PlanteAmigor/Piano_64/doc/720p先行与1080p优化.md

# 720p 先行与 1080p 优化

先交付 1280×720、约 60.606 Hz 完整功能固件，之后独立优化 1920×1080 60Hz。蓝牙 v3 收谱、SD 自动存储与目录刷新、多乐器自动演奏、教学兜底、三页界面和音频修复在两个目标中共用。

720p 保留 1650×750 的行场总周期，恢复此前板上可用的单 PLL：75 MHz 像素时钟、375 MHz 串行时钟，刷新率约 60.606 Hz。先前精确 60 Hz 的两级 PLL 固件在板上 HDMI 无信号，已撤回；声音和灯正常，SRAM 同固件对照仍无信号，说明故障集中于显示链路，具体模拟时钟原因尚未实测确认。逻辑界面坐标仍为 1920×1080，以 3:2 采样输出，页面无裁剪。

切换：`python3 tools/set_video_mode.py 720p` 或 `python3 tools/set_video_mode.py 1080p`。工具同时修改 RTL 模式头文件和像素/串行时钟约束，随后必须 `./build_full.sh` 完整构建。烧录前 `./flash.sh --check` 核对源码、固件及全局 setup/hold 均通过。

本轮共用优化：播放器和预览共享同一事件数组，后续继续检查物理 RAM 推断；FAT 扇区缓存合并为单写口；文件长度计算分级寄存；SD 校验计数按字节并行计算进借位。这些改动保持文件格式和播放行为不变。

720p 烧录后，1080p 实验在独立源码快照进行，板上保持已验证的 720p 固件；只有新的完整时序通过后才替换。

## 单 PLL 修复版验收

2026-11-04：用户确认相同固件临时加载后亮屏、三页正常。随后使用 openFPGALoader 完成 Flash 写入、100% 读回校验和重载，退出码为 0。固件 SHA-256 为 `7ec417b53ac864cedb204301f05d1f85b0a656a2c812bb86e7ae63e6755717c5`。全局 setup/hold 零违例，最小报告 setup 余量 +1.573 ns，BSRAM 329/340。用户随后确认断电重启后三页显示仍正常，Flash 冷启动验收通过。

旧标签 `720p-btsd-flash-20261104` 对应无信号的双 PLL 版本，已撤回使用，不移动该标签。新版本另建单 PLL 标签，交付记录保留失败经过。

## 低延迟720p更新

2026-11-04：第二版低延迟固件已由用户确认画面、按键与声音均正常，随后完成Flash写入与100%读回校验。当前固件SHA-256为`01198ac8a7547f963be728f345e2334af594c40e91f66b9439eac5f6e02bdff7`；按下确认0.5ms、释放确认20ms，18个数字链路场景最大2.794ms。此次冷启动仍待独立确认，详见[固化交付报告](720p_低延迟固化交付.md)。1080p实验继续独立推进。

2026-11-04追加确认：用户断电再上电后确认“断电重启后画面、按键和声音都正常”，本次低延迟720p的Flash冷启动验收通过。此前“冷启动待确认”描述为历史阶段状态。
