PlanteAmigor/Piano_64/doc/1080p30_完整候选.md

# 1080p30 完整版实测记录（2026-11-04）

## 当前状态

已通过离线检查，并用 openFPGALoader 成功临时加载 SRAM。用户随后明确回复“三页、按键和声音都正常”，完成本持续三页完整版本的实物验收。此前轮换诊断版的主页面、蓝色及独立彩条也全部可见；本次反馈独立对应完整版。

本1080p30.303完整版已于2026-11-04固化Flash并通过100%读回校验，用户已确认冷启动后三页、按键和声音正常；main已更新为本版。1080p60.606 完整工程的实物黑屏问题仍未解决。

## 模式与资源

- 输出：1920×1080，2200×1125 总时序，约30.303Hz；不是精确30Hz。
- 单 PLL，综合器确认像素75MHz、串行375MHz。
- 全局 setup/hold 违例：0/0；最小报告 setup 余量 +1.333ns。
- BSRAM 313/340，Logic 57976/138240，Register 41067/139095，DSP 157.5/298。
- FS SHA-256：`b415d6f7619be92d72ee1d4ecf28be18f72244677ebdc6c01758b69f92541508`。

## 验证

- `python3 tools/check_all.py --bt`：退出0，68条PASS，包括教学、真实曲谱、多音色、蓝牙原生SD写入再读回及远程播放、混响I²S等。
- 原厂 DPB/PLL/OSER10 模型专项通过；差分引脚独立解码验证上电及外部复位后完整UI非黑色行，未强制页面、亮度、计数器或RGB。
- 13张实际RTL页面渲染与上一完整1080p候选逐像素一致。首次渲染调用的Verilator路径错误，未生成有效结果；修正路径后的单独调用退出0，13张均通过，未将首次失败标为通过。
- 音频与按键源码指纹与此前18个端到端延迟场景完全一致，沿用既有测量，本轮未重测这些场景。原始按键引脚变化到完整I²S字的最大记录仍为2.794ms，前提为样本已预加载、有效静态手势及相同DDR等待模型；不含模拟DAC、功放、声传播，也不代表任意机械抖动上界。按下确认0.5ms、释放确认20ms。
- `tools/check_build.py`确认源码、约束、FS/BIN指纹一致，综合器时钟正确且全局setup/hold为0/0。
- 仅选择 SIPEED 2025030317；首次openFPGALoader SRAM加载退出0；随后已追加Flash固化及100%读回校验。

## 复现与证据

选择模式：`python3 tools/set_video_mode.py 1080p30-single`；完整构建：`bash build_full.sh`；功能检查：`python3 tools/check_all.py --bt`。

本地原始记录位于 `work/hdmi_production30/`：`results.json`、`auxiliary_verified.json`、`screens_compare.json`、`verification.json`、`board.json`、`acceptance.json`、构建与仿真日志；冻结的匹配固件及时序报告在 `offline_verified/`。`diagnostics/hdmi_link/program_production30.py`会复核上述门禁后只加载SRAM。

## 下一项60Hz实验

`diagnostics/hdmi_link/build_serial_clock.py`冻结独立快照，以150/750MHz输出1920×1080约60.606Hz，并让第四路OSER10输出固定时钟字，使时钟与三路数据经过同类串行输出路径。其独立引脚接收测试同时检查时钟字相位、RGB/同步和自然启动。这只是待验证的物理链路假设；通过数字模型或时序不代表实物黑屏已修复。实验不修改本1080p30生产输入，不自动上板或固化。

用户验收对应FS指纹与SRAM加载记录已关联；原始加载时的pending字段保留为当时记录，以独立`acceptance.json`记录后续通过。追加固化已完成并通过100%读回校验，用户已确认冷启动后三页、按键和声音正常。

固化记录见`1080p30_Flash固化记录.json`。原始RAR及其SHA-256保持不变；外部交付说明与验收文件追加本次固化状态，RAR内部仍保留打包时的SRAM验收状态。
