PlanteAmigor/Piano_64/doc/1080p60_串行时钟实验.md

# 1080p60.606 串行时钟对照实验（2026-11-04）

主工程1080p30.303完整版已由用户确认“三页、按键和声音都正常”，保存匹配固件作为回退点。Flash仍为已验收720p。

## 对照设计

独立冻结完整工程快照，模式改为单PLL150/750MHz；第四路OSER10串行输出固定字`0000011111`，使转发时钟与三路数据经过同类IO串行输出。原数据串行器和配置GSR策略保持一致。此为物理链路假设，不视为黑屏根因已确认。

`build_serial_clock.py`生成快照并验证：差分引脚接收的时钟字与数据字相位、RGB色序/完整行/HS，以及完整UI上电与外部复位后的非黑色行。全部使用原厂PLL/DPB/OSER10模型。

## 首次结果

`work/hdmi_serial_clock60`编译完成，综合器确认四路OSER10和150/750MHz。全局setup有2个违例，hold为0：

- 教学区路径`py -> roll_area1`最差-0.021ns。
- 叠加颜色至淡入路径`liss5 -> fade_g`为-0.013ns。

未加载该时序未通过固件。原始失败报告与输入指纹保留在快照中。

## 针对性修正

`--optimize-ui`生成另一个快照`work/hdmi_serial_clock60_opt`，不改主工程已验收30Hz输入：

1. 在写入py同一拍预计算教学区纵向范围标志，后续roll_area保持原像素拍数。
2. 用并行优先级掩码替换串联RGB图层选择，保持所有图层原先的覆盖顺序。
3. 保留rgb_base寄存器边界。

原厂模型的串行输出与自然启动检查已通过。`check_ui_equivalence.py`将两个真实UI模块并列运行，在512种叠加组合、16档淡入和随机颜色、全部12位坐标轴及另一轴窗口边界下比较RGB/淡入/区域标志的寄存器拍数，共81925周期一致；13张完整RTL页面与已验收30Hz版逐像素一致。该测试中的局部force只用于等价比较，不替代另行通过的无force自然启动检查。

修正版编译完成，但全局setup出现116个违例、hold为0，最差setup为-2.706ns，因此仍未上板。功能等价不代表物理时序通过；保留该失败布局证据，后续单独继续优化。用户要求先发布已验收1080p30，当前优先完成该版本打包和GitHub主分支更新。SD、蓝牙、音频、按键源码和物理约束未改，不通过放宽约束消除违例。上板入口`program_serial_clock.py --optimize-ui`只允许冻结输入匹配、全局setup/hold0/0、四路OSER10及上述等价检查均匹配的固件临时加载SRAM。
