PlanteAmigor/Piano_64/doc/1080p_黑屏排查.md

# 1080p完整工程黑屏排查（2026-11-04）

完整单PLL150MHz候选虽通过全局setup/hold 0/0、功能与延迟回归，但用户实测为“有信号但黑屏”，尚未交付验收通过。Flash及main仍保持已验收低延迟720p。

已完成对照：

- 重新加载此前单PLL150MHz彩条，用户确认彩条正常；这与完整工程黑屏形成同一显示连接下的对照。
- 新彩条仅换成当前完整工程使用的额外像素输入寄存器，FS为`c29fe32cba714bc15732725ab97001033a6e074ce44e667d44831120ab3ee708`；全局setup/hold 0/0、独立引脚解码通过，用户也确认彩条正常。
- 新增自然启动测试，不强制页面、亮度、计数器或RGB；没有外部上电复位脉冲时，完整UI仍输出非黑色画面。外部复位后同样通过。
- 完整UI与原厂PLL、DPB、OSER10、差分输出模型共同运行；上电和复位后各四条完整1920像素非黑色行均从差分引脚独立解码通过。该模型检查未复现实物黑屏。

目前尚不能把根因归于淡入、初始化或器件频率限制。完整工程与独立彩条的物理时钟布线不同，平均频率和数字模型仍不能证明实际串行链路可靠。

正在独立冻结快照`work/hdmi_black/full_debug`构建诊断版：保留完整音频、SD、蓝牙与UI；自动循环原UI、用UI同步输出固定蓝色、独立同步彩条、原UI，每档约1.342秒。UART暂时改发HDMI诊断状态，含锁定、复位、淡入级别、行列位置、帧计数及是否曾输出有效/非黑色像素。该多位跨域快照仅用于近似诊断，不用作产品数据协议。

构建入口为`diagnostics/hdmi_link/build_full_debug.py`，诊断快照的两条旁路经`check_full_debug_sim.py`验证，`program_full_debug.py`只允许输入指纹匹配、综合器时钟正确、全局setup/hold 0/0的快照临时加载SRAM。尚未加载或验收诊断版。

诊断构建进展：150MHz完整诊断版出现131个setup违例，hold为0，最差-2.720ns，未加载。新增诊断改变了物理布局，多条原UI路径余量不足；不以放宽约束换取通过。保留该快照，另建75/375MHz单PLL的完整1080p30.303诊断版（`--half-rate`），像素时钟与约束同步变更。这是用户已允许且彩条已实测显示的真实低刷新率模式，不把150MHz路径按75MHz假定检查。主工程及Flash仍保持原状态。

1080p30.303完整诊断版已通过：全局setup/hold 0/0，最小报告setup +0.629ns，75/375MHz时钟配置；两条诊断旁路的原厂模型引脚检查也通过。FS SHA-256为`50457fffc8eff4ed63e4a1f537e772d9063ac3efe5bb9c07bfcc03a29544e9b6`。加载时SIPEED 2025030317不在USB枚举列表中，openFPGALoader报告device not found，未改变板上固件；等待重新连接后立即加载。尚未宣称此完整诊断版实物通过。

最新实物结果：1080p30.303完整诊断版已成功加载，串口取得287个新状态样本，各模式均锁定、各路复位释放、淡入级别15，曾输出有效和非黑色像素。用户最终更正为原页面、蓝色及独立彩条“都看得到”，因此该诊断版三条图像路径实物显示通过；本轮未单独验收声音。下一步构建持续显示三页的正式1080p30候选；150MHz完整工程黑屏仍未解决。

正式1080p30.303完整候选已通过全局setup/hold 0/0，最小报告setup +1.333ns、68项功能回归和13张页面比对，通过源文件指纹核对沿用18项既有音频延迟记录。已成功临时加载SRAM，FS为`b415d6f7619be92d72ee1d4ecf28be18f72244677ebdc6c01758b69f92541508`；持续三页及音频等待用户验收。详细记录见`1080p30_完整候选.md/.json`。另建独立150MHz串行时钟实验，当前不宣称60Hz已修复。

最新验收：正式1080p30.303完整候选临时加载后，用户明确确认“三页、按键和声音都正常”。该版本可作为已实测的高分辨率回退点；仍未固化Flash，60.606Hz实验继续独立进行。
