PlanteAmigor/Piano_64/doc/1080p_单PLL完整候选.md

# 单PLL完整1080p候选（2026-11-04）

当前状态：1920×1080、约60.606Hz完整工程构建及数字验证通过，但用户实测“有信号但黑屏”，验屏失败。已重新加载先前同款单PLL彩条，用户确认彩条正常。用户已确认同款单PLL彩条正常；完整三页、音频与按键仍须单独实物验收。Flash保持已通过冷启动的低延迟720p。

## 时钟与构建

采用50MHz×15的750MHz单PLL；像素150MHz、串行750MHz。2200×1125总周期，对应60.606Hz，**不是精确60Hz**。可选`1080p30-single`采用相同VCO、75/375MHz，约30.303Hz，彩条也已由用户确认正常。

级联PLL的1080p30/60彩条未正常显示，1600×900 CVT-RB也无信号，完整实测矩阵见[多分辨率记录](HDMI_多分辨率实测.md)。平均计数和锁定状态正常仍不能代替抖动/眼图测量，物理根因尚未确认。

本次全局setup/hold均0违例，最差报告setup余量+0.005ns；BSRAM 313/340，Logic 57976，Register 41067，DSP 157.5。时序通过只对应本次报告条件。

FS SHA-256：`fdbd34467f1a0a12651968bd1eacd440ed179e7ae74b3c142410ba9abd2b50b3`。源文件、约束、hex及FS/BIN均由构建清单校验。

## 变更与验证

- 将已亮屏的单PLL链路接回完整工程，新增显式模式名`1080p-single`，同步生成实际150/750MHz约束；720p与旧精确60Hz实验模式仍可选择。
- 根据上一份原生分频完整构建的实际关键路径，将翻页计数器的6/12位进位条件提前寄存；全部118800拍、进位边界、回绕和复位逐拍检查通过。
- 第一轮150MHz完整构建有41个setup违例（最差-0.332ns）、hold为0，已保存且未上板。第二轮据此分开SD空闲扇区递增和范围判断；无复位描述符数据捕获不再经过复位使能扇出；串行器前增加独立的像素输入寄存器。
- 描述符响应中途复位后无参数写入，重新启动后全部53个真实音符、8类表、507115个元素与P64一致；新增串行级已通过实际生产PLL/串行器的独立引脚接收检查。
- 68条PASS完整回归，包括教学、多乐器、演奏键、持续管乐、揉弦、混响和蓝牙存SD。
- 13张使用原厂DPB模型的1080p页面/蓝牙状态图与原候选逐像素一致，原有界面优化保留。
- 原厂显示RAM及单PLL周期共7项专项通过。数据装载控制变更后已重新执行18个端到端延迟场景：钢琴2.794ms、古筝2.692ms、唢呐1.871ms、笛子2.056ms、钢琴加混响2.794ms，均小于5ms；源码指纹与当前工程完全匹配。

延迟测试以有效静态手势、P64已加载和指定DDR等待/刷新模型为前提，不含模拟DAC、功放、扬声器及声传播。按下确认0.5ms、释放确认20ms保持不变。

## 复现与验收

```bash
python3 tools/set_video_mode.py 1080p-single
./build_full.sh
python3 tools/check_build.py
python3 tools/check_all.py --bt
python3 tools/check_video_primitives.py
```

实验分支为`candidate/1080p60-after-keys-20261104`，主分支仍是已验收720p。源码中保留了用户此前在`src/add_engine_harm.v`注释前的空格改动；未混入提交，字节差异已记录于JSON。当前匹配固件和报告已另存`work/hdmi_single150_v2/offline_verified`。

先临时加载SRAM，检查显示器识别、三个页面、下落音符、频谱/李萨如、钢琴/古筝、管乐长按、混响和键盘快速/同时按下。用户确认前不把彩条通过等同于整机通过，也不将本候选写入Flash。断电仍恢复720p。

SRAM加载记录：openFPGALoader 返回0，FS指纹与本次构建一致，Flash未写入。重新加载的同款单PLL彩条再次由用户确认“正常了”；完整三页与声音验收尚待回复。

最新实物反馈：完整工程有信号但黑屏，彩条对照正常。完整工程未通过实物验收，正在检查实际像素输出、启动复位及与彩条的串行器差异。
