PlanteAmigor/Piano_64/doc/HDMI_多分辨率实测.md

# HDMI多分辨率实物对照（2026-11-04）

本记录替代此前“下载器未连接、全部候选待验屏”的阶段状态。用户重新连接SIPEED 2025030317后，以下彩条均已成功临时加载SRAM；Flash保持已通过冷启动的低延迟720p，未写入实验固件。

| 分辨率 | 计算刷新率/Hz | 像素时钟/MHz | 时钟方案 | 用户观察 |
| --- | ---: | ---: | --- | --- |
| 1280×720 | 60.606 | 75.0 | 单PLL | 彩条正常 |
| 1920×1080 | 60.000 | 148.5 | 级联PLL+原生分频 | 未正常显示 |
| 1920×1080 | 60.000 | 148.5 | 级联PLL独立像素输出 | 未正常显示 |
| 1920×1080 | 30.000 | 74.25 | 级联PLL+原生分频 | 未正常显示 |
| 1920×1080 | 30.303 | 75.0 | 单PLL | 彩条正常 |
| 1600×900 | 59.825 | 97.5 | 单PLL | 未正常显示 |
| 1920×1080 | 60.606 | 150.0 | 单PLL | 彩条正常 |

结论：在同一连接下，单PLL的1080p30.303和1080p60.606彩条均已显示；级联PLL的1080p30/60均未正常显示。级联时钟因此是重点排查对象，但尚无示波器抖动/眼图测量，不能认定物理根因。1600×900 CVT-RB约59.82Hz也未显示，尚不能区分显示器模式兼容性与该PLL配置因素。

本次通过的是1920×1080、约60.606Hz彩条，不是精确60Hz，也不是完整三页/音频功能验收。显示器信息页尚未独立确认。完整单PLL工程现已通过全局setup/hold 0/0检查（最小报告setup +0.005ns）、68条PASS回归、18个端到端延迟场景及13张原厂显存模型页面检查，并已临时加载SRAM；完整三页和声音仍等待用户验收。详见《1080p_单PLL完整候选》。

完整工程选择器新增`1080p-single`及`1080p30-single`，与既有`720p`、精确60Hz的`1080p`实验模式区分；工具同步修改RTL和约束，必须重建后使用。诊断新增综合器实际时钟计算核验，排除仅靠SDC或行为模型掩盖错误倍率的情况。首次1600×900分数配置在行为模型为97.5MHz、综合报告为95MHz，已在上板前撤回并保留为失败记录，改为25MHz×39÷10整数配置，才进行此次实物测试。

所有彩条加载前均检查源/固件指纹、全局setup/hold及独立串行模型。UART早期捕获含上一固件缓存，仅末尾窗口归于当前固件；后续加载工具已加入缓存清除和末尾计数核验。

复验：`diagnostics/hdmi_link/build_matrix.py`、`check_sim.py`、`program_probe.py`均支持上述模式。配套JSON保存每次实际固件指纹、UART原始记录及用户反馈。旧原生分频离线报告作为历史保留，其当前实物状态应以本表为准。

最新实物验屏未通过：用户反馈完整工程有信号但黑屏；重新加载先前彩条、以及替换为当前生产串行器的新彩条均正常。自然启动完整UI与原厂串行输出模型也已通过非黑色像素检查；完整诊断快照正在构建，根因尚未确定。参见《1080p_黑屏排查》。
