PlanteAmigor/Piano_64/doc/1080p60_原生分频诊断.md

# 1080p60 原生分频方案：离线验证与待验屏

日期：2026-11-04。当前状态：完整构建和数字验证通过，实物显示尚未验收。板上 Flash 仍是用户已确认断电重启正常的低延迟 720p。

## 本轮改动

实验分支：`candidate/1080p60-after-keys-20261104`。已合入主分支低延迟修复和冷启动确认；HDL基点为`6ef5e295ece43e6c35636a45c3599d7a71136568`。

- 1080p参考PLL采用曾测得27.5MHz输出的50MHz×22÷40配置。
- 742.5MHz串行时钟经原生CLKDIV五分频，提供148.5MHz像素时钟；像素与串行时钟使用同一输出源。
- 1080p的OSER10依赖配置GSR初始化并持续运行，像素编码器仍在锁定前保持复位。720p分支保持已验收方案。
- 同步更新时钟约束与构建检查，额外核对综合工具自己计算的频率。保留既有UI、教学、多乐器、混响、蓝牙存SD和低延迟功能。

以上仍是实验性显示链路修正，不能据此认定此前“无信号”的物理原因已经排除。

原厂[DS1239-1.0.3E 数据手册](https://cdn.gowinsemi.com.cn/DS1239E.pdf)第2.11.3节列出GW5AST-138的VCO范围650～1300MHz；当前参考PLL的1100MHz和视频PLL的742.5MHz均在此范围内。此项仅核对配置范围，不代替板上锁定、抖动或输出电气测量。

## 完整构建

1920×1080，2200×1125总周期，目标60Hz。实际源文件与FS/BIN指纹匹配，全局setup/hold为0/0违例，最差报告setup余量 **+0.016ns**。该余量很小，仅表示本次报告通过，不据此外推其他温度、电压或硬件条件下的裕量。

| 资源 | 使用/总量 |
| --- | ---: |
| Logic | 58056/138240 |
| Register | 41175/139095 |
| BSRAM | 313/340 |
| DSP | 157.5/298 |

FS SHA-256：`f87ef520aa4938fe0c855b57b9f522d3afaa2be38d43abab62e06f6dc0508978`。

构建保留了此前用户工作树中`src/add_engine_harm.v`的一处注释前空格差异，未将它混入本轮提交；完整字节指纹和该差异记录在配套JSON中。

## 验证结果

- `68`条PASS完整回归，包含菜单消抖、曲谱、混合乐器教学、真实P64参数、管乐持续、古筝揉弦、混响I²S，以及蓝牙→SD写入/读回/目录刷新/重试幂等。
- 18个真实按键→DDR仲裁→合成/效果器→完整I²S数据字场景全部低于5ms。最大值：钢琴2.794ms、古筝2.692ms、唢呐1.871ms、笛子2.056ms、钢琴加混响2.794ms。
- 原厂DPB、PLL、CLKDIV模型共7项专项检查通过；120000个混响立体声样点与独立模型一致。
- 独立串行接收器验证四组彩条诊断，检查启动及外部复位后的各四条完整彩条行，覆盖通道对齐、差分极性、RGB顺序、有效/总行宽和HS宽度。
- 原生分频方案另以13/117/499/713/999ns五种配置GSR释放时刻重复检查，全部通过；专项入口为`diagnostics/hdmi_link/check_startup.py`。
- 整帧2200×1125计数、HS/VS、坐标、帧回绕及RGB同步管线由完整UI时序回归验证。串行专项本身未遍历完整VS帧。

按下确认0.5ms、释放确认20ms保持不变。上述延迟以有效静态手势、P64预加载及指定DDR等待/刷新模型为前提，不包括模拟DAC、功放、扬声器和声传播，也不构成任意机械抖动下的全局上界。

## 实物状态与下一步

上一份独立PLL输出像素时钟的完整1080p候选曾时序通过、上板无信号，历史记录保留在`1080p60_候选验收.md`。

本次原生分频彩条的SRAM加载尝试失败：`unable to open ftdi device: -3 (device not found)`，未成功加载任何诊断固件。当前未检测到此前序列号2025030317的SIPEED下载器；没有改用电脑上其他板卡的下载器，也没有改动Flash。

接回同一下载USB并保持板子上电后，先运行：

```bash
python3 diagnostics/hdmi_link/program_probe.py div5_ref
```

只有加载成功后才确认彩条是否可见、显示器是否识别1920×1080 60Hz。诊断固件没有SD、音频和UI。若无信号，用`control720`做同一线缆/显示器对照，再比较其他1080p组；同时读取独立50MHz域UART中的PLL锁定状态和时钟计数。

彩条通过后，完整固件先执行`python3 tools/check_build.py`再临时加载SRAM，检查三页、教学下落音符、频谱/李萨如、四种音色、混响和演奏键。主分支与Flash只在实物验收后提升。断电可恢复已验收720p。

## 复验入口

```bash
./build_full.sh
python3 tools/check_build.py
python3 tools/check_all.py --bt
python3 tools/check_video_primitives.py
python3 tools/check_reverb_pipeline.py
python3 tools/check_key_latency.py
python3 tools/check_key_latency.py --timbre 0 --effect 1
python3 diagnostics/hdmi_link/build_matrix.py
python3 diagnostics/hdmi_link/check_sim.py
python3 diagnostics/hdmi_link/check_startup.py
```

同一时间只运行一个Gowin构建。配套JSON保存源码/固件指纹、测试退出码、各次延迟测量与串行诊断记录。数字仿真、全局时序通过均不能代替物理HDMI验屏。

更新：下载器接回后，原生分频和彩条级联方案均未正常显示，单PLL1080p彩条通过；当前结果见[多分辨率实物对照](HDMI_多分辨率实测.md)。本文件其余内容保留该次构建的历史状态。
