PlanteAmigor/Piano_64/doc/1080p60_候选验收.md

# 原生1080p60时序通过候选（2026-11-04）

当前状态：整机综合、布局布线和功能仿真通过，但上板显示失败（无信号），已撤回候选。首次临时加载因指定下载器未连接而失败；用户接回SIPEED下载器后，openFPGALoader已成功将上述固件加载到SRAM（退出码0）。用户确认显示器仍无信号，已成功恢复已验收720p至SRAM，720p Flash未修改。候选在独立分支保存，主工程仍保持已通过冷启动的720p版本。

## 实测构建结果

- 1920×1080，2200×1125总时序，148.5MHz像素时钟，精确60Hz。
- 全局setup 0违例，hold 0违例，最差报告setup余量+0.188ns。
- Logic 58987/138240；Register 41637/139095；BSRAM 313/340；DSP 157.5/298。
- 参考PLL：(50MHz/2)×33/30=27.5MHz，PFD25MHz，VCO825MHz；视频PLL：27.5×27=742.5MHz，/5生成148.5MHz像素时钟。
- FS SHA-256：83d85f4be99228dac00f6c039701e11602c0c1136c1b5fd9ad0c2111958d0d80。

## 本轮变更

文字ROM和李萨如扫描地址提前寄存；显存读写请求寄存后直接驱动八块正常写模式DPB；事件RAM共享端口A地址，使事件存储不再重复。分散显示复位与32个下落音符描述符的坐标扇出；进度条和力度条采用分段比较；翻页计数使用分段进位。混响梳状寻址分成多个短周期，SD引导区几何在接收期间提前计算。模式选择增加一个50MHz周期寄存。没有放宽像素时序约束，没有降低刷新率。

## 验证

- 完整功能回归含曲谱、教学、真实音色数据、持续管乐、揉弦、混响I²S和蓝牙→SD保存/读回链路。
- 普通行为模型与原厂DPB模型各13张RTL页面图，与基准逐像素一致。
- 原厂DPB三种规格的整块RAM独立Bresenham/清屏/衰减比较，以及级联PLL频率/锁定模型共7项检查通过。原厂仿真不能替代上板锁定和显示验证。
- 120000个混响立体声样点与独立取模地址/饱和模型一致，含满幅、反向、随机、旁通和50000样点静音尾音；覆盖245632个饱和边界。
- 256组FAT16/FAT32引导区参数以连续实际字节输入测试，独立核对分区、FAT、数据区和根目录地址（含32位回绕）。
- 翻页计数118800拍完整周期、全部进位边界、八组本地复位逐拍一致检查通过。

复验：`python3 tools/check_all.py --bt`、`python3 tools/check_video_primitives.py`、`python3 tools/check_reverb_pipeline.py`。页面原厂模型可用`python3 tools/render_ui1080.py --vendor-ram --bt`；`--verilator`可指定本机Verilator加速。视频原语工具的`--prim-sim`可指定安装的Gowin GW5A库。

## 上板待办

仅在`python3 tools/check_build.py`通过后，临时加载SRAM，不写Flash。检查显示器识别1080p60、三个页面、下落音符、实时频谱和李萨如；再试听钢琴/古筝、长按管乐和混响。用户确认后再提升主工程。

回退标签：`720p-flash-coldboot-ok-20261104`。断电重新上电仍启动此前已验收720p Flash。旧双PLL标签`720p-btsd-flash-20261104`为已撤回版本，不使用。

## 未混入的待办

演奏键目前仍20ms稳定消抖和40ms重触发屏蔽，尚不满足5ms按键到声音延迟要求。低延迟方案需单独实现并测端到端延迟。本候选也保留原115200蓝牙设置；BT36出厂波特率与网页握手问题另行核对，不能将协议仿真通过视为实物蓝牙问题已修复。

本文件保留的是低延迟合入前的失败候选历史；当前原生分频实验见[最新诊断记录](1080p60_原生分频诊断.md)。
