PlanteAmigor/Piano_64/doc/720p_低延迟固化交付.md

# 720p 低延迟固化交付

日期：2026-11-04。用户确认修正版画面、长按、快速连按、多键与声音均正常，授权固化和上传GitHub。主分支保留全部现有界面、教学、多乐器、混响与蓝牙存卡功能。1080p实验独立推进。

## 当前理论延迟与数字链路验证

50MHz下，演奏键按下连续确认25000周期，为0.5ms；同步及边沿检测另需数个时钟。音频采样周期20.48µs（48828.125Hz）。原来的40/120/340ms固定屏蔽已移除；声部分配时立即占位，旧尾音复用前先淡出，静音后才换参数。

| 通路 | 原始按键至完整I²S数据字的仿真最大值 |
| --- | ---: |
| 钢琴 | 2.794ms |
| 古筝 | 2.692ms |
| 唢呐 | 1.871ms |
| 笛子 | 2.056ms |
| 钢琴＋混响 | 2.794ms |

18个指定场景均低于5ms，覆盖首次起音、同键重按、和弦和尾音复用。测试实例化实际add_top、P64参数DMA、DDR仲裁、合成、限幅、效果器和I²S引脚接收；DDR模型包含64～72个100MHz周期的返回等待与周期性刷新背压。有效静态手势和P64已加载是前提。

这些数字是可复现的条件仿真结果，不是任意触点抖动或DDR等待下的全局上界，也未计入模拟DAC、功放、扬声器和声传播延迟。用户试听已确认正常，但未进行示波器/音频回录延迟测量。

释放采用20ms连续确认，避免2ms方案将长回弹误判为松键并重复起音；松开不足20ms的同键重按可能被合并。5ms目标指按下起音，释放确认时间与自然余音/效果器尾音另计。

## 验证与固化

68项PASS回归，全局setup/hold均零违例；报告最差setup余量+0.021ns，BSRAM329/340。时序余量较小，不据此外推温压条件之外的裕度。

用户已确认当前SRAM版本画面、按键和声音均正常。openFPGALoader已对同一固件完成Flash写入与100%读回校验，退出码0；本次断电冷启动尚待单独确认。先前UART两次窗口无字节仍作为独立诊断现象保留，未改光学代码。

固件SHA-256：`01198ac8a7547f963be728f345e2334af594c40e91f66b9439eac5f6e02bdff7`。

## 复现入口

```bash
python3 tools/check_all.py --bt
python3 tools/check_key_latency.py --timbre 0
python3 tools/check_key_latency.py --timbre 1
python3 tools/check_key_latency.py --timbre 2
python3 tools/check_key_latency.py --timbre 3
python3 tools/check_key_latency.py --timbre 0 --effect 1
./build_full.sh
./flash.sh --check
./flash.sh --ftdi-serial 2025030317
./flash.sh -f --verify --ftdi-serial 2025030317
```

完整工程入口为build_full.sh，默认720p；早期build.tcl和piano64.gprj只对应历史原型。SD卡使用真实P64.BIN和SONGxx.BIN。RAR包含当前Git源码、匹配固件与报告、验证日志、P64.BIN和原稳定720p回退固件；不包含Git凭据、.git或实验工作目录。

2026-11-04追加确认：用户断电再上电后确认“断电重启后画面、按键和声音都正常”，本次低延迟720p的Flash冷启动验收通过。此前“冷启动待确认”描述为历史阶段状态。
