PlanteAmigor/Piano_64/doc/曲谱教学模式设计.md

# 曲谱播放与教学交付说明

日期：2026-11-03。工程：`piano64_3`。本文件取代此前 `.P6S + DDR 曲谱区` 的设计稿；实际采用 v3 `SONGxx.BIN` 帧流和片内事件 RAM。M6+ 下落音符、BT36、SD 写入属于后续阶段。

## 交付状态

| 阶段 | 本次实现 | 验证边界 |
|---|---|---|
| 原工程优化 | 唢呐/笛子 DMA 顺序移位拆包；古筝音高控制寄存；顿音/吐音按采样计时 | 53 个音、8 类表、507,115 个元素与真实镜像一致；1600 采样保持及 16 采样音量斜坡通过 |
| M1 | v3 帧校验、事件 RAM、调度器、2048 条边界与异常拒绝 | SONG01 全部 47 条一致，0 ms 四声部同时处于 gate 高；四首歌曲共 104 条逐条回读一致 |
| M2 | P64 校验成功后第二遍列目录；按选择读取 SONG，跨时钟 FIFO 旁路到事件 RAM | 文件服务模型与真实读卡栈 + SDHC CMD/DAT 虚拟卡端到端通过，包含 FAT32 碎片簇链；真实卡上板待验收 |
| M3 | 音高/触发/gate/力度接入音频引擎，教学页旁路“无手静音” | 接线、仿真和 SIPEED SRAM 下载完成；DAC/扬声器听音仍待现场验证 |
| M4 | 歌曲列表、自动/教学模式、倒计时、按键指示、错误页、停止/返回 | 长短按、退出停止、损坏拒绝和重载恢复通过；5 张实际 RTL 像素截图已检查 |
| M5 | CDEFGAB 固定键位、跨八度共用、独立事件结束、±150 ms、节拍兜底与正确恢复 | 提前、迟到、黑键、错键、漏按、重复音、重叠窗口和 ±150 ms 边界均通过仿真 |

最终资源/时序数据见同包 `reports/build_summary.json` 和原始 Gowin 报告。只将来源一致、setup/hold 均无违例的构建登记为可下载版本。已通过 SIPEED 下载器完成板卡 SRAM 下载；现场听音和实际延迟仍待验收。

菜单消抖修复版完整构建于 2026-11-03 19:54 完成，采用布局算法 3、布线算法 2：Logic 40,629/138,240，Register 26,629/139,095，BSRAM 307/340，DSP 158/298；全局 setup/hold 违例均为 0，报告中的最小 setup 余量为 **+0.009 ns**。时序余量很小，本包固件对应本次已通过的布局布线；重新综合后必须重新检查时序，不能仅凭生成了位流判断通过。下载脚本的来源与固件哈希校验已通过。

## 上板操作

1. FAT32 SD 卡根目录放置 **真实四音色 P64.BIN** 以及 `SONG01.BIN`～`SONG04.BIN`。交付包 `sd_card/` 已备好；不要使用 `work/song_checks/P64.BIN`，它只是 2048 字节仿真夹具。
2. 首次使用 SRAM 临时下载：在工程目录执行 `./flash.sh --check` 核对构建，再执行 `./flash.sh`。脚本使用 `impl/pnr/piano64_full.fs`，板型 `tangmega138k`。需要长期保存时自行执行 `./flash.sh -f`。
3. 等待原有 P64 加载与校验。按板上 KEY0，页面按 **主页面 → 测试 → 教学 → 主页面** 循环。
4. 教学列表中，**R1[8]（第一排第 9 键）短按下一首**；**R2[8]（第二排第 9 键）短按确认**。
5. 选中歌曲后，R1[8] 切换 AUTO PLAY / TEACHING；R2[8] 开始。运行时 R2[8] 停止；**长按 R2[8] 约 0.8 秒返回**。长按释放不再重复触发确认。切出教学页会停止歌曲。
6. TEACHING 有 3 秒准备时间。**第一排 R1[0..6] 固定对应 C D E F G A B**，与八度、原手动音色的键位映射无关；R1[7] 不参与教学判定。LED 提示音级，画面 `*` 表示需按，`+` 表示已匹配。

菜单 R1[8]/R2[8] 使用独立两级同步与双边 40 ms 消抖：按下、松开都必须连续稳定，短按在确认松开后只执行一次，持续按住不连发。演奏键仍沿用原扫描路径。`tb_song_keys` 用同一抖动波形复现旧版一次跳三首，并验证修复后一次一首、模式/确认不重复及长按返回释放抑制。

演奏键 R1[0..7] 使用两级输入同步和稳定电平模式：按下和松开都必须连续稳定 `DEBOUNCE`（默认 20 ms）才更新，避免单触点微动开关的松开抖动将一个按键变成虚假的松键/重按。实际音符键在全工程此前也已等待 20 ms 才确认按下；本修复将相同确认规则应用到松开，并为 `key_scan` 补上原来缺少的异步输入两级同步。`tb_key_scan_bounce` 对比旧版和修复版，检查旧扫描在释放抖动后产生假边沿/卡键，而新扫描每次真实按键只产生一个按下、一个松开。数字仿真覆盖的是同步后抖动行为，不能模拟真实模拟亚稳态或证明板上噪声的全部来源。

复音分配器的键归属增加一个可表示空闲标记的位宽，避免八键配置下 `KEY_FREE=7` 与真实键 R1[7] 冲突。旧版可复现第八键松开后 gate 仍保持高；`tb_note_alloc_release` 检查八键各分配一次、第八键独立松开及全部 gate 清零。

列表按照 FAT 枚举顺序显示文件本来的两位编号，不假定它们连续或按编号排序；最多 16 首、每页 8 首。精确匹配大写 `SONG00.BIN`～`SONG99.BIN`，不读子目录。

示例曲谱：SONG01《小星星》钢琴 47 事件；SONG02《茉莉花》古筝 30 事件；SONG03《小星星》唢呐 14 事件；SONG04《茉莉花》笛子 13 事件。

## 教学发声规则

- 到曲谱节拍时，即使没有手、没有按键，白键音符仍按**该事件正常力度的一半**准时起音，持续到各自曲谱结束。漏按不拖慢后续节拍，也不会因等待按键丢掉旋律。
- 在事件前 150 ms 内按对，对应起音使用正常力度；在事件后 150 ms 内按对，当前半力度声音按每毫秒增加 8/255 的速度恢复到正常力度，**不重新触发音头**。这些数值是引擎线性力度值，听感响度并非严格减半。
- 正常引擎力度为 MIDI velocity×2，兜底为 MIDI velocity；例如曲谱力度 100，对应正常 200、兜底 100。教学且有手时再叠加光学力度；自动模式不要求手参与。
- 同一时刻、同一音级的多八度和弦共享一次正确按键，各事件仍按独立时长结束；相邻重复音不能重用之前的提前按键。重叠判定窗口中的迟到按键优先对应最近已起音的一组。
- 已匹配的白键声部随对应物理键松开而释放；未匹配的半力度兜底保留曲谱时长。引擎原有自然包络、延音效果仍影响最终声音尾部。
- 黑键音符正常力度自动播放，不参与键盘判定。按错不会另触发声音；错误按键在匹配等待窗口结束后计数。
- 钢琴/古筝最多 8 声部；唢呐/笛子沿用原工程共享单音参数缓冲，限 1 声部。音高和音色由文件决定。

## 数据链路与接口

```
原有 P64.BIN → 原有 SD→DDR→读回校验
                         ↓ 成功后
SD 第二遍列目录 → SONGxx.BIN 字节流（晶振 50 MHz）
  → Gray 指针异步 FIFO → 帧解析/校验（音频 50 MHz）
  → 2048×64 事件 RAM → 毫秒调度/教学判定 → 原音频引擎
  → 原子状态快照握手 → HDMI 75 MHz 教学页
```

SONG 字节不进入 DDR 音色镜像写入 FIFO。文件结束后，必须排空跨域 FIFO、解析 FIFO 和帧状态机，再提交可播放结果，防止 END 尚未处理就开始播放。每次新文件重置解析事务；加载取消后继续排空旧传输，再允许下一次请求。

事件 RAM 131,072 bit，目标占 8 块 BSRAM；完整链路还有解析和跨域 FIFO。不要把整机资源增量都算成事件 RAM。保持原异步时钟约束，没有通过给新增同步路径设假路径消除违例。

v3 帧：`A5 5A 03 | type:u8 | seq:u8 | payload_len:u16LE | payload | crc16:u16LE`。CRC16/CCITT-FALSE 覆盖帧头到 payload，poly=0x1021，init=0xFFFF。

- BEGIN(type=1)：`count:u16, duration_ms:u32, timbre:u8, flags:u8`，flags 使用 0。
- DATA(type=2)：`offset:u16` 后跟最多 32 条事件。
- 事件：`start_ms:u32, note:u8, duration_ms:u16, velocity:u8`，共 8 字节，全小端。
- END(type=3)：`count:u16`；实际写入数必须与 BEGIN/END 一致。
- 最大 2048 事件，按开始时间非递减排列，时长非零，力度 1..127。必须符合对应音色音域和并发上限。错误不允许提交成可播放曲谱。

## 复现与维护

```bash
# 生成四首样例并自检；默认写入 tools/generated/
python3 tools/gen_song_v3.py

# 数据、教学、SD 接口、DMA、原音频控制回归
python3 tools/check_all.py

# 加上选歌/模式/教学/错误/等待五页的实际 RGB 渲染
python3 tools/check_all.py --ui

# Gowin 完整工程构建，并登记时序与来源指纹
./build_full.sh
# 其他安装位置可配置：GOWIN_SH=/绝对路径/gw_sh ./build_full.sh

# 校验源码、固件哈希及零时序违例；不连接硬件
./flash.sh --check
```

需要 Python3、Icarus Verilog；截图额外需要 Pillow；完整构建使用 Gowin V1.9.11.03 Education，器件 GW5AST-LV138PG484AC1/I0 Version C。产物为 `impl/pnr/piano64_full.fs` 和 `.bin`，默认下载 `.fs`。

主要变更：`src/song/song_system.v` 管理跨域流、RAM 和菜单；`song_loader.v` 管理协议校验；`bt_song_player.v` 管理节拍和教学；`sd_ddr_loader.v` 扩展第二次目录扫描；`add_top.v`/`piano64_top.v`/`hdmi_ui3_top.v` 完成接线和显示。

回归产物保存在 `work/song_checks/`，包括逐条 RAM 回读、各测试日志和五张 `ui0..4.png`；`tools/check_all.py` 会在缺少真实 P64.BIN 时明确失败，不会把短仿真镜像冒充音色数据。

## 现场验收剩余项

- 用真实 SD 卡冷启动，确认四音色镜像校验、第二遍目录和四首曲谱均能读取；交换文件写入顺序再验证编号正确。
- SRAM 下载本包固件，听 SONG01 开头四声部和弦厚度；确认无手也发声，停止/返回/切页不遗留持续音。
- 教学模式听提前、迟到、完全漏按、错按、黑键，确认半力度兜底与恢复没有重复音头；检查光学表情和按键/LED 对应。
- 使用耳机或示波器测量实际键控到音频输出延迟与异常噪声；仿真和时序通过不替代赛题要求的现场测量。

参考沿用工作区 `ref/bt36_v3` 协议/调度器、`ref/FPGA-SDcard-Reader` 读卡栈、现有 Gray 指针 FIFO 与赛题要求；未额外引入可综合 IP 依赖。SDHC 仿真使用同一开源项目的 `sd_fake.v`，位于 `sim/vendor/`，随附原 GPLv3 许可。原有手动工程中的用户未提交注释空格改动已保留。

### 笛子 / 唢呐长按持续发声（已更新）

- 保留约 1 秒的原始起音；随后在原音色约 1～2 秒稳态参数段连续往返，保留原生气颤及包络变化。每次坐标只移动一个样点，载波始终正向积分，避免冻结参数后气颤消失。长按不重触发、不重新搬运 DDR 表。笛子取消额外手势颤音，唢呐保留手势音高颤音。
- 移除 5 秒绝对停音上限；手动按键和曲谱均由 gate 决定时长。松键默认收音，开启延音时仍按原释放增益淡出；手离开仍经原手势闸门静音。
- 独立 29 位 dm 相位时钟，模 2^29 回绕。由于 dm 为整数，dm×11×2^29/1024 是整圈相位，回绕无相位突跳，避免长按约 21 秒时旧 20 位时间计数器溢出。
- `sim/tb_harm_hold.v` 读取真实 P64.BIN，经实际 DMA 和谐波流水线检查全部 53 音的稳态转接、持续非零 PCM、相位运行、弯音、时钟回绕、手离开/返回以及 gate 释放。为缩短仿真，跳过起音前段与每样点计算完成后的空闲时钟，并把独立相位时钟推进到 10 秒；并非逐时钟完整模拟 10 秒。听感仍需上板验收。

- 加强 PCM 正负半周检查后，旧谐波编号错误在笛子 MIDI 76 暴露：表索引 0 被直接当作谐波阶数 0。原始拟合与渲染模型（上级 `tools/harm_fit.py`、`tools/dizi_render.py`）使用 1..K。引擎现将合成阶数改为表索引 + 1，HDMI 分量显示索引仍为 0..K-1，避免基音被合成为近直流分量。

### 2026-11-03 琴键与持续吹奏版本上板记录

- 功能提交：`8a26158`（输入同步、双边消抖、第八键释放），`6ac9775`（持续吹奏、谐波阶数）。完整功能回归通过，真实 P64 的 53 音波形检查通过。
- 最终完整构建：setup/hold 违例均为 0；最差报告 setup 裕量 0.000 ns（现有 DDR 命令/地址路径），该路径余量较紧，后续修改仍需完整时序检查。
- 资源：Logic 40531/138240，Register 26510/139095，BSRAM 307/340，DSP 160/298。
- FS SHA-256：`091772ebf40e29970d2e818277fdfb71fd1f815ef298589cf54b27020634a1be`。
- 已通过 openFPGALoader 下载目标 SIPEED 调试器 `2025030317` 对应板卡 SRAM，返回 `DONE`，退出码 0。SD 文件无变化。
- 用户此前反馈：仅含双边消抖的中间固件暂未再出现炸音。最终组合固件的多键和持续 30 秒听感仍由用户上板复测确认。

### 原生气颤、古筝揉弦与李萨如修复

- 按用户确认，笛子仅使用音色自带气颤，不再叠加 G3 幅度/音高颤音。独立 AM 控制在顶层关闭，谐波引擎也固定单位增益。
- 唢呐/笛子的持续段采用参数往返读取，载波正向积分；端点不跳坐标。修正无符号 Q13.19 相位表跨 bit31 的插值，避免高音在约 2 秒处错误插值。
- 古筝揉弦与唢呐颤音的检测参考工作区五组实测光学记录：原有 12.5% 幅度门限、5～11 帧半周期拒绝全部 499 帧揉弦记录。改为约 3.125% 门限（最低 256）、4～24 帧半周期，同时要求至少两个新鲜有效交替间隔。静止/慢移测试无误触发，原揉弦记录 138/499 帧激活；收尾仍有保持时间。记录未包含横向位置，不能据此判定横向摇手的完整分类效果。
- 修正音高调制三角波后半段的位宽翻转，消除平均音高抬升。古筝真实模态引擎输出验证：调制比值 15872～16895，10918/11000 个 PCM 样点与未调制输出不同，手势结束回到中性音高。
- 钢琴/古筝李萨如默认 L4 短余辉、MID 平滑；切回吹奏音色恢复其默认档位，R2[0]/R2[1] 仍可手动调整。峰值参考两轴，新音清除旧轨迹，微弱尾部不再自动放大噪声。
- `tools/check_all.py --ui` 全部通过，包括实际 P64 的 53 音长按、松键/无手静音、原生气颤、光学记录回放及五页 HDMI 输出。`tools/check_sustain_curve.py` 检查全部 53 音载波正向及两端转向频率连续；`tools/check_liss.py` 提供修改前后轨迹比较（需 Git 基线 5ec3098、NumPy/Pillow）。
- 李萨如对比图使用真实 P64 参数生成模态输入，运行实际显示滤波、自动增益、画线及余辉 RAM；属于仿真图，不是板上照片。长按测试对关键位置加速推进，没有逐时钟渲染完整 30 秒音频；自然听感与实际手势舒适度需现场确认。

### 原生气颤 / 揉弦 / 李萨如版本上板记录

- 功能提交：`d70d2a8`。完整功能与 UI 回归全部通过；补充的 unsigned 相位跨 bit31 向量检查通过。
- 2026-11-03 21:30 完整构建结束，原布局 3 / 布线 2 与原约束：setup/hold 违例均为 0，最差报告 setup 裕量 +0.002 ns。余量仍紧，后续改动必须重新检查完整时序。
- 资源：Logic 40517/138240，Register 26499/139095，BSRAM 307/340，DSP 159.5/298。
- FS SHA-256：`4e1ac800a0ddb56f26f711a29bc6d3a77a24cb82e850f829a4c271e82807e594`。120 项构建输入及位流哈希通过 `flash.sh --check`。
- 已用 openFPGALoader 对指定 SIPEED 调试器 `2025030317` 完成 SRAM 下载，退出码 0，日志含 `DONE`；SD 文件无变化。实际长按气颤衔接、揉弦手感与李萨如屏幕效果待用户现场确认。

### 混响开启时噪音：I2S 样点完整性修复

用户确认四种音色均在混响弹奏时出现噪音，关闭后干净。混响算法文件并未在上一版变化，但原 `pcm5102a_tx` 每发送一位都会重新读取输入。混响在帧首 tick 后约 52 个系统时钟才更新，早于发送完成、晚于首个数据位，左声道因此可能混合前后两个样点的位；右声道又可能提前使用新样点，导致左右时刻不一致。

修复在左帧边界同时锁存左右 16 位输入，整帧序列化只读这份快照。采样节拍、BCK/LRCK 和 I2S 一位延迟不变；增加固定一帧（约 20.48 µs）输出缓冲。

新增 `sim/tb_i2s_reverb.v` 将实际混响模块接到实际 I2S 发送器，再从 BCK/LRCK/DIN 引脚解码，检查整帧快照、左右时刻、延迟位/填充位和 1024 时钟采样周期。3000 个立体声帧共 6000 个声道字，实际混响在发送期间更新 3001 次，包含 1761 个湿声样点：旧版 5564 个字与帧快照不一致，修复版为 0。旧版首帧左声道本应为 0，却输出 6808（既不是旧的 0，也不是新的 15000），直接复现位拼接损坏。该测试已纳入完整功能回归。

旧 `tb_rev_full.v` 的长尾检查仍显示约 −180 LSB 的负向量化残留，其 RMS 统计多累计了每样点 60 个时钟，显示值放大了 sqrt(60)。该旧检查不验证最终 I2S 比特流，不能用于证明演奏期间串行输出正确。本修复针对已复现的 I2S 损坏，保持现有混响滤波参数。实际噪音是否消失仍需同板听音确认。

#### I2S 混响修复完整构建及上板记录

- 功能提交 `3ab13f6`。完整功能回归全部通过；I2S 引脚级检查 6000 个声道字零错误。UI 无改动，沿用此前五页像素回归结果。
- 2026-11-03 22:00 完整构建完成，原布局 3 / 布线 2、原约束；setup/hold 违例均为 0，最差 setup 裕量 +0.002 ns。后续修改必须重新检查完整时序。
- 资源：Logic 40508/138240，Register 26531/139095，BSRAM 307/340，DSP 159.5/298。
- FS SHA-256：`0c70a6f07df44aba0b7e2ff2b3104ef490ee354823b3d64b9cf93c94f88423b9`；全部 120 项输入和两个位流哈希校验通过。
- openFPGALoader 对指定 SIPEED 调试器 `2025030317` 完成 SRAM 下载，最终 `DONE`、退出码 0。SD 卡数据未改动。四音色 NONE/REVERB 对比听音待用户现场确认。
