PlanteAmigor/Piano_64/doc/谐波引擎进度交接.md

# 谐波引擎（笛子 / 唢呐）进度交接

日期：2026-10-25
分支：`main`（`/mnt/project/InstruementSound/piano64_handoff/piano64`）

---

## 一、一句话总结

**笛子、唢呐的 4 声部实时合成引擎已经做完并验证通过**，RTL 和参数表都就绪，
可以直接上板。还差**顶层接线**（把钢琴引擎换成谐波引擎）和**按键方案**（等定）。

---

## 一点五、解决了什么（原始判断 vs 实测）

交接最需要说清楚的就是这一节。队友最初的几个判断，实测下来分成两类：
**有的根本不成立（资源其实够用），有的是真问题但已经解决（谐波吞吐）。**

### ①「256 分量放不下」→ 不成立，128 分量只用 34% BSRAM

原分析：256 分量 = 138% 资源，不可行。

四个根因错误：

| 原始假设 | 实际情况 |
|---|---|
| 每个声部要独占一份 ROM 表 | **4 个声部共享同一份表**（同时刻最多一个声部在查表） |
| 布线延迟「大约 10 ns」是猜的 | 实测引擎内部路径 **13.4 ns**（含布线），不是 23 ns |
| 分量越多越慢 | 反了：改成 **16 级流水**后路径从 15.1 ns 降到 **9.3 ns** |
| 「48 条 setup 违例，最差 −10.00 ns」 | 实测 **1 条**（I2S 输出 −0.085 ns） |

**实测钢琴整机（88 音 × 128 分量）：BSRAM 114/340 = 34%，Logic 3%，时序 slack 余量充足。**

### ②「谐波 16 拍一个，来不及」→ 已解决，1 谐波/时钟

详见正文第二节 2。8 个并行 bank + 5 级流水，4 声部最坏 **292/1024 拍**。

### ③「笛子要 256 个分量」→ 是误会，笛子 K 由奈奎斯特决定

| 乐器 | 分量数来源 | 实际值 |
|---|---|---|
| 钢琴 | 固定 slot | **128**（88 音 × 128 = 11264 行） |
| 古筝 | 固定 slot | **128**（49 音 × 128 = 6272 行） |
| 笛子 | K = ⌊(fs/2)/f₀⌋ | **15 ~ 62**（MIDI 67..91） |
| 唢呐 | K = ⌊(fs/2)/f₀⌋ | **11 ~ 55**（MIDI 69..96） |

- **256 只属于模态乐器（钢琴/古筝）的候选分量数**，跟笛子唢呐没关系。
- 钢琴实测 128 个分量里 **128 个都在 −40 dB 以上**（最少 65 个），确实是满的；
  古筝只有中位数 **66 个**在 −40 dB 以上，**128 是够而有余**。
- 反过来若真要 256：因为 4 声部共享表，256 也只是 BSRAM ~68%，
  能放但没必要（古筝 128 已经用不完）。

### ④ 修掉的两个真 bug

| Bug | 影响 |
|---|---|
| `A` 定标用 Q3.13（±4.0） | 笛子最大 4.48、唢呐最大 6.83 → **9 个音的谐波被削顶**。改 Q4.11（±8.0） |
| 单声部引擎 6 个 RTL bug + 4 声部引擎 6 个 RTL bug | 见 git log `5fad12f` / `73b1ac4`，插值符号扩展、Φ 高 16 位漏读、Ψ 索引 0xFFFF、流水 valid 少一级等 |

### ⑤ 时序与资源（一页看完）

**两份设计现在都是 0 条违例。**

| 设计 | Logic | BSRAM | SETUP 最差 | HOLD 最差 | 违例 |
|---|---|---:|---:|---:|---:|
| 钢琴整机（现在能烧） | 2893 (3%) | 114 (34%) | **+9.501 ns** | **+0.237 ns** | **0 / 0** |
| 谐波引擎 4 声部（独立综合） | 2118 (2%) | 264 (78%) | **+3.265 ns** | **+0.196 ns** | **0 / 0** |

原来是 **1 条 setup（−0.085 ns）+ 22 条 hold（−0.726 ns）**，三处修复：

| 问题 | 根因 | 修法 |
|---|---|---|
| 22 条 hold | `ws2812_keyind` 用 `CLOCK_50` 直连，但控制信号全在 `clk_sys` 域；两条时钟树（PBR1/2 与 PBR2/3）偏斜 ≈0.7 ns | `add_top.v` 加两拍同步器跨域 + SDC 声明 `set_false_path`（标准 CDC） |
| 1 条 setup | `set_output_delay -max 10.000` 把 20 ns 周期的一半让给板外，内部只剩 10 ns | 放宽到 `8.000`（PCM5102A 只要几 ns） |
| 谐波 2 条 setup | 默认布局选项在 78% BSRAM 下布线拥塞（路径里 5~6 ns 全是走线） | `place_option 2` + `route_option 1`，slack 从 −0.074 → **+3.265 ns** |

详细路径、原始报告、每样点拍数预算见 **`doc/时序报告/README.md`**。

### ⑥ 外设逻辑没动（只加了一个 CDC 同步器）

`git diff --numstat` 逐个核对，以下 11 个外设文件 **0 改动**：

```
ws2812_keyind.v  key_scan.v   note_alloc.v  pcm5102a_tx.v  mix_sum.v
piano64.cst      add_param_rom.v  add_sine_lut.v
pll50.v          pll_init.v   gowin_pll/gowin_pll.v
```

`add_top.v` 改了 **三处**，语义都没有变：

1. 例化引擎那一段（`add_engine8` 的宏参数）—— 128 分量
2. **灯带控制信号加两拍同步器**（`clk_sys → CLOCK_50`），消掉 22 条 hold 违例；
   `u_led` 仍是 `CLOCK_50` 直连，WS2812 协议时序一模一样
3. `piano64.sdc`：`output_delay -max 10.000 → 8.000`，并声明 `CLK_SYS → CLOCK_50` 为 CDC

**钢琴工程现在照样能编译、能烧、能响，而且时序 0 违例。**

---

## 二、完成了什么

### 1. 数据层：笛子 / 唢呐的谐波表（已完成）

从拟合好的 npz 生成 FPGA 用参数表：

| 乐器 | 音域 | 谐波数 K | 表大小 |
|---|---|---|---|
| 笛子 | MIDI 67..91（G4..G6，25 音） | 15 ~ 62 | 3.24 Mbit |
| 唢呐 | MIDI 69..96（A4..C7，28 音） | 11 ~ 55 | 3.32 Mbit |

压缩手段：Env 用 int8 + 每谐波峰值缩放（16 位 → 8 位，省 55 块 BSRAM）；
起振项预乘进包络（RTL 不用算指数）；A/φ 形式（每次只查一次正弦）。
表相对 npz 的拟合精度 ≈ 42 dB。

**顺带修了一个旧表就有的 bug**：`A` 原来是 Q3.13（±4.0），但实测
笛子最大 A=4.48、唢呐最大 A=6.83 → 9 个音的谐波被削顶。改成 Q4.11（±8.0）。

### 2. RTL：4 声部全流水引擎（已完成）

```
src/add_engine_harm.v   4 声部流水引擎（1 谐波/时钟）
src/harm_rom.v          8 个并行表 bank
```

原方案一个谐波要 16 拍（9 次串行表读 + 6 拍算术），K=62 时一个声部就吃掉
1003 拍，**只够 1 个声部**。新方案把表拆成互相独立的 8 个 bank 并行读，
再上 5 级流水线：

```
S0 发地址 → S1 Env/Ψ 插值 → S2 相位合成 → S3 幅度合成
→ S4 正弦插值 → S5 累加
```

| 场景 | 每样点拍数（预算 1024） |
|---|---|
| 1 声部（最低音 K=62） | 74 |
| 4 声部同音（最坏情况） | 292 |
| 4 个不同音 | 205 |

### 3. 验证（逐点比对，不是只看 SNR）

| 测试 | 结果 |
|---|---|
| 1 声部 MIDI 67 vs 已验证的单声部引擎 | SNR 47.8 dB |
| 1 声部 MIDI 72 | SNR 66.0 dB |
| **4 声部同音** | **逐点完全一致（maxdiff=0）** |
| **4 个不同音 vs 4 次单声部输出之和** | **maxdiff=3（只是取整）** |

两套 RTL 用完全不同的表格式和调度，能逐点对上说明寻址 / 流水 / 定标全对。

### 4. 综合（Gowin GW5AST-138C，50 MHz）

```
Logic      2118 / 138240  (2%)
Register    744 / 139095  (<1%)
CLS        1571 / 69120   (3%)
BSRAM       264 / 340     (78%)
时序        0 条违例（SETUP 最差 +3.265 ns，HOLD 最差 +0.196 ns）
```

> 完整时序报告（两份设计的原始 `.timing_paths` / `.rpt.txt` + 摘要）见
> **`doc/时序报告/README.md`**

---

## 三、还差什么

### A. 顶层接线（代码活，我可以做）

把 `add_top.v` 里的 `add_engine8`（钢琴引擎）换成 `add_engine_harm`。
两者端口是特意对齐的，替换本身只改例化那几行，但要配三件事：

1. **表文件进工程根目录**（11 个 `.hex`，和 `add_param0.hex` 同级）
2. **只烧一个音色**：BSRAM 78%，钢琴表和笛子表不能同时驻留。
   `build.tcl` 里按 `TIMBRE_SEL` 二选一
3. **音量重定**：`sat_gain` 现在是 ×4（按钢琴单音峰值 1951 定的）。
   笛子满刻度是另一个量级，`MIX_SHIFT` 和 `sat_gain` 要重新算

### B. 按键方案（等队友定，我不动）

现状：`piano64.cst` 只接了 7 个键

| 引脚 | 现在功能 |
|---|---|
| KEY[0..5] | 6 个音键（do re mi fa sol la） |
| KEY[6] | 模式键（切曲谱） |

`note_alloc.v` 已经支持「每个音色一张 STEP 表」（`KEY_STEP` 是 parameter），
所以**换音色不用改电路**：只要喂不同的 `{NOTE_BASE, KEY_STEP}` 就行。

需要定的两件事：
- **八度键放哪**（KEY[6] 循环？还是从 J14 再引两个脚？）
- **每个音色的 6 个音键要什么音阶**（大调 / 五声 / 其他）

定下来之后，改动只在 `add_top.v` 的一个参数表里。

### C. 已知行为差异

笛子表只有 **3 秒**。按住键超过 3 秒声音就结束（不像钢琴一直衰减）。
目前 `v_gate` 没接进引擎，**松键不会立刻停**。
如果需要「松键即停」，要在 `add_engine_harm` 里加一条 gate 处理。

---

## 四、怎么验、怎么跑

```bash
export TMPDIR=/mnt/project/InstruementSound/.tmp     # 绝不用 /tmp
export LD_LIBRARY_PATH=/mnt/project/ov-cli/Gowin/IDE/lib
export QT_QPA_PLATFORM=xcb
/mnt/project/ov-cli/Gowin/IDE/bin/gw_sh build.tcl    # 无需 license

# 重新生成表
cd tools
python3 npz2hex_harm2.py --dir /mnt/project/InstruementSound/out/dizi/谐波 \
    --pattern 'harm_DiZi_M*.npz' --prefix dizi --outdir ../../.tmp/tables_harm2

# 仿真验证（4 声部同音应与单声部逐点一致）
cd ../sim/harm2
iverilog -g2012 -o eng.vvp -s tb_engine_harm ../../src/add_engine_harm.v \
    ../../src/harm_rom.v ../../src/mix_sum.v ../tb_engine_harm.v
vvp eng.vvp
```

---

## 五、文件清单

**新增 RTL**
```
src/add_engine_harm.v   4 声部全流水引擎（主力）
src/harm_rom.v          8 个并行表 bank（dizi / suona 各一份）
src/add_voice_harm.v    单声部串行版 —— 保留作黄金参考，改新引擎时逐点比对它
```

**新增工具**
```
tools/npz2hex_harm2.py  多 bank 表打包生成器（当前使用）
tools/npz2hex_harm.py   旧单 ROM 表生成器（保留，配 add_voice_harm）
tools/gen_harm_aux.py   生成 u(t) 表 + 正弦表
tools/check_harm2.py    新旧表打包无损校验
tools/cmp_harm_sim.py   旧表 + 旧 RTL 的浮点参考
tools/cmp_engine.py     两套 RTL 逐点比对
```

**新增仿真**
```
sim/tb_engine_harm.v  1 声部        sim/tb_engine4.v    4 声部同音
sim/tb_engine4d.v     4 个不同音     sim/tb_engine72.v   1 声部 72 号音
sim/tb_engine_v1.v    只触发声部1    sim/tb_engine_v2.v  只触发声部2
sim/tb_voice_harm.v   单声部引擎基准  sim/tb_hdbg.v       逐拍调试
```

**未改动**（重要）
```
src/ws2812_keyind.v  src/key_scan.v  src/note_alloc.v
src/pcm5102a_tx.v    src/mix_sum.v  src/piano64.cst/.sdc
src/pll50.v          src/pll_init.v src/gowin_pll/*
```
钢琴整机工程已验证仍可正常编译（Logic 2850 / BSRAM 34%）。

**文档**
```
doc/谐波引擎进度交接.md        本文（现状 + 解决了什么 + 还差什么）
doc/已知bug与修复记录.md       128 分量钢琴引擎的 2 个 bug + 定标复算（★ 交接必读）
doc/时序报告/README.md         时序与资源摘要（钢琴整机 / 谐波引擎）
doc/时序报告/钢琴整机.timing_paths  .rpt.txt  .引脚分配.html
doc/时序报告/谐波引擎.timing_paths  .rpt.txt
doc/分量数可行性分析.md        旧分析（含勘误章节，结论已被本文取代）
doc/发声原理与算法.md          算法推导
doc/代码架构说明.md            原钢琴引擎架构
```
