PlanteAmigor/Piano_64/releases/1080p30-20261104/piano64_3_1080p30_完整已验收_20261104_说明.md

# 已验收1080p30完整版本

输出1920×1080、约30.303Hz。源码提交：`013b166b48a90e2ac62b1f12d87681209b38e8fd`。

用户已确认“三页、按键和声音都正常”。2026-11-04追加：已使用openFPGALoader将同一1080p30固件固化Flash，100%读回校验通过，用户已确认冷启动后三页、按键和声音正常。

保留三页界面、下落音符、多乐器自动播放/教学、蓝牙v3收谱并自动存SD、管乐长按及混响修复。按下确认0.5ms、释放确认20ms。与此前18项数字链路测量的音频/按键源文件指纹完全一致，最慢2.794ms；前提为样本已预加载、有效静态手势及指定DDR等待模型，不含模拟DAC/功放/声传播，也不是任意抖动与等待下的全局上界。

全局setup/hold违例0/0，最小报告setup+1.333ns，BSRAM313/340。68条功能回归PASS、13张完整页面比对一致；原厂PLL/DPB/OSER10模型下的自然启动与复位后串行引脚检查通过。

## 包内内容与使用

- `piano64_3/`：完整源码、参数/IP、工具与文档；`impl/pnr/piano64_full.fs`及`.bin`为匹配已验收固件，构建清单和时序报告同目录。
- `SD/`：真实P64.BIN和SONG01～05。原卡已具备文件时保留原内容；新卡按原工程FAT32要求准备后复制。蓝牙上传按原v3协议执行。
- `页面预览/`、`验证记录/`、`版本.json`和`SHA256SUMS`：页面、回归、构建、实测及逐文件指纹。归档包含构建时已存在的一个注释空格差异补丁，保证构建输入逐字匹配，不改动开发工作树中的该差异。

在`piano64_3/`运行：

```bash
./flash.sh --check
./flash.sh --ftdi-serial 2025030317 --write-sram --quiet
```

第一条只校验；第二条临时加载。需要固化时可自行运行`./flash.sh --ftdi-serial 2025030317 --write-flash --verify --quiet`，随后断电再上电检查三页、按键和声音。已追加完成固化和100%读回校验，用户已确认冷启动后三页、按键和声音正常。RAR内部说明保留创建时状态，以本外部追加记录为准。

源码默认选择`1080p30-single`；重建执行`bash build_full.sh`，功能检查执行`python3 tools/check_all.py --bt`。重新构建前可显式选择`python3 tools/set_video_mode.py 1080p30-single`。KEY0切三页；教学页R1[8]下一首、R2[8]确认，按曲谱自动切换乐器和八度；节拍点半力度兜底、±150ms内按对恢复正常力度。

固件SHA-256：`b415d6f7619be92d72ee1d4ecf28be18f72244677ebdc6c01758b69f92541508`。

GitHub默认源码及发行包现更新为本1080p30版本。旧720p可从历史及`720p-low-latency-flash-verified-20261104`标签恢复；1080p60实验的时序未通过固件未混入本包的`impl/pnr/`。
