PlanteAmigor/Piano_64/flt_cmp2.png

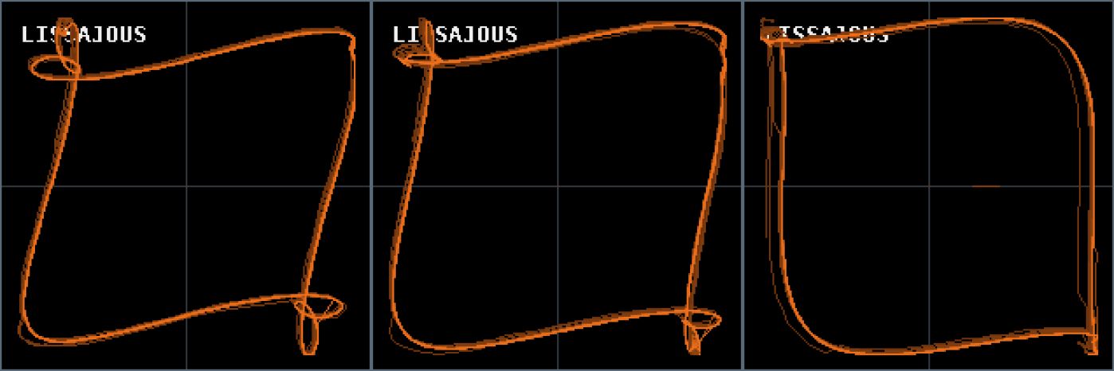
flt_cmp2.png
