PlanteAmigor/Piano_64/flt_cmp.png

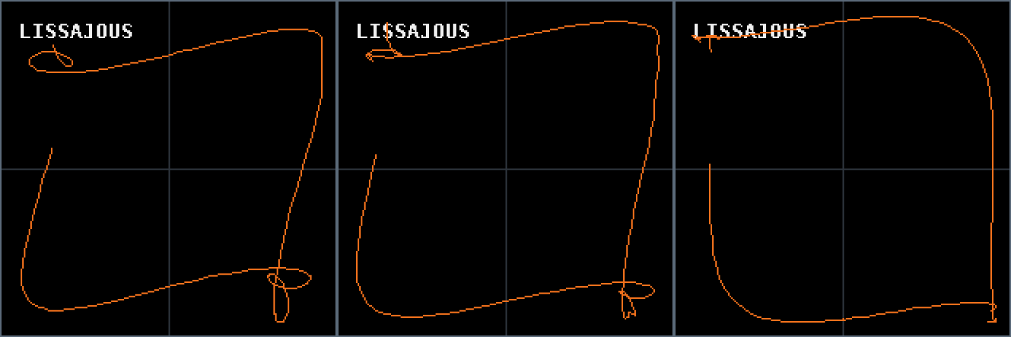
flt_cmp.png
