PlanteAmigor/Piano_64/frame_cmp.png

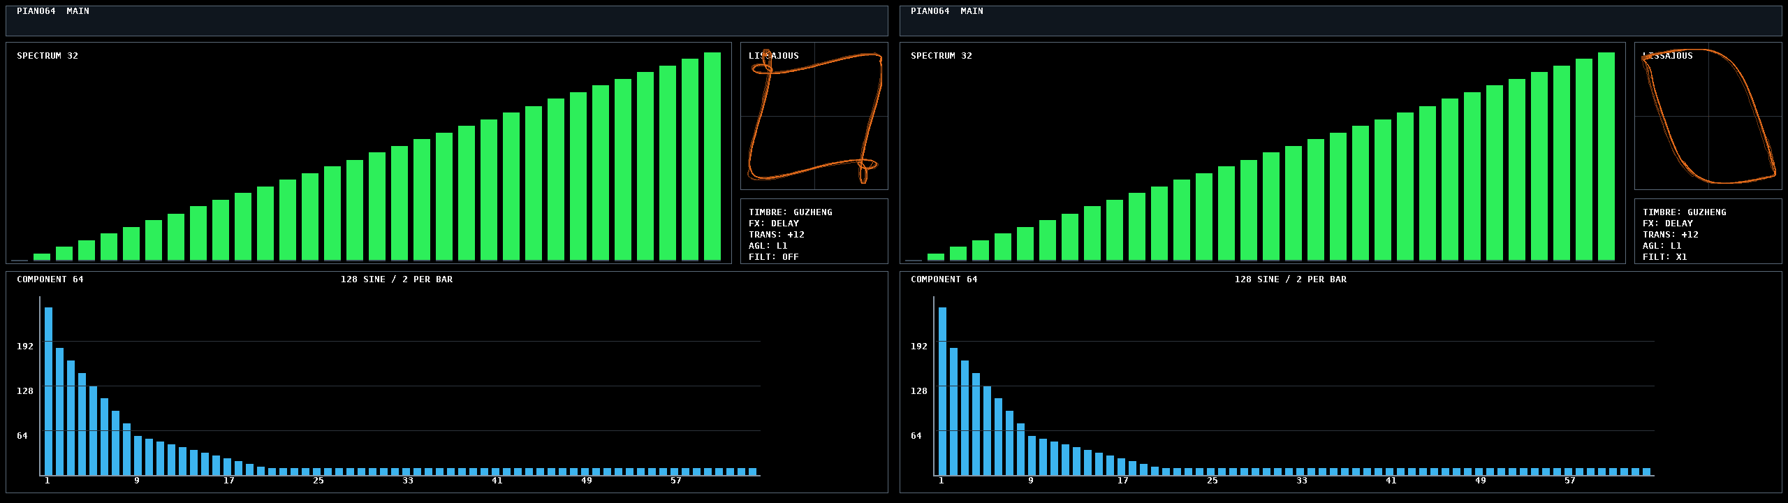
frame_cmp.png
