PlanteAmigor/Piano_64/frame_p0.png

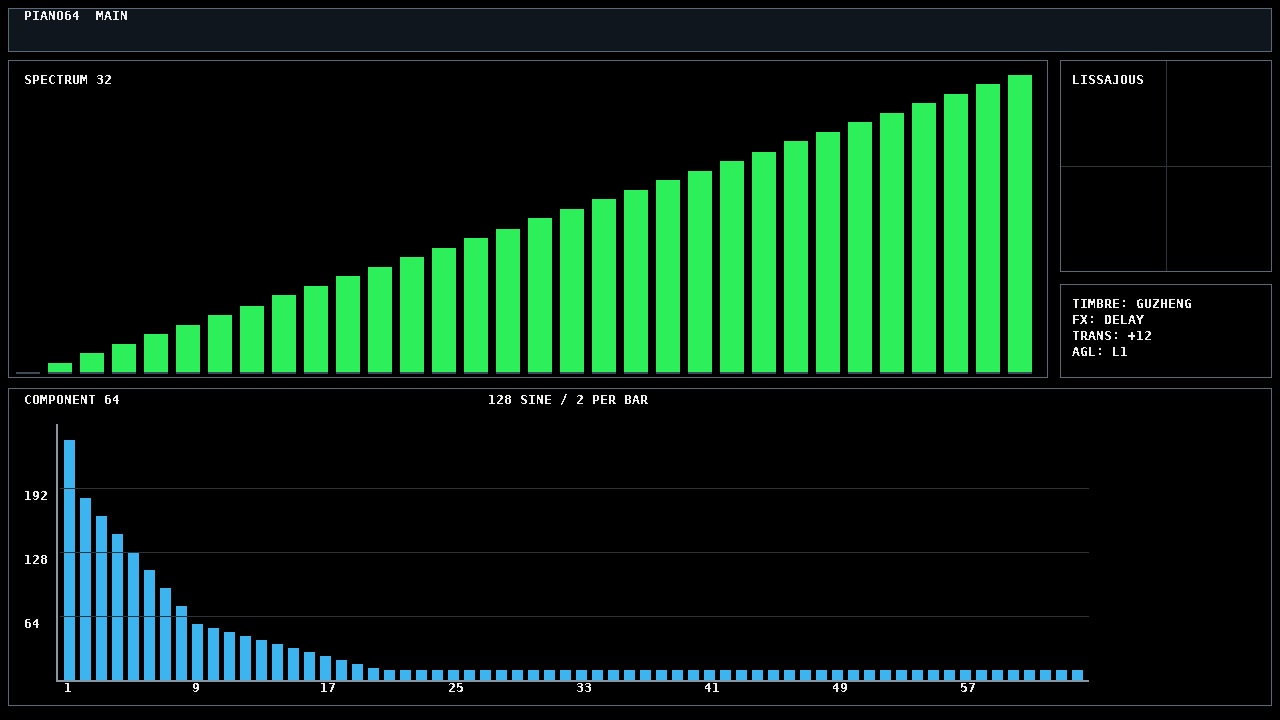
frame_p0.png
