PlanteAmigor/Piano_64/info22.png

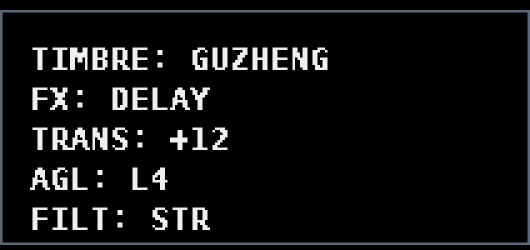
info22.png
