PlanteAmigor/Piano_64/infobox.png

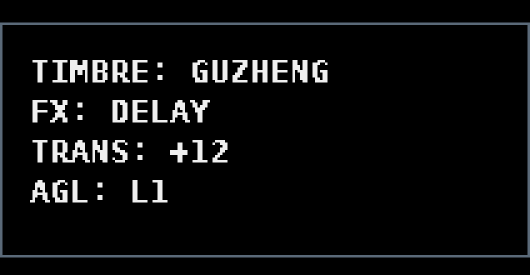
infobox.png
