PlanteAmigor/Piano_64/liss_a_full.png

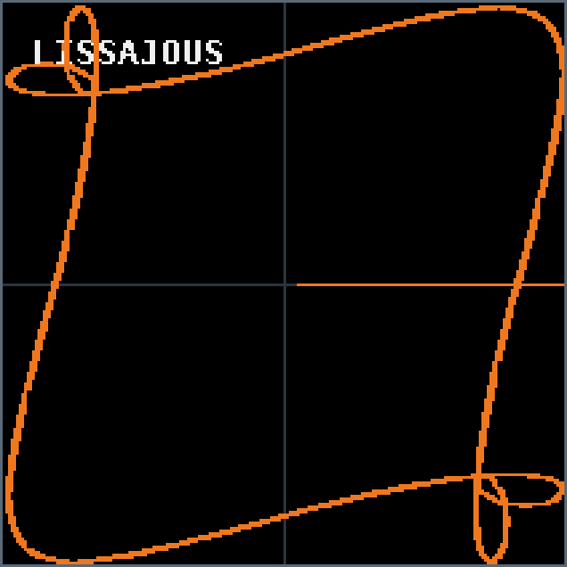
liss_a_full.png
