PlanteAmigor/Piano_64/liss_adapt.png

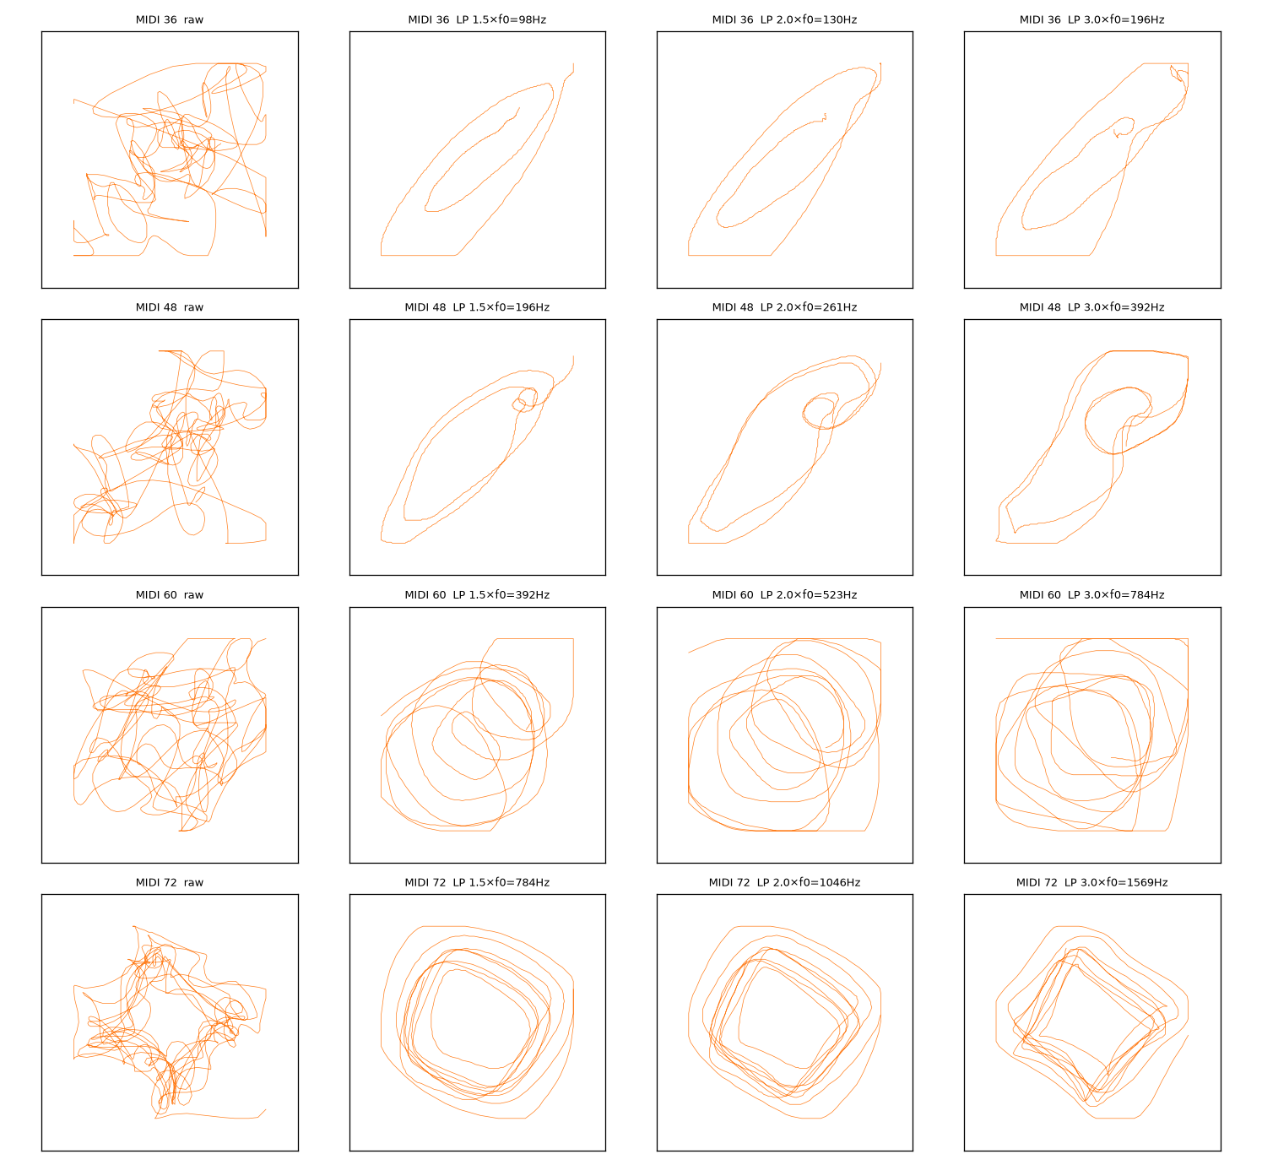
liss_adapt.png
