PlanteAmigor/Piano_64/liss_agl0.png

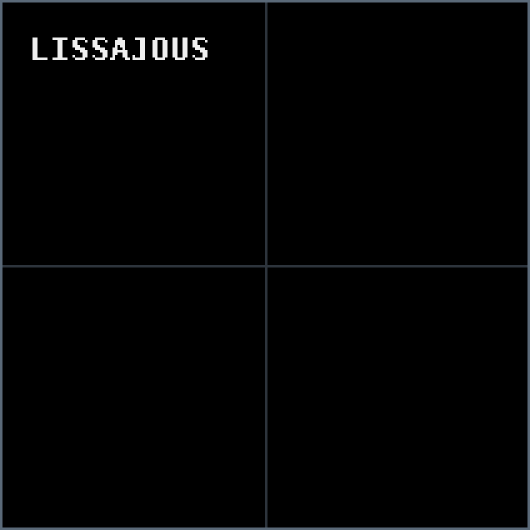
liss_agl0.png
