PlanteAmigor/Piano_64/liss_all.png

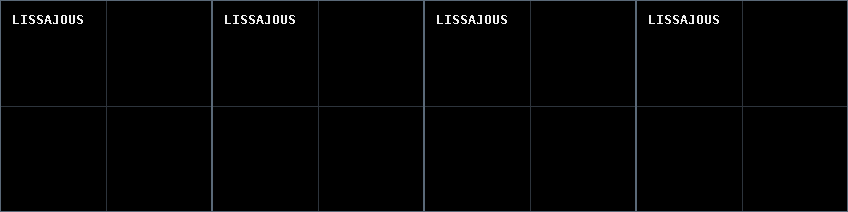
liss_all.png
