PlanteAmigor/Piano_64/liss_check.png

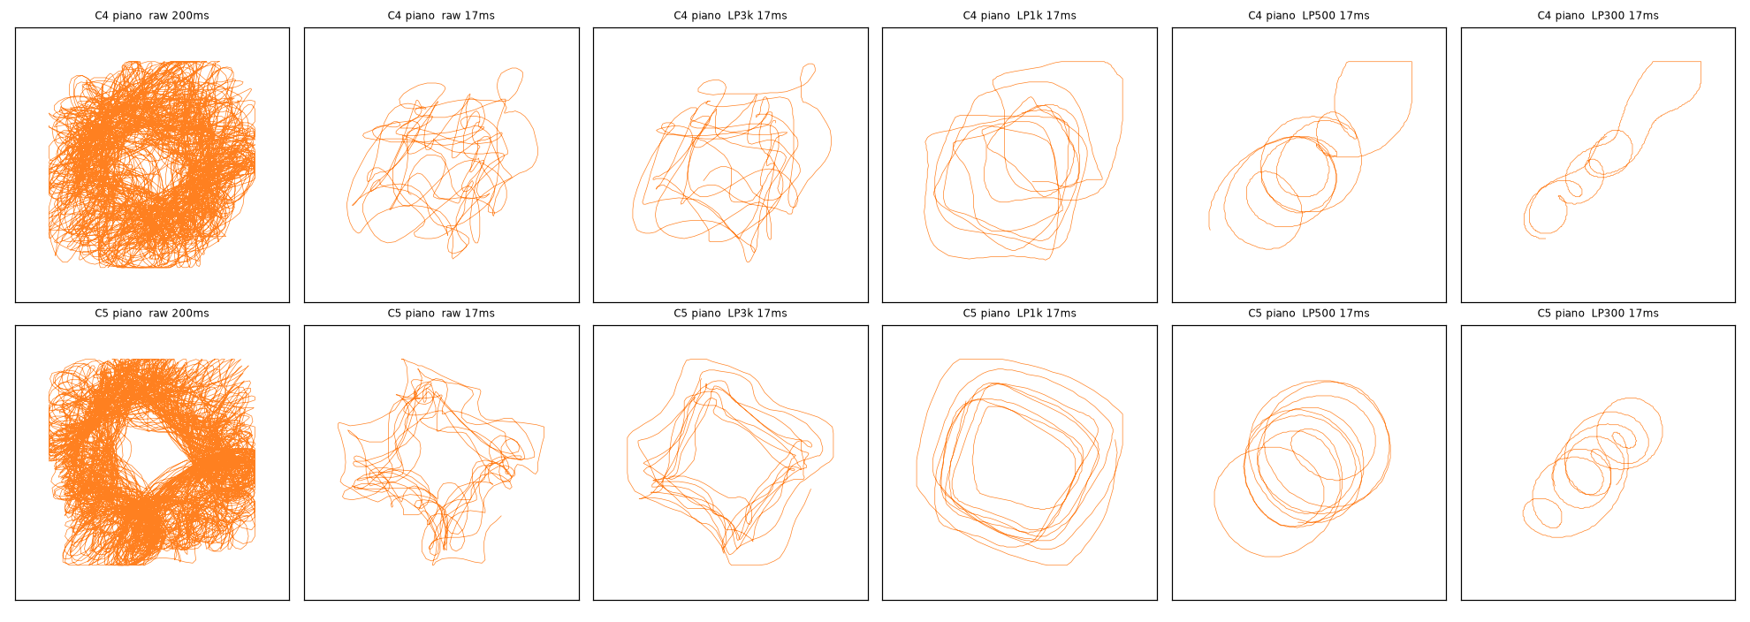
liss_check.png
