PlanteAmigor/Piano_64/liss_delta.png

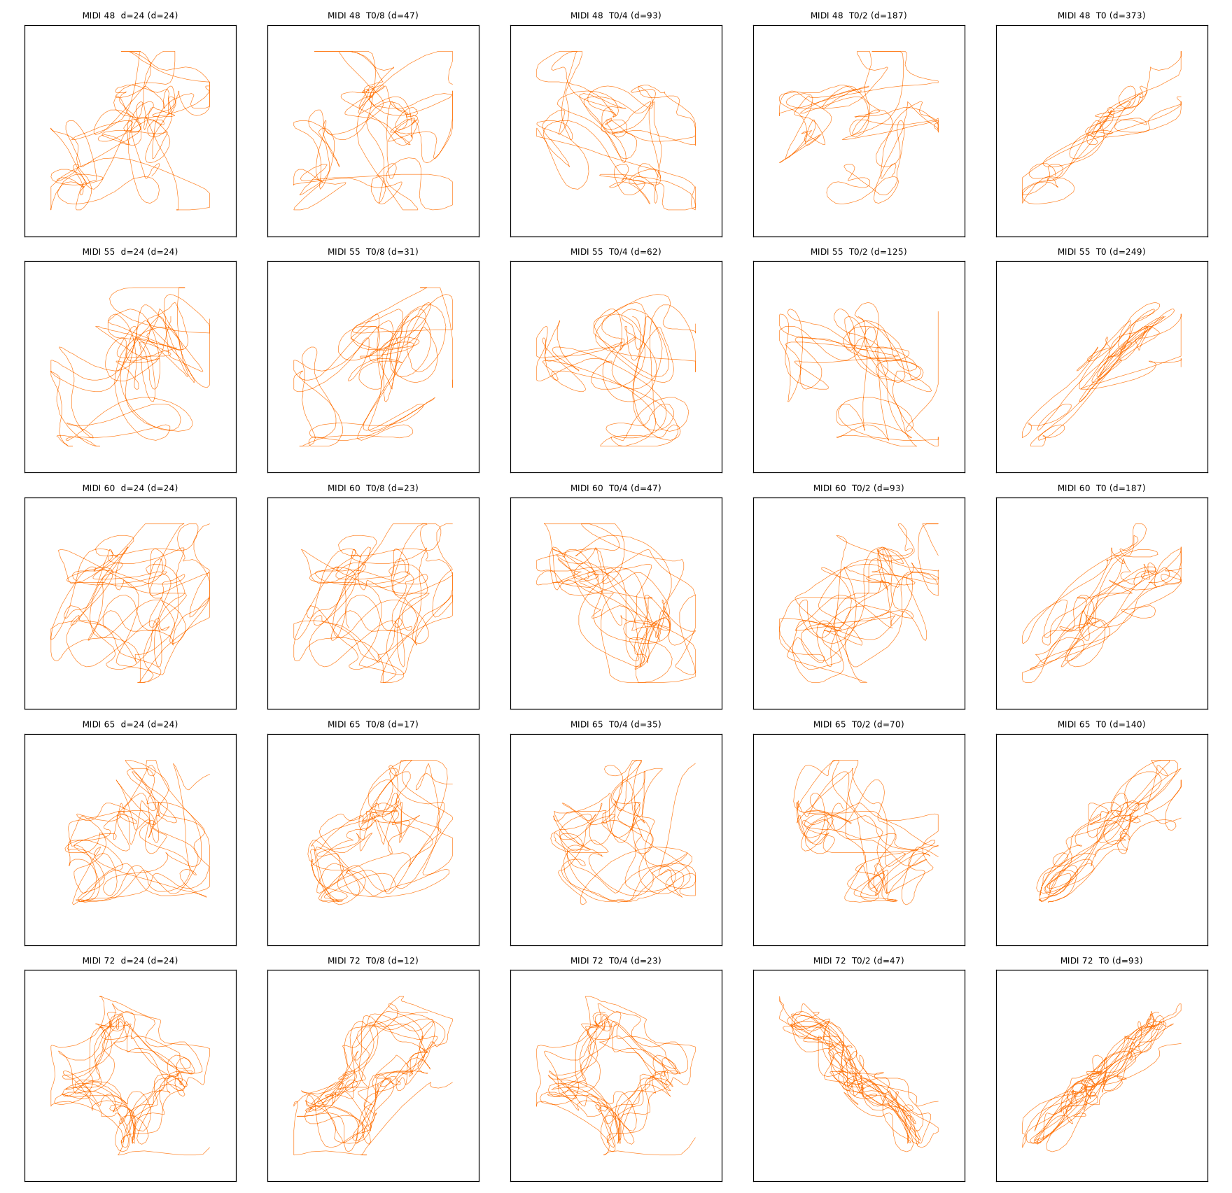
liss_delta.png
