PlanteAmigor/Piano_64/liss_harm.png

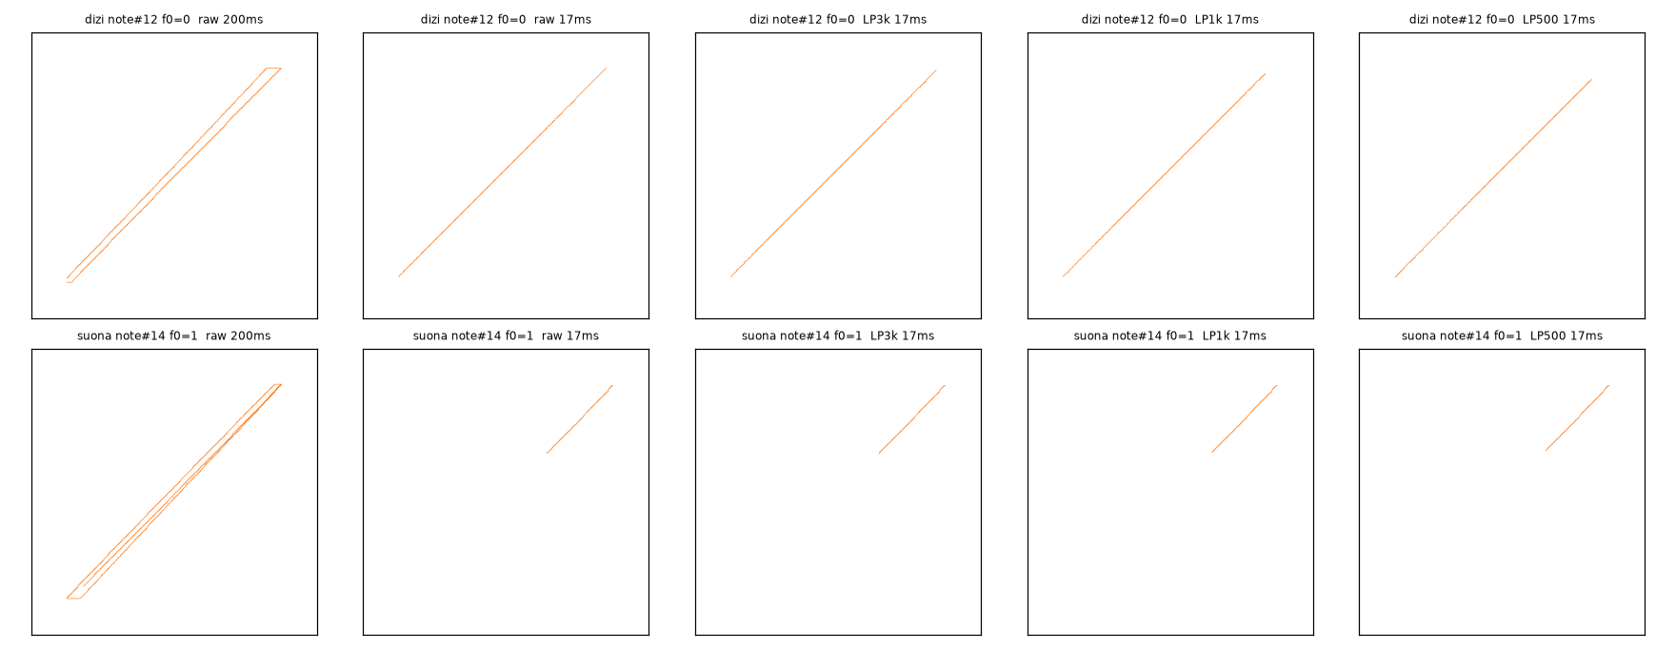
liss_harm.png
