PlanteAmigor/Piano_64/lissC0.png

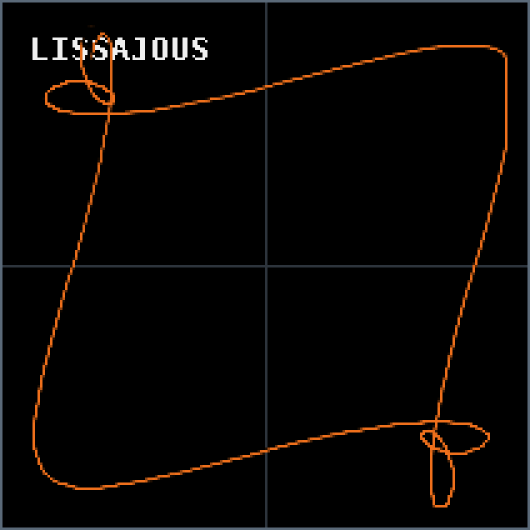
lissC0.png
