PlanteAmigor/Piano_64/lissD0.png

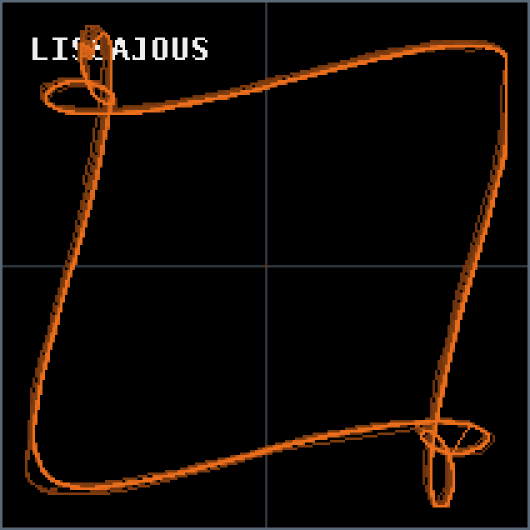
lissD0.png
