PlanteAmigor/Piano_64/lissF1.png

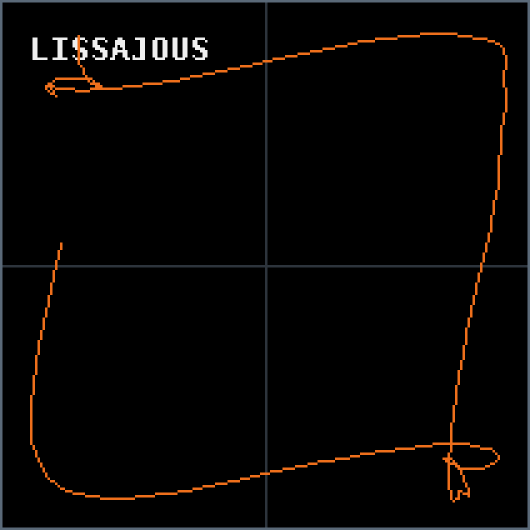
lissF1.png
