PlanteAmigor/Piano_64/lissF2.png

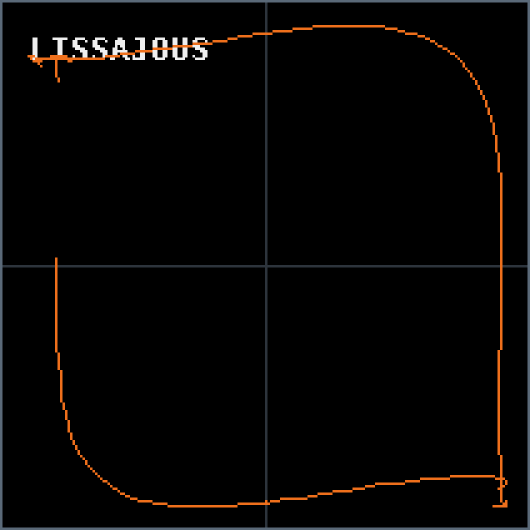
lissF2.png
