PlanteAmigor/Piano_64/lissH1.png

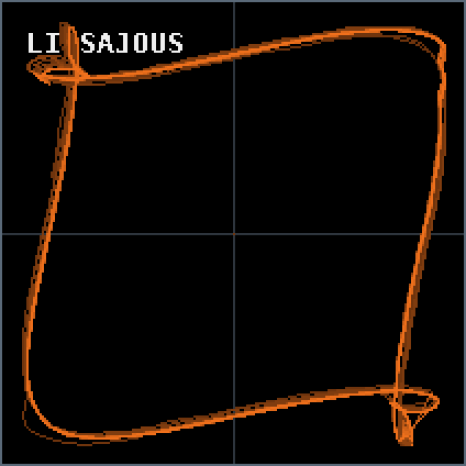
lissH1.png
