PlanteAmigor/Piano_64/src/add_top.v

//==========================================================================
//  piano64 —— 64 路加法分量钢琴（8 音键 + 移调键 + 2 个功能键）
//
//  按键：
//    · J13 双触点力度键盘 9 组：组 0~7 = 8 个音键，组 8 = 移调键
//    · KEY_AUX[0] (U38/C18) = 音色键：短按循环 钢琴→古筝→唢呐→笛子
//                             长按 1 s 循环效果器 NONE→REVERB→DELAY→CHORUS
//    · KEY_AUX[1] (U37/C19) = 三模式切换（主页面 / 测试 / 教学）
//    · KEY0 (AA13)          = 板载键，与 U37 等效（也能切三模式）
//
//  已删除：J14 六个独立键、两首内置曲谱、指导模式、波形显示
//  分量数：每音 64 路（赛题拓展 1「单音加法分量 ≥32 路」）
//==========================================================================
`default_nettype none

module add_top #(
    parameter integer STARTUP  = 2_500_000,    // 上电静音 50 ms
    // ★ 消隐窗从 8 ms 加长到 20 ms：便宜的轻触开关抖动可达 10~20 ms，
    //   8 ms 挡不住会多出几次 key_press → 重触发 → 听感是"哒哒"噪音
    parameter integer DEBOUNCE = 1_000_000,    // 功能键 20 ms
    parameter integer PLAY_PRESS = 25_000,   // 演奏键按下连续稳定 0.5 ms
    parameter integer PLAY_RELEASE = 1_000_000 // 松开恢复已验证的 20 ms，防长回弹重触发
)(
    input  wire       CLOCK_50,   // 50 MHz 晶振 V22（先进 PLL）
    input  wire       RESET_n,
    // ── 18 键力度键盘（J13，2026-10-30 接入）────────────────────
    //    两排一前一后配对成 9 组，组 0..7 = 8 音键，组 8 = 切音高
    //    ★ RTL 尚未接入，先声明端口让 cst 能通过综合
    input  wire [8:0] KEY_R1,     // 第 1 排（PCB 上排）D14 D15 A18 A19 D17 C17 C20 F15 F19
    input  wire [8:0] KEY_R2,     // 第 2 排（PCB 下排）F16 E17 F13 F14 E16 D16 E19 D19 D20
    input  wire [1:0] KEY_AUX,    // 上方两个独立键 C18 C19
    input  wire       KEY0,       // 板上 KEY.0 (AA13) → 测试模式开关
    output wire       AUD_BCK,
    output wire       AUD_LRCK,
    output wire       AUD_DIN,
    output wire       DOUT,       // WS2812

    // ── TF 卡（1-bit SD 模式，上电把 P64.BIN 灌进 DDR3）──────────
    output wire       SD_CLK,
    inout  wire       SD_CMD,
    inout  wire       SD_DAT0,
    input wire BT_RX,output wire BT_TX,

    // ── 调试串口（115200 8N1，报告加载结果）────────────────────
    //    ★ DDR 加载完成后这根线改由光敏前端输出六路 mV（见文件末尾）
    output wire       UART_TX,

    // ── 六路光敏前端（F407 那一套：TDM 发射 + AD7606 双串行）────────
    //    球号：EMIT = P16 R17 T18 R19 P19 U21
    //          CS=U17  SCLK=R16  RST=P15  CONVST=R14  BUSY=U18
    //          DOUTA=P14  DOUTB=Y19
    output wire [5:0] IR_EMIT,     // 六路红外发射（one-hot，高电平点亮）
    output wire       ADC_CSN,
    output wire       ADC_SCLK,
    output wire       ADC_RST,     // 高有效
    output wire       ADC_CONVST,
    input  wire       ADC_BUSY,
    input  wire       ADC_DOUTA,   // DB7 → V1..V4
    input  wire       ADC_DOUTB,   // DB8 → V5..V8

    // ── DDR3 1 GiB（板载焊死，走专用 IOLOGIC 引脚，与 J13 无任何关系）──
    output wire [14:0] ddr_addr,
    output wire [2:0]  ddr_bank,
    output wire        ddr_cs,
    output wire        ddr_ras,
    output wire        ddr_cas,
    output wire        ddr_we,
    output wire        ddr_ck,
    output wire        ddr_ck_n,
    output wire        ddr_cke,
    output wire        ddr_odt,
    output wire        ddr_reset_n,
    output wire [3:0]  ddr_dm,
    inout  wire [31:0] ddr_dq,
    inout  wire [3:0]  ddr_dqs,
    inout  wire [3:0]  ddr_dqs_n,

    // ── 32 段常数-Q 频谱（给 HDMI 渲染器用，不在本工程里画）──────────
    //    BANDS 是 clk_sys 域寄存器，两次 bands_tick 之间保持不变；
    //    BANDS_TICK 是 clk_sys 域单拍脉冲（20 ns 宽）。
    //    显示侧 cross-domain 时只需「tick 高电平期间抓一次」即可，
    //    因为数据窗口有几十毫秒那么宽，不存在采样竞态。
    output wire [32*8-1:0] SPEC_BANDS,
    output wire            SPEC_TICK,

    // ── UI 状态总线（给 HDMI 渲染器画状态栏/信息框）─────────────────
    //    [1:0]   ui_mode   0=主页面 1=测试 2=教学
    //    [3:2]   timbre    0=钢琴 1=古筝 2=唢呐 3=笛子
    //    [5:4]   fx        0=NONE 1=REVERB 2=DELAY 3=CHORUS
    //    [7:6]   agl       李萨如余辉档位 0..3
    //    [9:8]   flt       李萨如显示低通 0=关 1=中 2=强
    //    [17:10] transpose 有符号半音数（-24..+12）
    //    全部是「按键级」慢变量（去抖后 >10 ms 才变），渲染侧打两拍同步即可。
    output wire [18:0] UI_INFO,
    output reg [383:0] SONG_UI,
    output reg [1023:0] SONG_ROLL,
    output reg SONG_UI_TOGGLE,
    input wire SONG_UI_ACK,

    // ── 「COMPONENT 64」柱图（最近触发声部的 64 根分量柱）─────────────
    //    每根 = 8 位幅度（0..255）。128 个正弦分量两两合并取大值 →
    //    64 根，宽度正好适合 1024 px 的绘图区。
    output wire [64*8-1:0] COMP_AMP,

    // ── 李萨如（相位图）取样口 ──────────────────────────────────
    //    SCOPE_SMP 每样点更新一次，在两次 SCOPE_TOG 翻转之间保持稳定
    //    （1024 个 clk_sys 周期 = 20.5 us）；渲染侧用 clk_p 打两拍同步
    //    SCOPE_TOG、靠翻转沿抓一次数据，不存在多位撕裂。
    output wire SCOPE_CLK,
    output wire signed [15:0] SCOPE_SMP,
    output wire               SCOPE_TOG,

    // ── note-on 触发（给相位图做单次捕获用）──────────────────────
    //    任意声部被触发就翻转一次；渲染侧打两拍检测翻转沿。
    //    用翻转而不是脉冲：clk_sys 的单拍脉冲只有 20 ns，
    //    跨到 75 MHz 域有概率被整个漏掉。
    output reg                SCOPE_TRG
);

    localparam integer NVOICE    = 8;      // ★ 4 → 8：只改这个参数（PH_SHIFT = 8/8 = 1 仍成立）
    localparam integer MIX_SHIFT = 1;

    //======================================================================
    //  时钟：50 MHz → PLL → 全局时钟网（频率不变，只为降时钟偏斜）
    //======================================================================
    wire clk_sys, pll_lock;
    assign SCOPE_CLK=clk_sys;

    pll50 u_pll (
        .clk_in (CLOCK_50),
        .clk_out(clk_sys),
        .lock   (pll_lock)
    );

    //======================================================================
    //  复位 + 上电静音
    //======================================================================
    reg [21:0] por_cnt = 22'd0;
    always @(posedge clk_sys)
        if (por_cnt != STARTUP[21:0] - 22'd1) por_cnt <= por_cnt + 22'd1;

    // Register the power-on comparison before distributing reset to thousands
    // of registers. Assert on the physical reset immediately; release in clk_sys.
    reg por_ready=1'b0;
    always @(posedge clk_sys)if(por_cnt==STARTUP[21:0]-22'd1)por_ready<=1'b1;
    wire por_n=por_ready;
    reg [1:0] engine_reset_sync=0;
    always @(posedge clk_sys or negedge RESET_n)begin
        if(!RESET_n)engine_reset_sync<=0;
        else engine_reset_sync<={engine_reset_sync[0],por_n && pll_lock};
    end
    wire engine_rst_n=engine_reset_sync[1];

    // ══════════════════════════════════════════════════════════════
    //  光学前端控制量（在文件末尾 position_control 产生）
    //    opt_bend : Q2.14 音高比（16384 = 不弯）
    //    opt_vel  : 0..255 力度
    //    opt_en   : 手在传感器上方时才为 1；手离开 6 s 后自动回退到键盘力度
    // ══════════════════════════════════════════════════════════════
    wire signed [15:0] opt_bend_q14;
    wire        [7:0]  opt_vel;
    wire               opt_en;

    // ★★ 有手在才响：键盘只决定音名与触发，不贡献音量。
    //    没有手 → 力度 0（真的没声音），不再回退到键盘常量 128。
    //    ★ opt_hand 由 position_control 用【即时 rho_raw】算出（1 帧响应），
    //      不能用 opt_vel —— 它源自 rho_dc 慢基线，会在急停后造成“回光返照”。
    wire hand_on = opt_hand;

    //======================================================================
    //  板上 KEY.0（AA13）→ 三模式页面循环
    //
    //  赛题「现场验证要求」要一个测试模式：输出 8 路不同频率的纯正弦，
    //  频谱上能数出对应数量的独立谱峰。
    //
    //    每按一次：主页面(0) → 测试(1) → 教学(2) → 主页面(0)
    //    上电默认主页面。音源切换和页面切换是同一个 mode，同步发生。
    //
    //  去抖 20 ms。它不参与演奏计时，不需要 key_dual 那套双触点精度。
    //  板上三个用户键都是「悬空=1、按下=0」，必须开内部上拉。
    //======================================================================
    reg  [1:0] k0_sync;
    always @(posedge clk_sys) k0_sync <= {k0_sync[0], KEY0};

    reg [19:0] k0_cnt;
    reg        k0_stable, k0_stable_d;
    always @(posedge clk_sys) begin
        if (!por_n) begin
            k0_cnt      <= 20'd0;
            k0_stable   <= 1'b1;
            k0_stable_d <= 1'b1;
        end
        else begin
            k0_stable_d <= k0_stable;
            if (k0_sync[1] != k0_stable) begin
                if (k0_cnt == 20'd999_999) begin
                    k0_cnt    <= 20'd0;
                    k0_stable <= k0_sync[1];
                end
                else k0_cnt <= k0_cnt + 20'd1;
            end
            else k0_cnt <= 20'd0;
        end
    end
    wire k0_press = k0_stable_d & ~k0_stable;      // 按下沿（低有效）

    localparam [1:0] MODE_MAIN  = 2'd0,
                     MODE_TEST  = 2'd1,
                     MODE_GUIDE = 2'd2;

    // ui_mode 的具体更新放到下面 KEY_AUX 扫描之后（要用 aux_release[1]）
    reg [1:0] ui_mode;
    wire guide_mode = ui_mode == MODE_GUIDE;
    wire remote_active;
    // Register the slow mode selection before its wide engine/allocator muxes.
    // One 50 MHz cycle is well before either song startup or an audio tick.
    reg score_mode;
    always @(posedge clk_sys)begin
        if(!por_n)score_mode<=1'b0;
        else score_mode<=guide_mode || remote_active;
    end
    wire bt_command_toggle,bt_command_play,bt_command_reply;
    wire [7:0] bt_command_error,bt_saved_id,bt_save_error,bt_last_error;
    wire bt_save_start,bt_save_done,bt_saving,bt_uploading,bt_committed;
    wire [15:0] bt_file_size,bt_accepted;
    wire bt_stream_start,bt_stream_valid,bt_stream_ready;
    wire [7:0] bt_stream_data;
    wire store_request,store_grant,reader_sdclk,writer_sdclk;
    wire [31:0] bt_position;
    reg [1:0] bt_reset_sync;
    always @(posedge CLOCK_50 or negedge RESET_n)begin
        if(!RESET_n)bt_reset_sync<=0;
        else bt_reset_sync<={bt_reset_sync[0],engine_rst_n};
    end
    wire bt_rst_n=bt_reset_sync[1];
    reg [1:0] bt_ready_sync,bt_playing_sync,bt_reply_sync,bt_dropped_sync;
    reg [1:0] bt_timbre_sync;
    // Coherent position/error snapshots are held until their toggle is seen.
    reg bt_position_req,bt_position_ack;
    reg [1:0] bt_pos_req_sync,bt_pos_ack_sync;
    reg [31:0] bt_position_hold,bt_position_q;
    assign bt_position=bt_position_q;
    always @(posedge clk_sys)begin
        if(!engine_rst_n)begin bt_pos_req_sync<=0;bt_position_ack<=0;bt_position_hold<=0;end
        else begin
            bt_pos_req_sync<={bt_pos_req_sync[0],bt_position_req};
            if(bt_pos_req_sync[1]!=bt_position_ack)begin bt_position_hold<=song_position;bt_position_ack<=bt_pos_req_sync[1];end
        end
    end
    always @(posedge CLOCK_50)begin
        if(!bt_rst_n)begin bt_ready_sync<=0;bt_playing_sync<=0;bt_reply_sync<=0;bt_timbre_sync<=0;bt_dropped_sync<=0;
            bt_position_req<=0;bt_pos_ack_sync<=0;bt_position_q<=0;end
        else begin
            bt_ready_sync<={bt_ready_sync[0],ld_ok};
            bt_playing_sync<={bt_playing_sync[0],song_playing};bt_dropped_sync<={bt_dropped_sync[0],song_dropped};
            bt_reply_sync<={bt_reply_sync[0],bt_command_reply};
            bt_timbre_sync<=timbre_r;
            bt_pos_ack_sync<={bt_pos_ack_sync[0],bt_position_ack};
            if(bt_pos_ack_sync[1]==bt_position_req)begin bt_position_q<=bt_position_hold;bt_position_req<=~bt_position_req;end
        end
    end
    bt_song_upload u_bt(.clk(CLOCK_50),.rst_n(bt_rst_n),.rx(BT_RX),.tx(BT_TX),
        .source_ready(bt_ready_sync[1]),.current_timbre(bt_timbre_sync),
        .playing(bt_playing_sync[1]),.dropped(bt_dropped_sync[1]),.position(bt_position),
        .command_toggle(bt_command_toggle),.command_play(bt_command_play),
        .command_reply(bt_reply_sync[1]),.command_error(bt_command_error),
        .save_start(bt_save_start),.save_done(bt_save_done),.save_error(bt_save_error),.file_size(bt_file_size),
        .stream_start(bt_stream_start),.stream_ready(bt_stream_ready),.stream_valid(bt_stream_valid),.stream_data(bt_stream_data),
        .song_timbre(),.song_valid(bt_committed),.uploading(bt_uploading),.accepted_count(bt_accepted),.last_error(bt_last_error));
    song_sd_save u_save(.clk(CLOCK_50),.rst_n(bt_rst_n),.start(bt_save_start),.file_size(bt_file_size),
        .request(store_request),.grant(store_grant),.catalog_ready(sd_song_catalog),.catalog_error(sd_song_error),
        .sdclk(writer_sdclk),.sdcmd(SD_CMD),.sddat0(SD_DAT0),
        .stream_start(bt_stream_start),.stream_valid(bt_stream_valid),.stream_data(bt_stream_data),.stream_ready(bt_stream_ready),
        .busy(bt_saving),.done(bt_save_done),.error(bt_save_error),.saved_id(bt_saved_id));
    assign SD_CLK=store_grant?writer_sdclk:reader_sdclk;
    wire [4:0] sd_song_count, song_count_ui;
    wire [127:0] sd_song_ids, song_ids_ui;
    wire sd_song_catalog, sd_song_busy, sd_song_begin, sd_song_end, sd_song_error;
    wire [7:0] sd_song_byte;
    wire sd_song_valid, song_request;
    wire [3:0] song_selected;
    wire [55:0] song_note;
    wire [15:0] song_voice_timbre;
    wire [7:0] song_lead;
    wire song_multi;
    wire [31:0] song_duration;
    wire [10:0] song_progress;
    wire [1023:0] song_roll;
    wire [7:0] song_trig, song_gate;
    wire [63:0] song_vel;
    wire song_playing, song_teaching, song_valid, song_catalog_ready,song_dropped;
    wire [1:0] song_timbre, song_countdown;
    wire [2:0] song_menu;
    wire [6:0] song_expected, song_matched;
    wire [31:0] song_position;
    wire [15:0] song_wrong, song_missed;
    wire [7:0] song_error;
    wire menu_next_state, menu_confirm_state;
    song_menu_keys u_song_keys (
        .clk(clk_sys),.rst_n(engine_rst_n),
        .next_n(KEY_R1[8]),.confirm_n(KEY_R2[8]),
        .next_state(menu_next_state),.confirm_state(menu_confirm_state)
    );
    song_system u_song (
        .clk(clk_sys),.clk_sd(CLOCK_50),.rst_n(engine_rst_n),.guide(guide_mode),
        .remote_toggle(bt_command_toggle),.remote_play(bt_command_play),.remote_id(bt_saved_id),.remote_allowed(!test_mode),
        .remote_reply(bt_command_reply),.remote_error(bt_command_error),.remote_active(remote_active),
        .next_state(menu_next_state),.confirm_state(menu_confirm_state),
        .key_press(note_key_press[6:0]),.key_state(note_key_state[6:0]),
        .sd_count(sd_song_count),.sd_ids(sd_song_ids),.sd_catalog_done(sd_song_catalog),
        .sd_begin(sd_song_begin),.sd_end(sd_song_end),.sd_error(sd_song_error),
        .sd_byte(sd_song_byte),.sd_byte_valid(sd_song_valid),
        .request_toggle(song_request),.selected(song_selected),
        .v_timbre(song_voice_timbre),.v_lead(song_lead),.multi_score(song_multi),
        .score_duration(song_duration),.roll_preview(song_roll),.progress(song_progress),
        .v_note(song_note),.v_trig(song_trig),.v_gate(song_gate),.v_vel(song_vel),
        .playing(song_playing),.dropped(song_dropped),.timbre(song_timbre),.score_valid(song_valid),
        .menu_state(song_menu),.teaching(song_teaching),.expected_keys(song_expected),
        .matched_keys(song_matched),.countdown(song_countdown),.position_ms(song_position),
        .wrong_count(song_wrong),.missed_count(song_missed),.error_code(song_error),
        .file_count(song_count_ui),.file_ids(song_ids_ui),.catalog_ready(song_catalog_ready)
    );
    // Mailbox handshake: hold the entire status snapshot until HDMI ACKs it.
    reg [1:0] bt_saving_ui,bt_uploading_ui,bt_committed_ui;
    reg [7:0] bt_saved_ui,bt_error_ui;
    always @(posedge clk_sys)begin
        if(!engine_rst_n)begin bt_saving_ui<=0;bt_uploading_ui<=0;bt_committed_ui<=0;bt_saved_ui<=0;bt_error_ui<=0;end
        else begin
            bt_saving_ui<={bt_saving_ui[0],bt_saving};bt_uploading_ui<={bt_uploading_ui[0],bt_uploading};
            bt_committed_ui<={bt_committed_ui[0],bt_committed};bt_saved_ui<=bt_saved_id;
            bt_error_ui<=bt_save_error!=0?bt_save_error:bt_last_error;
        end
    end
    reg [1:0] song_ack_sync;
    always @(posedge clk_sys) begin
        if(!engine_rst_n) begin SONG_UI<=0; SONG_ROLL<=0; SONG_UI_TOGGLE<=0; song_ack_sync<=0; end
        else begin
            song_ack_sync <= {song_ack_sync[0],SONG_UI_ACK};
            if(song_ack_sync[1]==SONG_UI_TOGGLE) begin
                SONG_ROLL <= song_roll;
                SONG_UI <= {49'd0,bt_error_ui,bt_saved_ui,bt_committed_ui[1],bt_uploading_ui[1],bt_saving_ui[1],opt_vel,hand_on,note_key_state,song_progress,song_duration,23'd0,song_catalog_ready,song_timbre,song_missed,song_wrong,song_position,
                    song_error,song_matched,song_expected,song_countdown,
                    song_playing,song_teaching,song_menu,song_selected,song_count_ui,song_ids_ui};
                SONG_UI_TOGGLE<=~SONG_UI_TOGGLE;
            end
        end
    end


    //======================================================================
    //  ★ 演奏键盘改为【单触点】扫描（2026-11-01 需求变更）
    //
    //    1) 只认第 1 排（KEY_R1）触发音符。第 2 排（KEY_R2）不参与演奏，
    //       只保留 R2[8] 一个键做「移调 -12」。
    //    2) 力度改由外部输入控制（以后接 UART/ADC），现在暂时固定 128
    //       = 最大 254 的一半。接外部输入时只改 vel_ext 一处。
    //    3) 第 9 组拆成两个物理按键：
    //         KEY_R1[8] 短按 → 移调 +12（升）
    //         KEY_R2[8] 短按 → 移调 -12（降）
    //
    //    原来的 key_dual 用双触点 Δt 测力度，现在有 ROW2 就不用它了。
    //    演奏键独立消抖：0.5ms 按下、20ms 松开；两级同步后计时。
    //    功能键仍用长消抖，歌曲菜单保留自己的防连跳状态机。
    //======================================================================
    wire [8:0] r1_state, r1_press, r1_release;
    wire [8:0] r2_state, r2_press, r2_release;

    key_scan #(.N(8), .DEBOUNCE(PLAY_PRESS),
        .RELEASE_DEBOUNCE(PLAY_RELEASE), .IMMEDIATE(0)) u_keys_r1 (
        .clk(clk_sys), .rst_n(engine_rst_n), .key_in(KEY_R1[7:0]),
        .key_state(r1_state[7:0]), .key_press(r1_press[7:0]),
        .key_release(r1_release[7:0])
    );
    key_scan #(.N(1), .DEBOUNCE(DEBOUNCE), .IMMEDIATE(0)) u_key_r1_menu (
        .clk(clk_sys), .rst_n(engine_rst_n), .key_in(KEY_R1[8]),
        .key_state(r1_state[8]), .key_press(r1_press[8]),
        .key_release(r1_release[8])
    );

    key_scan #(
        .N        (9),
        .DEBOUNCE (DEBOUNCE),
        .IMMEDIATE(1)
    ) u_keys_r2 (
        .clk         (clk_sys),
        .rst_n       (engine_rst_n),
        .key_in      (KEY_R2),
        .key_state   (r2_state),
        .key_press   (r2_press),
        .key_release (r2_release)
    );

    wire [1:0] aux_state, aux_press, aux_release;

    key_scan #(
        .N        (2),
        .DEBOUNCE (DEBOUNCE),
        .IMMEDIATE(1)
    ) u_keys_aux (
        .clk         (clk_sys),
        .rst_n       (engine_rst_n),
        .key_in      (KEY_AUX),
        .key_state   (aux_state),
        .key_press   (aux_press),
        .key_release (aux_release)
    );

    // ── 力度：暂时固定 128，以后接外部输入只改这一行 ────────────────
    wire [7:0] vel_ext = 8'd128;

    // 音源：第 1 排前 8 个键（C4..C5 一个八度）
    // ★ 第 9 键是【纯功能键】——不在 7:0 里，本来就不会发声
    wire [7:0]  note_key_state = r1_state[7:0];
    wire [7:0]  note_key_press = r1_press[7:0];
    wire [63:0] note_key_vel   = {8{vel_ext}};

    //======================================================================
    //  三模式切换：U37（KEY_AUX[1] / C19）短按；板上 KEY0（AA13）也保留
    //
    //    每按一次：主页面(0) → 测试(1) → 教学(2) → 主页面(0)
    //    上电默认主页面。音源切换和页面切换是同一个 mode，同步发生。
    //
    //  测试模式是赛题「现场验证要求」：输出 8 路不同频率的纯正弦，
    //  频谱上能数出对应数量的独立谱峰。
    //======================================================================
    wire mode_switch = k0_press | aux_release[1];

    always @(posedge clk_sys) begin
        if (!por_n)           ui_mode <= MODE_MAIN;
        else if (remote_active && ui_mode==MODE_MAIN)ui_mode<=MODE_GUIDE;
        else if (mode_switch) ui_mode <= (ui_mode == MODE_GUIDE) ? MODE_MAIN
                                                                 : (ui_mode + 2'd1);
    end

    wire test_mode = (ui_mode == MODE_TEST);

    //======================================================================
    //  音色/效果器键：上方独立键 KEY_AUX[0]（U38 / C18）
    //
    //          短按（松开时、没按满 1 s）→ 切音色 钢琴→古筝→唢呐→笛子
    //          长按（按满 1 s 那一拍）    → 切效果器 NONE→REVERB→DELAY→CHORUS
    //
    //  ★★ 长按后不能再触发短按（2026-11-01 修的 bug）
    //    原来写成松手时就把 lp_fired 清 0：
    //        else begin lp_cnt <= 0; lp_fired <= 1'b0; end
    //    但 key_scan 的 key_release 脉冲比 key_state 下降沿【晚一拍】，
    //    等脉冲到来时 lp_fired 已经被清掉 → 长按松开又当成短按切了音色。
    //    现在改成：
    //        · 松手时只清 lp_cnt，lp_fired 一直保持到下一次按下
    //        · 按下沿（!aux_d）才把 lp_fired 清 0 重新开始判定
    //======================================================================
    localparam [25:0] LP_MAX = 26'd49_999_999;      // 1 s @50 MHz

    reg  [25:0] lp_cnt;
    reg         lp_fired;                           // 本次按键已判定为长按
    reg         aux0_d;

    always @(posedge clk_sys) aux0_d <= aux_state[0];

    always @(posedge clk_sys) begin
        if (!engine_rst_n) begin
            lp_cnt   <= 26'd0;
            lp_fired <= 1'b0;
        end
        else if (!aux_state[0]) begin               // 松开：只清计数
            lp_cnt   <= 26'd0;
        end
        else if (!aux0_d) begin                     // 按下沿：重新开始
            lp_cnt   <= 26'd0;
            lp_fired <= 1'b0;
        end
        else if (lp_cnt != LP_MAX) begin
            lp_cnt   <= lp_cnt + 26'd1;
        end
        else begin
            lp_fired <= 1'b1;                       // 按满 1 s
        end
    end

    wire timbre_toggle = aux_release[0] && !lp_fired;          // 短按松开
    wire fx_toggle     = (lp_cnt == LP_MAX) && !lp_fired;      // 按满 1 s 那一拍

    //======================================================================
    //  音色：0 = 钢琴（白灯）  1 = 古筝（青灯）
    //======================================================================
    //  0 = 钢琴（白灯）  1 = 古筝（青灯）  2 = 唄呐（橙灯）  3 = 笛子（紫灯）
    reg [1:0] manual_timbre_r;
    wire [1:0] timbre_r = score_mode && song_valid ? song_timbre : manual_timbre_r;

    always @(posedge clk_sys) begin
        if (!engine_rst_n)          manual_timbre_r <= 2'd0;
        else if (timbre_toggle && !score_mode) manual_timbre_r <= manual_timbre_r + 2'd1;
    end

    //======================================================================
    //  效果器档位（U38 长按循环）：
    //      0 = NONE     干声
    //      1 = REVERB   混响（Freeverb：8 梳状 + 4 全通）
    //      2 = DELAY    乒乓延迟
    //      3 = SUSTAIN  延音（作用于音源：松键后按自然衰减率继续响）
    //      4 = CHORUS   合唱
    //  ★ 各档互相独立，不做叠加。
    //======================================================================
    reg [2:0] fx_r;

    always @(posedge clk_sys) begin
        if (!engine_rst_n)                       fx_r <= 3'd0;
        else if (fx_toggle)                      fx_r <= (fx_r == 3'd4) ? 3'd0 : fx_r + 3'd1;
    end

    // 各档使能必须定义在 u_piano / u_fx_* 之前（default_nettype none）
    wire fx_rev_on = (fx_r == 3'd1);
    wire fx_dly_on = (fx_r == 3'd2);
    wire fx_chr_on = (fx_r == 3'd4);
    // ★ fx_sus_on 依赖 is_harm，定义放在 timbre 判定之后（见下方）

    //======================================================================
    //  李萨如余辉档位：0..3（KEY_R2[0] 短按循环）
    //    不同乐器需要的余辉完全不同：唢呐/笛子波形严格周期，余辉可以长；
    //    钢琴/古筝非谐性使相图缓慢形变，余辉一长就叠成一团。
    //    L1 余辉 250ms   L2 余辉 83ms   L3 余辉 36ms   L4 余辉 17ms（每帧清空）
    //    （亮度模型是"最近性"：每次扫过直接写满 15，再逐帧衰减，
    //      所以拖尾整体亮度均匀，只有新旧之分）
    //  ★ KEY_R2[0] 空着不用（演奏只认 R1），正好当功能键。
    //======================================================================
    reg [1:0] agl_sel;

    always @(posedge clk_sys) begin
        if (!engine_rst_n)              agl_sel <= 2'd3;
        else if (timbre_r != display_timbre) agl_sel <= timbre_r[1] ? 2'd0 : 2'd3;
        else if (r2_press[0])           agl_sel <= (agl_sel == 2'd3) ? 2'd0
                                                         : agl_sel + 2'd1;
    end

    //======================================================================
    //  李萨如显示低通：0=关 1=中(≈1.9 kHz) 2=强(≈970 Hz)（KEY_R2[1] 循环）
    //    笛子有气流噪声、钢琴/古筝有高次谐波噪声，都会把线条推粗。
    //    低通后线条立刻变细、图形变简洁。对音频输出无影响（只滤显示）。
    //======================================================================
    reg [1:0] flt_sel;

    always @(posedge clk_sys) begin
        if (!engine_rst_n)              flt_sel <= 2'd1;
        else if (timbre_r != display_timbre) flt_sel <= timbre_r[1] ? 2'd0 : 2'd1;
        else if (r2_press[1])           flt_sel <= (flt_sel == 2'd2) ? 2'd0
                                                         : flt_sel + 2'd1;
    end

    reg [1:0] display_timbre;
    always @(posedge clk_sys) begin
        if(!engine_rst_n) display_timbre<=0;
        else display_timbre<=timbre_r;
    end

    // ★ 古筝判定必须写【== 1】，不能再用 timbre_r[0]
    //   ！3（笛子）的 bit0 也是 1，用 timbre_r[0] 会把笛子当成古筝
    //   （按键映射、移调范围、modal 引擎选择全错）。
    wire is_gz = (timbre_r == 2'd1);
    // ★ 唄呐 / 笛子共用谐波引擎，只是表和音域不同
    wire is_suona = (timbre_r == 2'd2);
    wire is_dizi  = (timbre_r == 2'd3);
    // ★ 谐波类乐器（唄呐或笛子）：共用同一个 add_engine_harm 实例
    wire is_harm  = is_suona | is_dizi;

    // ★ 延音（SUSTAIN）使能
    //   SUSTAIN 档：直接开。
    //   REVERB 档：钢琴/古筝也开 —— 混响需要【持续的声源能量】。
    //     钢琴/古筝是打击性音色，松键 0.3 s 就断，混响只能收到一小段碎片，
    //     听感上几乎“没有混响”；而笛子/唄呐是持续音，本来就够。
    //     真实演奏中钢琴加混响也是一定踩延音踏板的。
    //   笛子/唄呐在 REVERB 档不额外加延音（它们本来就是持续音）。
    wire fx_sus_on = (fx_r == 3'd3) || ((fx_r == 3'd1) && !is_harm);

    //======================================================================
    //  ★ 移调（第 9 组拆成两个物理按键）
    //     KEY_R1[8] 短按 → 整体 +1 八度（+12）
    //     KEY_R2[8] 短按 → 整体 -1 八度（-12）
    //     到音域边界停住、不循环；切换音色清零回 0。
    //     ★ 不再用力度大小判方向 —— 两个独立按键，方向天然确定。
    //======================================================================
    localparam signed [7:0] TR_STEP = 8'sd12;

    // 8 个键音高范围由各乐器自己的映射决定：
    //   钢琴：60..72 (C4..C5)，表 21..108 → -36 .. +36（7 档）
    //   古筝：62..74 (D4..D5)，表 38..86  → -24 .. +12（4 档）
    //   唢呐：8 键 69..81，表 69..96 → 0 .. +12（只有 2 档）
    //   笛子：8 键 67..79，表 67..91 → 0 .. +12（同上）
    wire signed [7:0] tr_min = is_harm  ?  8'sd0  :
                               is_gz    ? -8'sd24 : -8'sd36;
    wire signed [7:0] tr_max = is_harm  ?  8'sd12 :
                               is_gz    ?  8'sd12 :  8'sd36;

    reg signed [7:0] transpose;

    wire tr_up_fire   = engine_rst_n && !score_mode && r1_press[8];
    wire tr_down_fire = engine_rst_n && !score_mode && r2_press[8];

    always @(posedge clk_sys) begin
        if (!engine_rst_n) begin
            transpose <= 8'sd0;
        end
        else if (timbre_toggle) begin
            // 切换音色 → 清零（音域不同，旧档位可能已越界）
            transpose <= 8'sd0;
        end
        else if (tr_up_fire) begin
            // 到上限就停住，不回绕
            transpose <= (transpose + TR_STEP > tr_max)
                       ? tr_max : transpose + TR_STEP;
        end
        else if (tr_down_fire) begin
            // 到下限就停住，不回绕
            transpose <= (transpose - TR_STEP < tr_min)
                       ? tr_min : transpose - TR_STEP;
        end
    end

    //======================================================================
    //  移调指示灯：动作后亮 300 ms（红 = 降 -12，蓝 = 升 +12）
    //    tr_up_fire / tr_down_fire 都是 key_scan 的单拍 press 脉冲。
    //======================================================================
    wire tr_fire = tr_up_fire | tr_down_fire;
    wire tr_down = tr_down_fire;

    localparam [23:0] TR_LED_T = 24'd14_999_999;   // 300 ms @50 MHz

    reg        tr_led_on;
    reg        tr_led_neg;
    reg [23:0] tr_led_tmr;

    always @(posedge clk_sys) begin
        if (!engine_rst_n) begin
            tr_led_on  <= 1'b0;
            tr_led_neg <= 1'b0;
            tr_led_tmr <= 24'd0;
        end
        else if (tr_fire) begin
            tr_led_on  <= 1'b1;
            tr_led_neg <= tr_down;
            tr_led_tmr <= TR_LED_T;
        end
        else if (tr_led_on) begin
            if (tr_led_tmr != 24'd0) tr_led_tmr <= tr_led_tmr - 24'd1;
            else                     tr_led_on  <= 1'b0;
        end
    end

    //======================================================================
    //  复音分配：8 键 → 8 声部（C4..C5 一个八度）
    //======================================================================
    wire [NVOICE*7-1:0] k_note;
    wire [NVOICE-1:0]   v_trig, v_gate, v_idle;
    wire [NVOICE*8-1:0] v_vel;

    // ★★ 钢琴/古筝的力度也用光学前端：手的高度 = 力度
    //   add_voice8 里 vel_gain 是【实时目标值】（ramp 每次 +2/−1 向它收敛），
    //   不是按下的瞬间锁存，所以这里连续覆盖就能当「音量踏瓣」用：
    //   按住琴键不动、手抬起来 → 声音渐弱；压下去 → 渐强。
    wire [NVOICE*8-1:0] song_vel_expr;
    genvar sg;
    generate for(sg=0;sg<NVOICE;sg=sg+1) begin:g_song_vel
        wire [15:0] vscale = song_vel[sg*8+:8] * opt_vel;
        assign song_vel_expr[sg*8+:8] = song_teaching && song_lead[sg] && hand_on ? vscale[15:8] : song_vel[sg*8+:8];
    end endgenerate
    wire [NVOICE*8-1:0] vel_eng = score_mode ? song_vel_expr :
        hand_on ? {NVOICE{opt_vel}} : {NVOICE{8'd0}};

    //======================================================================
    //  ★ 每个乐器独立的按键映射（键名位置固定，但音高与可用键不同）
    //
    //     键号：  1    2    3    4     5    6    7    8
    //     键名： do   re   mi   fa    sol  la   si   do'
    //
    //     钢琴（C 大调七声）：
    //       step   0    2    4    5     7    9    11   12   → C4 D4 E4 F4 G4 A4 B4 C5
    //       enable 8 键全开
    //
    //     古筝（D 宫五声，宫商角徵羽）：
    //       step   0    2    4    F     7    9    F    12   → D4 E4 F#4 -- A4 B4 -- D5
    //       enable 键 4(fa)、键 7(si) 屏蔽 —— 五声音阶里没有这两个音
    //       所以古筝实际发声键 = 1,2,3,5,6,8（6 个）
    //======================================================================
    //   唢呐：A4(69) 起，七声，8 键全开，移调 0 / +12
    //         （音域只有 28 半音，五声会一档移调都做不了）
    //   笛子：G4(67) 起，G 大调七声（G A B C D E F# G），8 键全开，移调 0 / +12
    //         音阶步长与钢琴/唄呐完全相同 {0,2,4,5,7,9,11,12}，
    //         只是 note_base 换成 67，所以下面 t_key_step 不用改
    wire [6:0]  t_note_base = is_suona ? 7'd69 :
                              is_dizi  ? 7'd67 :
                              is_gz    ? 7'd62 : 7'd60;   // 唄呐 A4 / 笛子 G4 / 古筝 D4 / 钢琴 C4

    // ★ 4'hF = 无效步长哨兵（该键在本乐器音阶里不存在）
    wire [31:0] t_key_step  = is_gz
        ? {4'd12, 4'hF, 4'd9, 4'd7, 4'hF, 4'd4, 4'd2, 4'd0}   // 古筝 D 宫五声
        : {4'd12, 4'd11, 4'd9, 4'd7, 4'd5, 4'd4, 4'd2, 4'd0}; // 钢琴/唢呐 七声

    // 键 4、键 7 在古筝下不发声（bit3 = 键4，bit6 = 键7）
    wire [7:0]  t_key_en  = is_gz ? 8'b1011_0111 : 8'b1111_1111;  // 唄呐/笛子 8 键全开

    note_alloc #(
        .NKEY     (8),
        .NVOICE   (NVOICE)
    ) u_alloc (
        .clk      (clk_sys),
        .rst_n    (engine_rst_n),

        .key_state(score_mode ? 8'd0 : note_key_state),
        .key_enable(t_key_en),
        .note_base (t_note_base),
        .key_step  (t_key_step),
        .key_vel  (note_key_vel),
        .transpose(transpose),
        .v_idle   (v_idle),
        .v_note   (k_note),
        .v_trig   (v_trig),
        .v_gate   (v_gate),
        .v_vel    (v_vel)
    );

    //======================================================================
    //  ★★ 上电自检：每 2 s 自动弹一次 C4（响 0.5 s），完全不依赖键盘
    //     目的：一次定位故障到底在「引擎/音频链路」还是「键盘接线」
    //       · 听得见周期性 C4  → 引擎和 I2S 正常，问题在键盘
    //       · 完全听不见        → 引擎或音频链路出问题
    //     调试完把它改回 0
    //======================================================================
    localparam integer AUTO_TEST = 0;

    localparam [26:0] AT_PERIOD = 27'd99_999_999;   // 2 s @50MHz
    localparam [26:0] AT_TRIG   = 27'd24_999_999;   // 0.5 s 处触发
    localparam [26:0] AT_OFF    = 27'd74_999_999;   // 1.5 s 处松键（响 1 s）

    reg [26:0] aut_t;
    always @(posedge clk_sys) begin
        if (!engine_rst_n)                 aut_t <= 27'd0;
        else if (aut_t == AT_PERIOD)       aut_t <= 27'd0;
        else                               aut_t <= aut_t + 27'd1;
    end

    wire aut_trig = AUTO_TEST && (aut_t == AT_TRIG);
    wire aut_gate = AUTO_TEST && (aut_t >= AT_TRIG) && (aut_t < AT_OFF);
    wire aut_any  = aut_trig || aut_gate;

    wire mixed_score=score_mode && song_valid && song_multi;
    wire [NVOICE-1:0] modal_mask=mixed_score?8'h7f:(is_harm?8'h00:8'hff);
    wire [NVOICE*7-1:0] eng_note = score_mode ? song_note : aut_any ? {NVOICE{7'd60}} : k_note;
    wire [NVOICE-1:0]   eng_trig = score_mode ? song_trig : aut_trig ? {{(NVOICE-1){1'b0}}, 1'b1} : v_trig;
    wire [NVOICE-1:0]   eng_gate = score_mode ? song_gate : aut_gate ? {{(NVOICE-1){1'b0}}, 1'b1} : v_gate;

    //======================================================================
    //  加法合成引擎：128 分量/声部，8 声部共用一份参数 ROM
    //    ★ 与旧版（64 分量 × 16 级流水线）的区别见 src/add_voice8.v 文件头
    //      实测：关键路径 15.1 ns → 9.3 ns，共用 ROM 让 pROM 92 块 → 29 块
    //======================================================================
    //  音色选择（改这一个常量即可切换，参数表需同步放进工程根目录）
    //    0 = 钢琴：88 音 × 128 分量 = 11264 深 → add_param0/1/2.hex
    //    1 = 古筝：49 音 × 128 分量 =  6272 深 → gz_param0/1/2.hex
    localparam integer TIMBRE_SEL  = 0;
    localparam integer T_ROM_AW    = (TIMBRE_SEL == 1) ? 13 : 14;
    localparam integer T_ROM_DEPTH = (TIMBRE_SEL == 1) ? 6272 : 11264;
    localparam integer T_NOTE_LO   = (TIMBRE_SEL == 1) ? 38 : 21;
    localparam integer T_NOTE_HI   = (TIMBRE_SEL == 1) ? 86 : 108;

    wire               tick;
    wire signed [15:0] eng_l, eng_r;

    // 分量幅度监控（来自「最近一次 note-on 的那个声部」）
    wire [6:0] comp_idx;
    wire [7:0] comp_amp;
    wire       comp_vld;

    // 谐波引擎的同名监控（唢呐/笛子）
    wire [6:0] harm_idx;
    wire [7:0] harm_amp;
    wire       harm_vld;

    // ── DDR 取表口回馈信号（按仲裁授权过滤，见文件末尾 u_ddr_arb）────────
    //   ★ 必须声明在例化之前（本文件 default_nettype none）
    wire       eng_app_rdy;
    wire       eng_rd_valid;
    wire       sua_app_rdy;
    wire       sua_rd_valid;

    add_engine8 #(
        .NVOICE   (NVOICE),
        .MULTI_TIMBRE(1),
        .NPART    (128),
        .ROM_AW   (T_ROM_AW),
        .ROM_DEPTH(T_ROM_DEPTH),
        .NOTE_LO  (T_NOTE_LO),
        .NOTE_HI  (T_NOTE_HI),
        .ATK      (0),
        .MIX_SHIFT(MIX_SHIFT),
        // ── 参数源改为 DDR3（第 3 步）──────────────────────────────
        //   取值必须与 tools/make_ddr_image.py 生成的文件头一致：
        //     piano_base = 1，gz_base = 5633，每音 64 个 256 位字
        .USE_DDR    (1),
        .PIANO_BASE (1),
        .GZ_BASE    (5633),
        .WORDS_NOTE (64),
        .ADDR_SHIFT (3)
    ) u_piano (
        .clk        (clk_sys),
        .rst_n      (engine_rst_n),
        .normalize_guzheng(mixed_score),
        .voice_timbre(mixed_score ? {1'b0,song_voice_timbre[12],song_voice_timbre[10],song_voice_timbre[8],
            song_voice_timbre[6],song_voice_timbre[4],song_voice_timbre[2],song_voice_timbre[0]} : {NVOICE{is_gz}}),
        .voice_expression(score_mode ? (song_teaching && hand_on ? song_lead:8'd0):8'hff),
        .timbre     (is_gz),             // ★ modal 引擎：1=古筝 0=钢琴（唄呐/笛子时无效）
        .v_note     (eng_note),
        .v_trig     (eng_trig & modal_mask),
        .v_gate     (eng_gate & modal_mask),
        .v_vel      (vel_eng),           // ★ 光学力度优先，否则用键盘力度
        // ★★ 滑音只给古筝（技法表：钢琴没有滑音）。
        //    二者共用同一个 add_engine8 实例，所以在顶层按音色选。
        .bend_q14   ((!score_mode || (song_teaching && hand_on)) ? opt_bend_q14 : 16'd16384),
        .vib_en     (opt_vib_en && (!score_mode || (song_teaching && hand_on))),   // G3 揉弦（古筝）
        .art_en     (opt_art && (!score_mode || (song_teaching && hand_on))),     // G7 顿音
        .stop_hold  (opt_stop && (!score_mode || (song_teaching && hand_on))),     // G8 急停
        // ★ 延音：由效果器档位控制（SUSTAIN 单独一档，也可与 DELAY 叠加）——
        //   松键后按每个音自己的自然衰减率继续响，而不是 0.30 s 一刀煞掉。
        .sustain    (fx_sus_on),
        .sample_tick(tick),
        .sample_l   (eng_l),
        .sample_r   (eng_r),
        .v_idle     (v_idle),
        .comp_idx   (comp_idx),
        .comp_amp   (comp_amp),
        .comp_vld   (comp_vld),

        // DDR 取表口（clk_x1 域）
        // ★ app_rdy / rd_valid 必须按仲裁授权过滤，否则没拿到授权的客户
        //   会误以为它的命令被接受了（见下方 u_ddr_arb 处说明）
        .clk100              (ddr_clk_x1),
        .rst100_n            (ddr_init_done),
        .app_cmd             (eng_app_cmd),
        .app_en              (eng_app_en),
        .app_addr            (eng_app_addr),
        .app_rdy             (eng_app_rdy),
        .app_rd_data_valid   (eng_rd_valid),
        .app_rd_data         (ddr_rd_data)
    );

    //======================================================================
    //  谐波引擎（唢呐 / 笛子共用，单声部）
    //    · 单声部：任意声部触发都映射到它的 0 号声部，音高用同拍组合 mux
    //    · 表在 DDR，note-on 时 suona_dma 搬十几 KB 到 BSRAM（约 200 us）
    //    · ★ 两个乐器【共用一个实例】：只改 4 个输入
    //        note_lo / note_hi  ：音域（唢呐 69..96 / 笛子 67..91）
    //        inf_base           ：info 表字偏移（0 / 112）
    //        desc_base          ：描述符 app 地址基址（已扣掉 note_lo*16）
    //      省下约 50 块 BSRAM，也省一条 DDR 仲裁。
    //======================================================================
    //  镜像里的段基址（由 tools/make_ddr_image.py 打印）
    localparam integer SUONA_BASE_W = 8769;
    localparam integer DIZI_BASE_W  = 22176;
    localparam integer DESC_OFF_W   = 2;

    // desc_base = ((BASE+DESC_OFF) << 3) - note_lo*16
    //   <<3       ：word = 32 字节 = 8 个 4 字节单位（app_addr 的单位）
    //   note_lo*16：把绝对音号归一到段内序号（每音描述符 64 B = 16 个 app 单位）
    localparam [28:0] SUONA_DESC = ((SUONA_BASE_W + DESC_OFF_W) << 3) - (69 * 16);
    localparam [28:0] DIZI_DESC  = ((DIZI_BASE_W  + DESC_OFF_W) << 3) - (67 * 16);

    localparam [7:0]  SUONA_INF  = 8'd0;     // info 0..111
    localparam [7:0]  DIZI_INF   = 8'd112;   // info 112..211

    wire harm_dizi=mixed_score ? song_voice_timbre[15:14]==3:is_dizi;
    wire harm_expression=!score_mode || (song_teaching && hand_on && (!mixed_score || song_lead[7]));
    wire [6:0]  harm_note_lo  = harm_dizi ? 7'd67 : 7'd69;
    wire [6:0]  harm_note_hi  = harm_dizi ? 7'd91 : 7'd96;
    wire [7:0]  harm_inf_base = harm_dizi ? DIZI_INF : SUONA_INF;
    wire [28:0] harm_desc     = harm_dizi ? DIZI_DESC : SUONA_DESC;

    wire signed [15:0] sua_l, sua_r;
    wire [3:0]         sua_v_idle;
    wire [2:0]         sua_app_cmd;
    wire               sua_app_en;
    wire [28:0]        sua_app_addr;

    // ★★ 关键：只有谐波类音色下才允许触发取表 DMA！
    //   之前写成 |v_trig，导致钢琴模式下按一次键，唄呐引擎也会去抢 DDR，
    //   钢琴的取表被挤掉 → 切回钢琴也没声音（实测整机哑掉）。
    wire sua_trig = mixed_score ? song_trig[7] : is_harm && |eng_trig;

    // ★★ gate / 力度【不能】走 note_alloc 的声部！
    //    note_alloc 是 8 声部轮转分配，同一个键每次可能落在不同声部；
    //    而唢呐是单声部，用 |v_gate / v_vel[某声部] 会出两个毛病：
    //      · 任一残留声部的 v_gate=1 → 松键也不停（实测第 8 键卡住）
    //      · 力度取错声部         → 轻重反了（实测第 8 键）
    //    钢琴/古筝不受影响：它们每个声部有自己的 v_gate[g]/v_vel[g]，
    //    声部与按键是一一对应的，所以那边一直正常。
    //    唢呐改成直接看【8 个音源键】，与声部分配彻底解耦。
    wire sua_gate = mixed_score ? song_gate[7] : is_harm && (score_mode ? song_gate[0] : (|note_key_state));

    // 按下沿 → 按【键号】锁存力度（不是声部号）
    //   直接复用 note_key_press（= r1_press[7:0]，独立消抖后的单拍）
    reg  [7:0] sua_vel;
    integer sv;
    always @(posedge clk_sys) begin
        for (sv = 0; sv < 8; sv = sv + 1)
            if (note_key_press[sv]) sua_vel <= note_key_vel[sv*8 +: 8];
    end

    // ★ 音高：组合 mux（必须和 v_trig 同拍有效，引擎在那一拍锁存 sd_note）
    reg  [6:0] sua_note;
    integer si;
    always @(*) begin
        sua_note = harm_note_lo;
        for (si = 0; si < NVOICE; si = si + 1)
            if (eng_trig[si]) sua_note = eng_note[si*7 +: 7];
        if(mixed_score) sua_note=song_note[49+:7];
    end


    // ★ 引擎内部多处写死 4 声部（rot[2]、k_nz[2] 等），所以保持 NVOICE=4，
    //   只用 0 号声部：v_trig 只有 bit0 会动，其余声部永不激活。
    //   表缓冲是【共享的一份】，所以多留 3 个空声部不额外占 BSRAM。
    add_engine_harm #(
        .SCORE_VELOCITY(1),
        .NVOICE    (4),
        .MIX_SHIFT (2),      // 谐波引擎满刻度远高于钢琴，先 ÷4
        .SOFT      (1)
    ) u_harm (
        .clk        (clk_sys),
        .rst_n      (engine_rst_n),
        // ★ 双乐器：音域 / info 段 / 描述符段全部运行时可切
        .note_lo    (harm_note_lo),
        .note_hi    (harm_note_hi),
        .inf_base   (harm_inf_base),
        .desc_base  (harm_desc),
        .score_mode (score_mode),
        .v_note     ({21'd0, sua_note}),
        .v_trig     ({3'b000, sua_trig}),
        .v_gate     ({3'b000, sua_gate}),
        .v_vel      ({{24{1'b0}}, (score_mode ? (mixed_score?song_vel_expr[63:56]:song_vel_expr[7:0]) : sua_vel)}),
        // ★ 延音：与钢琴/古筝共用同一个效果器档位（SUSTAIN / DELAY+SUSTAIN）
        .sustain    (fx_sus_on),
        // ★ 光学前端（步骤 1：先接常量，保证与改动前逐位等价）
        .bend_q14   (harm_expression ? opt_bend_q14 : 16'd16384),
        .trem_en    (opt_trem_en && !harm_dizi && harm_expression),
        .vib_pitch  (opt_vib_en && !harm_dizi && harm_expression),   // G3 颤音（音高） 唢呐
        .vib_am     (1'b0),                  // 笛子只用音色自带气颤
        .art_en     (opt_art && harm_expression),      // G7 顿音/吐音
        .stop_hold  (opt_stop && harm_expression),      // G8 急停
        .hand_on    (score_mode ? 1'b1 : opt_hand),                 // 有手才响
        .opt_en     (score_mode ? 1'b0 : opt_en),
        .opt_vel    (opt_vel),
        .sample_tick(tick),
        .sample_l   (sua_l),
        .sample_r   (sua_r),
        .v_idle     (sua_v_idle),
        .part_idx   (harm_idx),
        .part_amp   (harm_amp),
        .part_vld   (harm_vld),

        .clk100              (ddr_clk_x1),
        .rst100_n            (ddr_init_done),
        .app_cmd             (sua_app_cmd),
        .app_en              (sua_app_en),
        .app_addr            (sua_app_addr),
        .app_rdy             (sua_app_rdy),
        .app_rd_data_valid   (sua_rd_valid),
        .app_rd_data         (ddr_rd_data)
    );

    // ★ 必须打一拍再送进 sat_gain：
    //   直接组合 mux 会把 u_piano/u_mix → u_tx/din 的路径拉长，
    //   实测 SETUP -0.853 ns（CLK_SYS 唯一违例）。
    //   音频流每样点一次，加一拍延迟完全无影响。
    reg signed [15:0] mix_l_r, mix_r_r;
    reg signed [31:0] mixed_l,mixed_r;
    always @(posedge clk_sys) begin
        mixed_l <= ($signed(eng_l)*32'sd8)+($signed(sua_l)*32'sd2);
        mixed_r <= ($signed(eng_r)*32'sd8)+($signed(sua_r)*32'sd2);
        mix_l_r <= is_harm ? sua_l : eng_l;
        mix_r_r <= is_harm ? sua_r : eng_r;
    end

    //======================================================================
    //  测试模式音源：8 路纯正弦，【按哪个键响哪个单频】
    //
    //  ★ 为什么要按键驱动、不能 8 路常开：
    //    只用一路真实音频引擎是合成不出「独立谱峰」的：钢琴一个音就有
    //    128 个分量，8 个声部叠起来是 1024 根谱线的谐波森林，频谱仪上
    //    根本数不清。所以测试模式要让每个键只发一个频率。
    //
    //  ★ 为什么会带力度：
    //    力度直接做每路增益 → 按重点柱就高，松手立刻灭。
    //    ★ 现在力度固定 128（单触点），所以 8 路柱高一致；
    //      以后接外部力度输入后就会恢复动态。
    //    评委自己上手按几下就能确认：这是实时硬件合成，不是放录音。
    //======================================================================
    wire signed [15:0] test_snd;
    test_sine8 u_test_sine (
        .clk     (clk_sys),
        .rst_n   (por_n),
        .tick    (tick),
        .key_on  (note_key_state),   // 8 个音键：1 = 按住
        .key_vel (note_key_vel),     // 8 个音键 × 8 位力度（目前固定 128）
        .sample  (test_snd)
    );

    //======================================================================
    //  输出增益 ×8
    //
    //  实测（修完 add_voice8 两个 bug 后，用浮点模型扫全音域 + iverilog 复算）：
    //      sample_l（引擎输出，已含 MIX_SHIFT=1 的 ÷2）单音峰值
    //        钢琴 最大 817（MIDI 38）/ 中位 615     古筝 最大 324 / 中位 198
    //      4 声部实测峰值（38/60/72/84） = 1766，0 个削顶样点
    //
    //  sat_gain 取 2 的幂，按【最坏同相】4 声部定：
    //      单声部 raw 峰值 V = 817×2 = 1634
    //      最坏同相：Σ=4V=6536 → mix_sum 的 >>1 → 3268 → ×8 = 26144 = −2.0 dBFS ✓
    //      实测典型 4 声部：1766×8 = 14128 = −7.3 dBFS
    //      单音：817×8 = 6536 = −14.0 dBFS
    //
    //  ★ 原来 ×4：最坏同相只有 13072 = −8.0 dBFS，白白浪费 8 dB 动态范围；
    //    ×16 会到 +4.1 dBFS 削顶，所以 ×8 是能取的最大 2 的幂。
    //  ★ 更早的 ×8 + 旧表会削顶，是因为旧表峰值更高且当时 sat_gain 前面
    //    没有 mix_sum 的 ÷2；现在两处定标重新算过，×8 是安全的。
    //======================================================================
    //======================================================================
    //  输出增益 + ★软限幅（治"多音破音"）
    //    钢琴 ×8 ：单音峰值约 5240 → 原样通过（响度不变）
    //    古筝 ×16：同理
    //    8 个音同时响：峰值约 40000 > 32767 → 硬钳位会削顶破音，
    //                  改成二次肩软压缩，平滑压到 ~32192，不削顶
    //
    //    膝点 24000，超过后 d = ax-KNEE（钳在 16384），
    //        y = 24000 + d − d²/32768
    //    d=16384 时 y = 24000+16384−8192 = 32192（最大值，永不超 32767）
    //======================================================================
    function signed [31:0] sat_pre;
        input signed [15:0] x;
        input [1:0]         tb;       // 0=钢琴 1=古筝 2=唢呐
        begin
            // ★ 唄呐/笛子只 ×2：实测唄呐引擎输出满力度峰值约 10000，
            //   原来 ×8 送成 80000，软限幅把它压成方波（压缩比 2.5:1），
            //   听感是「嘟嘟」而且削顶后 RMS 更高、听着更响。
            //   ×2 → 20000，在膝点 24000 以下，直通零失真。
            //   笛子 max a 只有 4.48（唄呐 6.83），先同样 ×2，上板听完再调。
            sat_pre = ((tb == 2'd2) || (tb == 2'd3)) ? (x <<< 1) :   // 唄呐/笛子 ×2
                      tb ? (x <<< 4) :       // 古筝 ×16
                           (x <<< 3);        // 钢琴 ×8
        end
    endfunction

    // The same knee curve is divided across five short clock stages.
    // This preserves all output values while removing a wide multiply and
    // sign/clip chain from the route to the effects processors.
    wire signed [15:0] sp_l,sp_r;
    audio_soft_limiter u_limit_l(.clk(clk_sys),.rst_n(por_n),.sample(gy_l),.limited(sp_l));
    audio_soft_limiter u_limit_r(.clk(clk_sys),.rst_n(por_n),.sample(gy_r),.limited(sp_r));

    //======================================================================
    //  效果器：CHORUS（clk_sys 域，延迟线用 2 个 BSRAM）
    //
    // Register limiter output before the effects; every stage settles before
    // the next audio tick. Bypass and enabled paths retain equal delay.
    reg signed [15:0] fxi_l, fxi_r;
    always @(posedge clk_sys) begin
        fxi_l <= sp_l;
        fxi_r <= sp_r;
    end

    wire signed [15:0] cho_l, cho_r;
    wire signed [15:0] dly_l, dly_r;
    wire signed [15:0] rev_l, rev_r;

    fx_chorus u_fx_chorus (
        .clk    (clk_sys),
        .rst_n  (por_n),
        .tick   (tick),
        .enable (fx_chr_on),           // 4 = CHORUS
        .in_l   (fxi_l),
        .in_r   (fxi_r),
        .out_l  (cho_l),
        .out_r  (cho_r)
    );

    // ── 效果器：DELAY（乒乓延迟，两条 16384 深 BSRAM，共 32 块）──────
    //    ★ 同样旁通时照常读写延迟线，切入无缝、延迟恒定。
    // ── 效果器：REVERB（Freeverb，24 块 BSRAM）─────────────────────
    //    单声道内核 + 左右双抽头（读位置差 23 样本）→ 内存减半。
    fx_reverb u_fx_reverb (
        .clk    (clk_sys),
        .rst_n  (por_n),
        .tick   (tick),
        .enable (fx_rev_on),           // 1 = REVERB
        .in_l   (fxi_l),
        .in_r   (fxi_r),
        .out_l  (rev_l),
        .out_r  (rev_r)
    );

    fx_delay u_fx_delay (
        .clk    (clk_sys),
        .rst_n  (por_n),
        .tick   (tick),
        .enable (fx_dly_on),           // 1 = DELAY
        .in_l   (fxi_l),
        .in_r   (fxi_r),
        .out_l  (dly_l),
        .out_r  (dly_r)
    );

    //  效果器输出选择：
    //      1(REVERB) → 混响输出
    //      2(DELAY)  → 延迟输出
    //      0 / 3 / 4（NONE / SUSTAIN / CHORUS）→ 合唱模块的输出，
    //          其中 NONE / SUSTAIN 时合唱 enable=0，输出就是寄存后的干声。
    //  ★ SUSTAIN 不需要在这里改什么：它作用在音源包络上（见 u_piano.sustain），
    //    所以走干声通路就是对的。
    //  走 cho_l/cho_r 而不是直接取 fxi，是为了保持恒定延迟、避免切档咔哒。
    wire signed [15:0] fxd_l = fx_dly_on ? dly_l : (fx_rev_on ? rev_l : cho_l);
    wire signed [15:0] fxd_r = fx_dly_on ? dly_r : (fx_rev_on ? rev_r : cho_r);

    // Register the manual/combined score gain before limiting.
    reg signed [31:0] gy_l, gy_r;
    always @(posedge clk_sys) begin
        if (!por_n) begin
            gy_l <= 32'sd0;
            gy_r <= 32'sd0;
        end
        else begin
            gy_l <= mixed_score ? mixed_l : sat_pre(mix_l_r, timbre_r);
            gy_r <= mixed_score ? mixed_r : sat_pre(mix_r_r, timbre_r);
        end
    end

    // Hold the effect output; I2S captures complete stereo frames.
    reg signed [15:0] out_l_r, out_r_r;
    always @(posedge clk_sys) begin
        // ★ 测试模式下直接输出 8 路正弦，绕过软限幅：
        //   sat_pre 会按音色乘 ×2/×8/×16，而 test_sine8 已经归一化到满幅，
        //   再过一遍增益会直接削顶。
        out_l_r <= test_mode ? test_snd : fxd_l;
        out_r_r <= test_mode ? test_snd : fxd_r;
    end

    //======================================================================
    //  32 段常数-Q 实时频谱
    //    输入取 out_l_r —— 就是最终送 DAC 的满幅信号，不是中间量
    //    输出直接送到顶层端口，由合并顶层里（clk_p 域）的渲染器消费
    //======================================================================
    spec_cqt u_spec (
        .clk        (clk_sys),
        .rst_n      (por_n),
        .tick       (tick),
        .sample     (out_l_r),
        .bands      (SPEC_BANDS),
        .bands_tick (SPEC_TICK)
    );

    //======================================================================
    //  UI 状态总线 → HDMI 渲染器
    //    ★★ 拼接必须凑成 16 位！原来写成
    //          assign UI_INFO = {transpose, fx_r, timbre_r, ui_mode};
    //       只有 14 位，赋给 16 位端口时左边补 2 个 0，
    //       结果所有字段整体错位 2 位：渲染器读到的音色其实是 fx、
    //       效果器其实是音色、移调只剩 transpose[7:2]。
    //    位图（与 hdmi_ui3_top 的解读一一对应）：
    //        [17:10] transpose  [9:8] flt  [7:6] agl  [5:4] fx  [3:2] timbre  [1:0] mode
    //======================================================================
    assign UI_INFO = {transpose, flt_sel, agl_sel, fx_r, timbre_r, ui_mode};

    //======================================================================
    //  COMPONENT 64：把 128 个正弦分量两两合并成 64 根柱
    //
    //  数据源按音色二选一（和音源 mux 用同一个 is_harm）：
    //      钢琴/古筝 → add_engine8       的 part_idx/part_amp（128 分量）
    //      唢呐/笛子 → add_engine_harm   的 part_idx/part_amp（谐波表）
    //
    //  显示策略（2026-11-01 改，原版是「瞬时值 + 冻结」，会闪一下就没了）：
    //    ① note-on 时【清空全部 64 根】——立即重画，快奏不糊
    //       声部扫完 128 分量只要 1 个样点周期 = 20.5 us，
    //       60 fps 的一帧是 16.7 ms，所以视觉上是瞬间完成
    //    ② 峰值保持：新值 > 当前值就立即上升（0 延迟）
    //    ③ 回落：每 ~94 个样点全部降 1 级 → 255 级约 0.49 s 落满
    //
    //  快奏时每次按键图瞬间换成新音的包络（不会把上一个音的残留糊上来）；
    //  按住不松时峰值持续刷新、柱子稳定；松手后 0.5 s 平滑落光。
    //======================================================================
    localparam integer FS_HZ          = 48828;       // 音频样点率
    localparam integer COMP_FALL_MS   = 500;         // 回落时间
    // 每降 1 级间隔的样点数：0.5 s / 255 级 ≈ 94 个样点
    localparam integer COMP_FALL_STEP = (FS_HZ / 1000) * COMP_FALL_MS / 255;

    // 音色二选一
    wire [6:0] src_idx = is_harm ? harm_idx : comp_idx;
    wire [7:0] src_amp = is_harm ? harm_amp : comp_amp;
    wire       src_vld = is_harm ? harm_vld : comp_vld;

    //======================================================================
    //  ★★ 必须打一拍再进 comp_bar（2026-11-01）
    //
    //  数据源是「8 个声部 → last_v 选一个」→ 再按音色二选一，组合链是
    //      last_v → 8:1 mux（7 位）→ 2:1 mux → comp_idx[6:1] → 64 路写译码
    //  64 路译码本身已经不短，前面再串两级 mux，实测
    //      u_piano/last_v_1_s1/Q → comp_bar[61]/CE = 20.13 ns（SETUP −0.130）
    //  在 last_v 选择之后加一级寄存器，把 mux 与译码分开。
    //  单拍脉冲 src_vld 与 idx/amp 同拍寄存，配对关系不变。
    //======================================================================
    reg [6:0] s_idx_r;
    reg [7:0] s_amp_r;
    reg       s_vld_r;

    always @(posedge clk_sys) begin
        s_idx_r <= src_idx;
        s_amp_r <= src_amp;
        s_vld_r <= src_vld;
    end

    // 任意一个声部被触发 → 立即清空重画
    wire comp_clr = (|eng_trig) | sua_trig;

    ui_component_bars #(.FALL_STEP(COMP_FALL_STEP)) u_component_bars(
        .clk(clk_sys),.rst_n(engine_rst_n),.tick(tick),.clear(comp_clr),
        .index(s_idx_r),.amplitude(s_amp_r),.valid(s_vld_r),.bars(COMP_AMP));

    //======================================================================
    //  李萨如（相位图）取样
    //    取最终送 DAC 的 out_l_r（已含软限幅），每样点锁一次 + 翻转标志。
    //    不能用 L/R 做 XY：本工程是单声道，左右完全一样 → 会画成一条直线。
    //======================================================================
    reg signed [15:0] scope_smp;
    reg               scope_tog;

    always @(posedge clk_sys) begin
        if (!por_n) begin
            scope_smp <= 16'sd0;
            scope_tog <= 1'b0;
        end
        else if (tick) begin
            scope_smp <= out_l_r;
            scope_tog <= ~scope_tog;
        end
    end

    assign SCOPE_SMP = scope_smp;
    assign SCOPE_TOG = scope_tog;

    // note-on 触发：comp_clr 就是「任意声部被触发」的单拍脉冲
    always @(posedge clk_sys) begin
        if (!por_n)         SCOPE_TRG <= 1'b0;
        else if (comp_clr)  SCOPE_TRG <= ~SCOPE_TRG;
    end

    //======================================================================
    //  灯带控制信号跨时钟域同步：clk_sys → CLOCK_50
    //
    //  u_led 必须用 CLOCK_50 直连（上板验证过的配置，不走 PLL），
    //  但它的全部控制信号都产生于 clk_sys 域（key_state / timbre /
    //  engine_rst_n）。直接跨域会让 PnR 报出 22 条 hold
    //  违例（−0.726 ns）：CLK_SYS 与 CLOCK_50 虽然同为 50 MHz，却分布在
    //  不同时钟树分支（PBR1/2 与 PBR2/3），实测偏斜约 0.7 ns，数据会跑赢
    //  捕获时钟。
    //
    //  这些信号全部是「按键级」慢变量（去抖后 >10 ms 才变一次），
    //  打两拍同步即可，对视觉效果无任何影响。
    //  时序约束侧对应 piano64.sdc 里的
    //      set_false_path -from [get_clocks CLK_SYS] -to [get_clocks CLOCK_50]
    //  （标准 CDC 处理：同步器隔离后不再对跨域路径做时序检查）
    //======================================================================
    reg [7:0]  led_kst_s0,  led_kst_s1;     // 8 键按住状态
    reg [63:0] led_kvel_s0, led_kvel_s1;    // 8 键力度
    reg [1:0]  led_tmb_s0,  led_tmb_s1;     // 音色
    reg [2:0]  led_fx_s0,   led_fx_s1;      // 效果器档位（0..4）
    reg        led_trl_s0,  led_trl_s1;     // 移调闪光有效
    reg        led_trn_s0,  led_trn_s1;     // 移调方向（1=降）
    reg        led_rst_s0,  led_rst_s1;     // 复位

    always @(posedge CLOCK_50) begin
        led_kst_s0  <= score_mode ? {1'b0,song_expected} : note_key_state;
        led_kvel_s0 <= score_mode ? {8{8'd180}} : note_key_vel;
        led_tmb_s0  <= timbre_r;
        led_fx_s0   <= fx_r;
        led_trl_s0  <= tr_led_on;
        led_trn_s0  <= tr_led_neg;
        led_rst_s0  <= engine_rst_n;

        led_kst_s1  <= led_kst_s0;
        led_kvel_s1 <= led_kvel_s0;
        led_tmb_s1  <= led_tmb_s0;
        led_fx_s1   <= led_fx_s0;
        led_trl_s1  <= led_trl_s0;
        led_trn_s1  <= led_trn_s0;
        led_rst_s1  <= led_rst_s0;
    end

    //======================================================================
    //  灯带（布局见 ws2812_keyind.v 文件头）
    //======================================================================
    ws2812_keyind #(
        .N_LED (20),
        .DIAG  (0)
    ) u_led (
        // ★★ 灯带时钟用【CLOCK_50 直连】，和验证正常的 led_align 工程完全一致
        //    （PLL 输出 clk_sys 虽然频率相同，但相位/抖动不同，怀疑是卡死的原因）
        //    所有输入都经过上面的两拍同步，不再直接跨域
        .clk      (CLOCK_50),
        .rst_n    (led_rst_s1),
        .key_on   (led_kst_s1),
        .key_vel  (led_kvel_s1),
        .timbre   (led_tmb_s1),
        .fx       (led_fx_s1),
        .tr_led   (led_trl_s1),
        .tr_neg   (led_trn_s1),
        .dout     (DOUT)
    );

    //======================================================================
    //  I2S
    //======================================================================
    pcm5102a_tx #(.DIV(16), .SLOTS(64)) u_tx (
        .clk        (clk_sys),
        .rst_n      (por_n),
        .sample_l   (out_l_r),
        .sample_r   (out_r_r),
        .sample_tick(tick),
        .bck        (AUD_BCK),
        .lrck       (AUD_LRCK),
        .din        (AUD_DIN)
    );

    //======================================================================
    //  DDR3 1 GiB —— 第 2 步：SD 卡 P64.BIN → DDR3（含读回校验）
    //    用户接口在 clk_x1(100MHz) 域；sd_ddr_loader 也整块跑在 clk_x1，
    //    所以 SD 读字节 / 拼 256 位字 / 写 DDR / 读回校验 全程同域，无 CDC。
    //======================================================================
    wire        ddr_init_done;
    wire        ddr_pll_locked;
    wire        ddr_clk_x1;
    wire [2:0]  ddr_app_cmd;
    wire        ddr_app_en;
    wire [28:0] ddr_app_addr;
    wire [255:0] ddr_app_wdf_data;
    wire        ddr_app_wdf_wren;
    wire        ddr_app_wdf_end;
    wire [31:0] ddr_app_wdf_mask;
    wire        ddr_app_burst;
    wire        ddr_app_rdy;
    wire        ddr_wr_data_rdy;
    wire        ddr_rd_valid;
    wire [255:0] ddr_rd_data;

    wire [2:0] phy_cmd;
    wire phy_en,phy_wren,phy_ready,phy_wready,phy_rvalid;
    wire [28:0] phy_addr;
    wire [255:0] phy_wdata,phy_rdata;
    ddr_ui_pipeline u_ddr_pipe(.clk(ddr_clk_x1),.rst_n(ddr_init_done),
        .s_cmd(ddr_app_cmd),.s_en(ddr_app_en),.s_addr(ddr_app_addr),
        .s_wdata(ddr_app_wdf_data),.s_wren(ddr_app_wdf_wren),
        .s_ready(ddr_app_rdy),.s_wready(ddr_wr_data_rdy),.s_rvalid(ddr_rd_valid),.s_rdata(ddr_rd_data),
        .m_cmd(phy_cmd),.m_en(phy_en),.m_addr(phy_addr),.m_wdata(phy_wdata),.m_wren(phy_wren),
        .m_ready(phy_ready),.m_wready(phy_wready),.m_rvalid(phy_rvalid),.m_rdata(phy_rdata));

    ddr_wrap u_ddr (
        .clk        (CLOCK_50),
        .rst_n      (por_n & RESET_n),
        .init_done  (ddr_init_done),
        .clk_x1     (ddr_clk_x1),
        .pll_locked (ddr_pll_locked),

        .app_cmd        (phy_cmd),
        .app_en         (phy_en),
        .app_addr       (phy_addr),
        .app_wdf_data   (phy_wdata),
        .app_wdf_wren   (phy_wren),
        .app_wdf_end    (phy_wren),
        .app_wdf_mask   (ddr_app_wdf_mask),
        .app_burst      (ddr_app_burst),
        .app_rdy        (phy_ready),
        .wr_data_rdy    (phy_wready),
        .app_rd_data_valid (phy_rvalid),
        .app_rd_data    (phy_rdata),

        .ddr_addr   (ddr_addr),
        .ddr_bank   (ddr_bank),
        .ddr_cs     (ddr_cs),
        .ddr_ras    (ddr_ras),
        .ddr_cas    (ddr_cas),
        .ddr_we     (ddr_we),
        .ddr_ck     (ddr_ck),
        .ddr_ck_n   (ddr_ck_n),
        .ddr_cke    (ddr_cke),
        .ddr_odt    (ddr_odt),
        .ddr_reset_n(ddr_reset_n),
        .ddr_dm     (ddr_dm),
        .ddr_dq     (ddr_dq),
        .ddr_dqs    (ddr_dqs),
        .ddr_dqs_n  (ddr_dqs_n)
    );

    //----------------------------------------------------------------------
    //  SD → DDR 加载器（clk_x1 = 100 MHz 域）
    //----------------------------------------------------------------------
    wire        ld_done, ld_ok;
    wire [31:0] ld_nbytes, ld_nwords, ld_ov;
    wire [11:0] ld_nfiles, ld_fileno;
    wire [3:0]  ld_stage;          // 加载阶段（clk_x1 域，仅用于串口报告）

    // 加载器独占的 DDR 口（写通道 + 命令通道）
    wire [2:0]   ld_app_cmd;
    wire         ld_app_en;
    wire [28:0]  ld_app_addr;
    wire [255:0] ld_app_wdf_data;
    wire         ld_app_wdf_wren;
    wire         ld_app_wdf_end;
    wire [31:0]  ld_app_wdf_mask;

    // 引擎（add_engine8）的 DDR 口：只有读通道
    wire [2:0]   eng_app_cmd;
    wire         eng_app_en;
    wire [28:0]  eng_app_addr;

    sd_ddr_loader #(
        .CLK50_HZ (50_000_000),
        .CLK100_HZ(100_000_000),
        .BOOT_MS  (300)
    ) u_ld (
        // ★ 双时钟：SD/FAT 栈跑 50 MHz（组合乘法在 100 MHz 下 −6.2 ns 违例），
        //   拼字/写 DDR/读回校验跑 clk_x1（DDR MC 用户域），中间 sd_async_fifo
        .clk50       (CLOCK_50),
        .clk100      (ddr_clk_x1),
        .arst_n      (por_n & RESET_n),
        .calib_done  (ddr_init_done),
        .dbg_pll     (ddr_pll_locked),
        .dbg_por_n   (por_n),
        .dbg_reset_n (RESET_n),

        .sd_clk      (reader_sdclk),
        .sd_cmd      (SD_CMD),
        .sd_dat0     (SD_DAT0),

        .app_cmd        (ld_app_cmd),
        .app_en         (ld_app_en),
        .app_addr       (ld_app_addr),
        .app_wdf_data   (ld_app_wdf_data),
        .app_wdf_wren   (ld_app_wdf_wren),
        .app_wdf_end    (ld_app_wdf_end),
        .app_wdf_mask   (ld_app_wdf_mask),
        .app_burst      (),
        .app_rdy        (ddr_app_rdy),
        .wr_data_rdy    (ddr_wr_data_rdy),
        .app_rd_data_valid (ddr_rd_valid),
        .app_rd_data    (ddr_rd_data),

        .load_done   (ld_done),
        .load_ok     (ld_ok),
        .stage       (ld_stage),
        .nbytes      (ld_nbytes),
        .nwords      (ld_nwords),
        .err_ov      (ld_ov),
        .nfiles      (ld_nfiles),
        .file_no     (ld_fileno),

        .store_request(store_request),.store_grant(store_grant),
        .song_request(song_request),.song_request_index(song_selected),
        .song_file_count(sd_song_count),.song_ids(sd_song_ids),.song_catalog_done(sd_song_catalog),
        .song_busy(sd_song_busy),.song_byte(sd_song_byte),.song_byte_valid(sd_song_valid),
        .song_begin(sd_song_begin),.song_end(sd_song_end),.song_error(sd_song_error),
        .uart_txd    (ld_uart_txd)
    );

    //======================================================================
    //  DDR 用户口：4 路轮询仲裁（clk_x1 = 100 MHz 域）
    //
    //  为什么要分两段（而不是全部走仲裁器）
    //    sd_ddr_loader 是「app_en 在 app_rdy 为高的那一拍才拉高」的风格
    //    （assign app_en = cmd_valid && app_rdy），和仲裁器要求的
    //    「保持请求直到 ack」不兼容，硬塞进去得改加载器，回归风险大。
    //    而它只在开机跑一次、ld_done 之后永久空闲，所以：
    //      · !ld_done —— 加载器独占直连，与改动前逐字节等价（零风险）
    //      ·  ld_done —— 引擎 / 谐波 / 效果器 三路走仲裁器
    //    仲裁器的复位信号里带上 ld_done，开机阶段它始终处于复位态、
    //    grant 恒为 0，不会去抢加载器的总线。
    //
    //  ★ 按 grant 过滤回馈信号
    //    没拿到授权的客户若看到全局 app_rdy=1，会以为命令被接受了 → 命令丢失。
    //    所以 eng / sua 的「读数据」和 eng 的「app_rdy」都必须过滤。
    //    唯一的例外是 sua 的 app_rdy —— 它只用来判断「能发命令了吗」，
    //    命令本身由 sua_q_* 排队器保管，过滤它反而会死锁（见客户 1 处说明）。
    //======================================================================
    wire [3:0]    arb_req;
    wire [3:0]    arb_gnt;
    wire [3:0]    arb_ack;
    wire [3:0]    arb_abort;
    wire [3:0]    arb_wdf_vld;
    wire [11:0]   arb_cmd;       // 4 × 3
    wire [115:0]  arb_addr;      // 4 × 29
    wire [1023:0] arb_wdf;       // 4 × 256

    wire [2:0]    arb_app_cmd;
    wire          arb_app_en;
    wire [28:0]   arb_app_addr;
    wire [255:0]  arb_app_wdf_data;
    wire          arb_app_wdf_wren;
    wire          arb_app_wdf_end;
    wire [31:0]   arb_app_wdf_mask;

    // ── 客户 0：钢琴 / 古筝 参数表 DMA（只读，保持请求式）──────────────
    assign arb_req[0]             = eng_app_en;
    assign arb_cmd[0*3   +: 3]    = eng_app_cmd;
    assign arb_addr[0*29 +: 29]   = eng_app_addr;
    assign arb_wdf[0*256 +: 256]  = 256'd0;
    assign arb_wdf_vld[0]         = 1'b0;

    // ── 客户 1：唢呐 / 笛子 谐波表 DMA（只读，保持请求式）──────────────
    //  ★★ 这一路必须加「1 拍脉冲 → 保持请求」的排队器，不能像客户 0 那样直连。
    //     suona_dma.v 的 app_en 是「看到 app_rdy 后打一拍的脉冲」：
    //         S_DESC / S_CMD:  if (app_rdy) begin en_r <= 1'b1; st <= ...; end
    //     而仲裁器要求「保持请求直到 ack」。如果把 app_en 直接当 m_req：
    //       · 脉冲那一拍 arb_gnt 还是 0（仲裁器输出是寄存的）→ 命令没发出去
    //       · 下一拍 arb_gnt 来了但 req 已经掉了 → 永远发不出命令
    //       → 只能等超时；同时 suona_dma 自己的 tmo(4000) 会先把每段都跳掉
    //       → 听感就是完全静音（实测正是如此）
    //     深度 1 就够：suona 一次只可能有一个未完成的读。
    wire sua_arb_rst_n = por_n & RESET_n & ld_done;

    reg        sua_q_pend;
    reg [2:0]  sua_q_cmd;
    reg [28:0] sua_q_addr;

    always @(posedge ddr_clk_x1) begin
        if (!sua_arb_rst_n) begin
            sua_q_pend <= 1'b0;
            sua_q_cmd  <= 3'b001;
            sua_q_addr <= 29'd0;
        end
        //  注意优先级：同一拍既「来新脉冲」又「上一笔 ack」时，以新脉冲为准
        else if (sua_app_en && (!sua_q_pend || arb_ack[1] || arb_abort[1])) begin
            sua_q_pend <= 1'b1;
            sua_q_cmd  <= sua_app_cmd;
            sua_q_addr <= sua_app_addr;
        end
        else if (arb_ack[1] || arb_abort[1]) begin
            sua_q_pend <= 1'b0;
        end
    end

    assign arb_req[1]             = sua_q_pend;
    assign arb_cmd[1*3   +: 3]    = sua_q_cmd;
    assign arb_addr[1*29 +: 29]   = sua_q_addr;
    assign arb_wdf[1*256 +: 256]  = 256'd0;
    assign arb_wdf_vld[1]         = 1'b0;

    // ── 客户 2：效果器 DDR 延迟线（尚未接入，先恒空闲）──────────────────
    assign arb_req[2]             = 1'b0;
    assign arb_cmd[2*3   +: 3]    = 3'b001;
    assign arb_addr[2*29 +: 29]   = 29'd0;
    assign arb_wdf[2*256 +: 256]  = 256'd0;
    assign arb_wdf_vld[2]         = 1'b0;

    // ── 客户 3：保留（DDR 自检 / 未来扩展）────────────────────────────
    assign arb_req[3]             = 1'b0;
    assign arb_cmd[3*3   +: 3]    = 3'b001;
    assign arb_addr[3*29 +: 29]   = 29'd0;
    assign arb_wdf[3*256 +: 256]  = 256'd0;
    assign arb_wdf_vld[3]         = 1'b0;

    //   按 grant 过滤后回馈给客户
    assign eng_app_rdy  = ddr_app_rdy  & arb_gnt[0];
    assign eng_rd_valid = ddr_rd_valid & arb_gnt[0];
    //  suona 的 app_rdy 【不过滤】：它只拿这个当「可以发命令了」的使能，
    //  命令本身会被上面的 sua_q_* 排队器保管。如果过滤就会死锁：
    //  仲裁器要请求才给授权，而 suona 要授权才发请求。
    //  读数据仍然按 grant 过滤（必须），否则会拿到别人的数据。
    assign sua_app_rdy  = ddr_app_rdy;
    assign sua_rd_valid = ddr_rd_valid & arb_gnt[1];

    //   现有 DMA 送出的 app_addr 已经是 <<3 之后的 DDR 地址，
    //   所以 ADDR_SHIFT = 0（不要再左移一次）
    ddr_arb #(
        .N         (4),
        .TIMEOUT   (4096),
        .ADDR_SHIFT(0)
    ) u_ddr_arb (
        .clk      (ddr_clk_x1),
        .rst_n    (por_n & RESET_n & ld_done),   // 开机阶段压在复位态

        .m_req      (arb_req),
        .m_cmd      (arb_cmd),
        .m_addr     (arb_addr),
        .m_wdf_data (arb_wdf),
        .m_wdf_vld  (arb_wdf_vld),
        .m_gnt      (arb_gnt),
        .m_ack      (arb_ack),
        .m_abort    (arb_abort),

        .app_cmd        (arb_app_cmd),
        .app_en         (arb_app_en),
        .app_addr       (arb_app_addr),
        .app_wdf_data   (arb_app_wdf_data),
        .app_wdf_wren   (arb_app_wdf_wren),
        .app_wdf_end    (arb_app_wdf_end),
        .app_wdf_mask   (arb_app_wdf_mask),
        .app_burst      (),
        .app_rdy        (ddr_app_rdy),
        .wr_data_rdy    (ddr_wr_data_rdy),
        .app_rd_data_valid (ddr_rd_valid),
        .app_rd_data    (ddr_rd_data)
    );

    //----------------------------------------------------------------------
    //  最终二选一：开机阶段给加载器，加载完成后给仲裁器
    //  切换条件里带上 !ld_app_en && !ld_app_wdf_wren，彻底消除
    //  「ld_done 刚拉高、加载器还剩一拍没收尾」的重叠窗口
    //----------------------------------------------------------------------
    wire ddr_sel_arb = ld_done && !ld_app_en && !ld_app_wdf_wren;

    assign ddr_app_cmd      = ddr_sel_arb ? arb_app_cmd      : ld_app_cmd;
    assign ddr_app_en       = ddr_sel_arb ? arb_app_en       : ld_app_en;
    assign ddr_app_addr     = ddr_sel_arb ? arb_app_addr     : ld_app_addr;
    assign ddr_app_wdf_data = ddr_sel_arb ? arb_app_wdf_data : ld_app_wdf_data;
    assign ddr_app_wdf_wren = ddr_sel_arb ? arb_app_wdf_wren : ld_app_wdf_wren;
    assign ddr_app_wdf_end  = ddr_sel_arb ? arb_app_wdf_end  : ld_app_wdf_end;
    assign ddr_app_wdf_mask = ddr_sel_arb ? arb_app_wdf_mask : ld_app_wdf_mask;
    assign ddr_app_burst    = 1'b0;

    //======================================================================
    //  六路光敏前端：TDM 发射 + AD7606 双串行 + 亮暗差分 + 串口上报
    //
    //  时序完全复现 F407（队友已调好）：
    //      时隙 2 ms / 六路一轮 12 ms
    //      0.4 ms 采亮值、0.7 ms 关发射管、1.7 ms 采暗值
    //      每路 diff = 亮 − 暗，再做 4 点滑动平均
    //
    //  ★ ADC 上电需要 1 ms 的 RESET 脉冲，这段时间发 start 会被丢掉。
    //    所以先锁存一个 opt_go（ADC 说 ready 之后才放行），再用它当 TDM 的复位，
    //    这样第一帧不会丢。
    //======================================================================
    wire         opt_ready;
    reg          opt_go;
    always @(posedge clk_sys) begin
        if (!engine_rst_n)    opt_go <= 1'b0;
        else if (opt_ready)   opt_go <= 1'b1;
    end
    wire opt_tdm_rst_n = engine_rst_n & opt_go;

    wire [5:0]        opt_emit;
    wire              opt_conv_on, opt_conv_off, opt_round_stb;
    wire [2:0]        opt_slot;
    wire [15:0]       opt_round;

    ir_tdm_ctrl #(
        .CLK_HZ        (50_000_000),
        .SLOT_MS       (2),
        .ON_US         (400),
        .EMITOFF_US    (700),
        .DARK_US       (1700),
        .NCH           (6)
    ) u_ir_tdm (
        .clk       (clk_sys),
        .rst_n     (opt_tdm_rst_n),
        .emitter   (opt_emit),
        .conv_on   (opt_conv_on),
        .conv_off  (opt_conv_off),
        .slot_idx  (opt_slot),
        .round_stb (opt_round_stb),
        .round_cnt (opt_round)
    );

    // ★ 发射管极性：默认高有效。若板子是低有效，把下面这行的 ~ 打开。
    assign IR_EMIT = opt_emit;
    // assign IR_EMIT = ~opt_emit;

    wire [127:0] opt_ch_flat;
    wire         opt_done;
    wire [2:0]   opt_hw_err;

    ad7606_serial #(
        .SCLK_HALF   (4),          // 6.25 MHz
        .CONVST_CYC  (12),
        .CS_SETUP    (8)
    ) u_ad7606 (
        .clk        (clk_sys),
        .rst_n      (engine_rst_n),
        .start      (opt_conv_on | opt_conv_off),
        .ch_flat    (opt_ch_flat),
        .done       (opt_done),
        .ready      (opt_ready),
        .hw_err     (opt_hw_err),
        .adc_convst (ADC_CONVST),
        .adc_reset  (ADC_RST),
        .adc_cs_n   (ADC_CSN),
        .adc_sclk   (ADC_SCLK),
        .adc_busy   (ADC_BUSY),
        .adc_douta  (ADC_DOUTA),
        .adc_doutb  (ADC_DOUTB)
    );

    wire [107:0] opt_diff_flat, opt_flt_flat;
    wire         opt_frame_valid;
    wire [15:0]  opt_frame_cnt;

    ir_diff_filter #(.NCH(6)) u_ir_diff (
        .clk         (clk_sys),
        .rst_n       (engine_rst_n),
        .done        (opt_done),
        .ch_flat     (opt_ch_flat),
        .slot_idx    (opt_slot),
        .is_on       (|opt_emit),
        .diff_flat   (opt_diff_flat),
        .flt_flat    (opt_flt_flat),
        .frame_valid (opt_frame_valid),
        .frame_cnt   (opt_frame_cnt)
    );

    wire [7:0] opt_uart_char;
    wire       opt_uart_vld, opt_uart_busy, opt_uart_txd;

    uart_tx #(.CLK_HZ(50_000_000), .BAUD(115_200)) u_opt_uart (
        .clk   (clk_sys),
        .rst_n (engine_rst_n),
        .dbyte (opt_uart_char),
        .send  (opt_uart_vld),
        .busy  (opt_uart_busy),
        .txd   (opt_uart_txd)
    );

    //======================================================================
    //  光学控制律：Σ/质心 → 弯音 + 力度
    //======================================================================
    wire signed [23:0] opt_rho_raw, opt_rho_dc, opt_rho_ac, opt_ac_env;
    wire [15:0]        opt_half_period;

    opt_feat #(
        .NCH(6), .LP_SHIFT(3), .ENV_SHIFT(2), .AC_DB(256)
    ) u_opt_feat (
        .clk         (clk_sys),
        .rst_n       (engine_rst_n),
        .frame_valid (opt_frame_valid),
        .raw_flat    (opt_diff_flat),
        .rho_raw     (opt_rho_raw),
        .rho_dc      (opt_rho_dc),
        .rho_ac      (opt_rho_ac),
        .ac_env      (opt_ac_env),
        .half_period (opt_half_period),
        .frame_cnt   ()
    );

    wire [15:0] opt_x_q8;
    wire [23:0] opt_pos_sum;
    wire        opt_x_valid;

    opt_pos #(.NCH(6)) u_opt_pos (
        .clk         (clk_sys),
        .rst_n       (engine_rst_n),
        .frame_valid (opt_frame_valid),
        .raw_flat    (opt_diff_flat),
        .x_q8        (opt_x_q8),
        .sum_pos     (opt_pos_sum),
        .x_valid     (opt_x_valid),
        .x_frame     ()
    );

    wire signed [15:0] opt_bend_cent;
    wire        [15:0] opt_bend_q14_ctl;
    wire               opt_trem_en;
    wire               opt_vib_en;
    wire               opt_art;
    wire               opt_stop;
    wire               opt_hand;

    position_control u_opt_ctl (
        .clk         (clk_sys),
        .rst_n       (engine_rst_n),
        .frame_valid (opt_frame_valid),
        .x_q8        (opt_x_q8),
        .x_valid     (opt_x_valid),
        .rho_dc      (opt_rho_dc),
        .rho_raw     (opt_rho_raw),
        .rho_ac      (opt_rho_ac),
        .ac_env      (opt_ac_env),
        .half_period (opt_half_period),
        .bend        (opt_bend_cent),
        .bend_q14    (opt_bend_q14_ctl),  // ★ 2^(cent/1200) 查表得到，不再用线性近似
        .vel         (opt_vel),
        .trem_en     (opt_trem_en),
        .vib_en      (opt_vib_en),
        .art_pulse   (opt_art),
        .stop_hold   (opt_stop),
        .hand_on     (opt_hand)
    );

    // ★★★ 临时诊断（DIAG_FORCE_BEND=1）：把音高比钉死成常量，绕开控制器。
    //   24602/16384 = 1.5017 → +702 音分 ≈ 纯五度。
    //   ★ 2026-11-03 用它二分出真因：弯音比乘在【已回绕的相位】上 → 音高不变
    //     只变噪（旧算法得到 frac(r·frac(f·t))，周期仍是 1/f）。
    //     add_engine_harm 已改成乘在【相位增量】上，本开关恢复正常。
    localparam integer DIAG_FORCE_BEND = 0;
    assign opt_bend_q14 = DIAG_FORCE_BEND ? 16'd24602 : opt_bend_q14_ctl;

    // 手离开 6 s（512 帧 ≈ 6.1 s）后自动回退到键盘力度，避免没手时音量被锁死。
    //
    // ★★ 计数必须【按帧】递减，不能按时钟！
    //    原来写成 if (opt_hold != 0) opt_hold <= opt_hold - 1;
    //    在 posedge clk_sys 下是每 20 ns 减一次：512 拍 = 10.2 us，
    //    而帧周期是 12 ms → opt_en 占空比只有 0.08%，
    //    opt_act 几乎永远为 0，光学力度从来没生效过（弯音不走 opt_en，所以弯音正常）。
    reg [9:0] opt_hold;
    always @(posedge clk_sys) begin
        if (!engine_rst_n)                                 opt_hold <= 10'd0;
        else if (!opt_frame_valid)                         opt_hold <= opt_hold;
        else if (opt_vel > 8'd8)                           opt_hold <= 10'd512;
        else if (opt_hold != 10'd0)                        opt_hold <= opt_hold - 10'd1;
    end
    assign opt_en = (opt_hold != 10'd0);

    report_feat u_report_feat (
        .clk         (clk_sys),
        .rst_n       (engine_rst_n),
        .frame_valid (opt_frame_valid),
        .rho_raw     (opt_rho_raw),
        .rho_dc      (opt_rho_dc),
        .rho_ac      (opt_rho_ac),
        .ac_env      (opt_ac_env),
        .half_period (opt_half_period),
        .x_q8        (opt_x_q8),
        .bend        (opt_bend_cent),
        .vel         (opt_vel),
        .hw_err      (opt_hw_err),
        .uart_char   (opt_uart_char),
        .uart_valid  (opt_uart_vld),
        .uart_ready  (~opt_uart_busy)
    );

    //----------------------------------------------------------------------
    //  UART 复用：DDR 加载期间给加载器，加载完成后给光敏前端
    //  （加载器在 ld_done 之后永久空闲，txd 保持高电平，无冲突）
    //----------------------------------------------------------------------
    wire ld_uart_txd;
    // ★★ 调试：强制光学上报占用 UART_TX，不再等 ld_done。
    //    反复抳插 USB 后串口一直 0 字节，怀疑是 ld_done 没拉高导致
    //    UART_TX 一直挂在加载器的空闲高电平上。加载器只用 RX 收命令，
    //    TX 只是它回话，占掉不影响功能。调完改回复用。
    assign UART_TX = opt_uart_txd;
    // assign UART_TX = ld_done ? opt_uart_txd : ld_uart_txd; (原版)

endmodule

`default_nettype wire
