PlanteAmigor/Piano_64/src/spec_cqt.v

//==========================================================================
//  spec_cqt —— 32 段变窗长常数-Q 实时频谱分析
//
//  ════════ 为什么不用 FFT ════════
//  时频不确定性 Δf·T ≥ 1。我们要 32 段覆盖 40 Hz–16 kHz（8.6 个倍频程）：
//      最低段 40 Hz，带宽 8.5 Hz  → 必须 N ≥ fs/8.5 ≈ 5700
//      最高段 16 kHz，带宽 2800 Hz → 只要 N ≈ 28
//  FFT / 滑动 DFT 的 N 对全部 bin 是同一个，取 5700 则高频段白算 200 倍；
//  取 1024 则 40/50/63/79 Hz 全部挤进同一个 bin（实测见模型脚本）。
//
//  本模块每段窗长独立：
//      段 0 (40 Hz)  N = 11450 → 234 ms 窗，4.3 fps
//      段 31(16 kHz) N = 28    → 0.57 ms 窗，1700 fps
//  低频本来变化就慢，慢刷新不影响观感；高频刷新快，动画反而流畅。
//
//  ════════ 为什么不用实 Goertzel ════════
//  实 Goertzel 的递推  s[n] = x[n] + 2cos(ω)s[n-1] − s[n-2]
//  中间状态峰值 ≈ A·N/(2 sinω)：40 Hz 时 1/(2 sinω) = 97 倍，
//  满幅 17.5e9，32 位直接溢出 813%（模型实测）。
//  改用【复单极点谐振器】 X[n] = x[n]·w[n] + e^{-jω}·X[n−1]，
//  状态增长恒为 A·N/2，与频率无关 → 位宽统一。
//  代价 4 次乘法（vs 1 次），32 段时分复用后只占时钟的 ~2%。
//
//  ════════ 为什么必须加窗 ════════
//  不加窗（矩形）旁瓣只有 −13 dB，40 Hz 的音会漏到 100 Hz 的段。
//  Hann 主瓣宽 4 bin，所以窗长要取 2 倍最小值才能压住邻段：
//      N×1 + Hann → 邻段 −4.6 dB  （主瓣横跨 ±2 段，最差组合）
//      N×2 + Hann → 邻段 −15.5 dB，隔一段 −45.6 dB   ← 本设计
//      N×4 + Hann → 邻段 −46.5 dB，但段 0 要 469 ms，太慢
//
//  ════════ 定标链（全定点，模型验证误差 0/255）════════
//      sample(16b) × win(Q1.15,16b) >>> 22      → 幅度 256
//      X(32b) ← xw + (X·e^{-jω} >>> 23)         → 峰值峰值 1.47e6（21 bit）
//      P = re²+im²                              → 最大 2^42
//      L2  = log2(P) 的 Q8.8（前导 1 + 尾数表）
//      rel = (L2>>>1) − log2(N_k)·256           → 归一化到「每样点幅度」尺度
//      bar = clamp((rel + 759)·205 >>> 11, 0, 255)   ← −60 dB → 0，满刻度 → 255
//
//  ════════ 时序 ════════
//  每采样 1024 拍。32 段 × 最多 6 拍 = 192 拍，占 19%。
//  S_RD/MUL/ADD/WB 4 拍常态；块结束时多 2 拍（SQ/LOG/BAR）做幅度与对数。
//
//  资源：状态 32×32×2 + 32×24 = 2816 bit（分布式寄存器）
//        ROM  32×24×3 + 32×16×2 + 256×16×2 = 11.3 Kbit
//        乘法器 5 组（4 旋转 + 1 加窗），2 平方（仅块尾用）
//==========================================================================
`default_nettype none

// ── 关于综合属性：这里【不要】加 syn_preserve / syn_keep ──────────
//
//  踩坑经过（值得记住，绕了很久）：
//  合并 HDMI 后综合日志里出现
//      WARN (NL0002): The module "spec_cqt" instantiated to "u_spec"
//                     is swept in optimizing
//  也就是整个频谱被删了：DSP 109.5→91.5、Logic 27232→21209。
//
//  加回 syn_preserve 确实能把模块保住，但那是「把优化全关掉」的暴力解法：
//      加 syn_preserve : Logic 27232 / Register 21532 / BSRAM 205 / DSP 109.5
//                        → 布线拥塞，100 MHz 的 u_ld 被挤到 62 处违规
//
//  真正的根因在显示侧 hdmi_spec_top.v —— 一行
//      (bx_raw[11:5] < 5'd32)
//  5 位字面量装不下 32，被截断成 0，判断恒假 → 柱子永远不亮 →
//  bands 无人消费 → 反推把本模块判死。
//  修掉那行之后，不加任何属性就两全其美：
//      不加（修好后）: Logic 22486 / Register 18950 / BSRAM 216 / DSP 109.5
//                      → 0 处 setup 违规、0 处 hold 违规
//  ★ 注意 BSRAM 205→216：去掉 syn_preserve 后综合器自己把 st_re/st_im/st_wp
//    这三个「读+写都在同一个 always 里」的数组推断成了 BSRAM，
//    分布式 RAM 的查表逻辑全部释放出来 —— 这才是它应该有的样子。
//
//  教训：看到 NL0002 "is swept" 不要急着加 syn_preserve，
//        要顺着输出往回找「谁让它变成无用的」，通常是上游某个常量被截断。
module spec_cqt (
    input  wire                clk,
    input  wire                rst_n,
    input  wire                tick,       // 采样节拍（48828.125 Hz）
    input  wire signed [15:0]  sample,     // 音频输入
    output wire [32*8-1:0]     bands,      // 32 段柱高，每段 8 位（0..255）
    output wire                bands_tick  // 一轮 32 段扫完的脉冲（给显示用）
);

    localparam integer NB = 32;

    // ══════════════════════════════════════════════════════════════
    //  常数表（由 tools/gen_spec_cqt.py 生成）
    // ══════════════════════════════════════════════════════════════
    reg  [23:0] AR_TAB  [0:NB-1];      //  cos(2πf/fs)  Q1.23
    reg  [23:0] AI_TAB  [0:NB-1];      // −sin(2πf/fs)  Q1.23
    reg  [23:0] INC_TAB [0:NB-1];      //  2^24 / N_k
    reg  [15:0] L2N_TAB [0:NB-1];      //  log2(N_k)  Q8.8
    reg  [15:0] WIN_TAB [0:255];       //  Hann 窗 Q1.15
    reg  [15:0] LOG_TAB [0:255];       //  log2(1+m/256) Q8.8

    initial begin
        $readmemh("spec_ar.hex",  AR_TAB);
        $readmemh("spec_ai.hex",  AI_TAB);
        $readmemh("spec_inc.hex", INC_TAB);
        $readmemh("spec_l2n.hex", L2N_TAB);
        $readmemh("spec_win.hex", WIN_TAB);
        $readmemh("spec_log.hex", LOG_TAB);
    end
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
