PlanteAmigor/Piano_64/(commit log)

2026-10-24 初始提交：钢琴 64 分量加法合成器（原始交接状态）
    - GW5AST-LV138PG484AC1/I0，50 MHz，fs = 48828.125 Hz
    - 7 键直弹 + 3 模式（演奏/小星星/欢乐颂）
    - 4 声部 × 64 分量，参数表 88 音 × 64 分量
    - 16 级流水线，1024 时钟/样点
    - I2S 输出 PCM5102A，WS2812 按键指示
    本提交为未做任何修改的原始交接版本，后续改动均在其上增量提交。
2026-10-24 引擎升级：128 分量 + 8 级流水线 + 四声部共用参数 ROM
    ## 主要改动
    ### 新增 src/add_voice8.v（替代 add_voice.v）
    - 每分量 8 拍（1024/128），流水线 16 级 -> 8 级
    - 删掉原 s=7/8/9 三级纯打拍空转（模态模型 w≡1，双指数插值退化成直通）
    - 三个乘法（18x10 插值、24x32 衰减、17x16 起音）并行到 s=4，不再串联
    - 参数 ROM 改为端口输入（rd0/rd1/rd2 + rom_addr/rom_req）
    - 声部计数器初值 = G x PH_SHIFT，使各声部 s 相位错开
    ### 新增 src/add_engine8.v（替代 add_engine.v）
    - 4 个声部共用一份参数 ROM（时分复用）
    - 任意时刻至多一个声部处于 s==1，故 ROM 数据直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
2026-10-24 文档更新：修正失效的编译命令、更新指标、给旧分析文档加勘误
    - README：编译命令改为本机实际路径（原 ../../bin/gw_sh 不存在）
    - README：补充参数表重新生成步骤
    - README：更新指标（128 分量、2 套音色表、违例 1 条）
    - README：目录树补全新文件
    - doc/分量数可行性分析.md：顶部加勘误，说明「48 条违例 / 23 ns / 256 不可行」
    三处结论已被实测推翻，并给出修正后的数据表
    原文档正文保留，作为「为什么最初选 64」的历史记录。
2026-10-24 新增 npz2hex_harm.py：笛子/唢呐谐波表 → FPGA hex
    ## 表结构（紧凑变长，按音连续 + 基址表）
    标量区 {K, npsi} / a[K] / b[K] / dm[K] / tau_u[K]
    Phi 区 phi[600] 32 bit 无符号，Q11.21 圈
    Psi 区 psi[npsi][300] 16 bit，Q3.12 圈（±4 圈）
    Env 区 env[K][150] 16 bit，Q0.15
    ## 量化方案的关键结论（都经实测验证）
    1. Phi 必须 32 位绝对值，不能 16 位
    16 bit 只剩 5 bit 小数（1/32 圈 ≈ 0.11 rad），超出公式表要求的 0.2 rad
    2. Phi 不能存「每样点增量 dphi + 累加器」
    试过 32 位 Q0.32 增量方案，SNR 只有 4.21 dB —— cumsum 的累积
    误差直接吃掉相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
2026-10-24 压缩谐波表：Env 改 8 位 + 每谐波归一化，BSRAM 68% → 51%
    ## 为什么只能压 Env
    Gowin BSRAM 只支持 1/2/4/8/16/32/36 位模式。12 位会落进 16 位模式，
    【白降不省块】—— 实测 Env 12 位 SNR 47.24 dB（几乎无损）但块数不变。
    ## 实测各种量化方案（MIDI 67, K=62）
    | 方案 | SNR | 说明 |
    |---|---:|---|
    | 16 bit 基准 | 47.29 | |
    | Env 12 bit | 47.24 | ✗ 不省块 |
    | Env 10 bit | 46.64 | ✗ 不省块 |
    | Env 8 bit 线性 | 41.74 | ✓ 省块但差 |
    | Env 8 bit + 每谐波峰值归一 | **45.23** | ✓ 采用 |
    | Env 8 bit + 每谐波 RMS 归一 | 32.28 | ✗ 更差 |
    | Env 8 bit mu-law (mu=15) | 42.51 | ✗ 不值得 |
    | En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
2026-10-24 谐波表：起振项预乘进 Env，RTL 不再需要实时指数
    ## 改动
    env_tab 生成时按「表点对应的时间」乘以 (1-e^(-t/tau_u_m))，
    并从表里删掉 tau_u_m 字段（每音省 K 个字）。
    ## 为什么可以做
    (1-e^(-t/tau_u)) 只依赖 t 和该谐波的常量 tau_u，而 tau_u 是拟合得到的
    固定参数，完全可以离线算好。这换掉：
    - 每谐波每样点的指数运算
    - K 组起振状态寄存器（62 个 32 位 = 1984 bit BSRAM）
    ## 实测代价（很小，且后期反而更好）
    | MIDI | 原版 | 预乘后 | 8bit 归一后 |
    |---|---:|---:|---:|
    | 67 | 47.29 | 46.89 | 45.52 |
    | 72 | 48.24 | 47.76 | 46.38 |
    | 79 | 44.62 | 43.88 | 42.92 |
    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
2026-10-24 谐波表改存 A/phi 幅度相位形式 + 加 psi_idx 行号表
    ## A/phi 替代 a/b
    a·cos(θ) − b·sin(θ) = A·cos(θ + phi_c)
    A = sqrt(a²+b²) Q3.13（±4.0）
    phi_c = atan2(b,a)/2π 16 bit 有符号（±0.5 圈）
    好处：RTL 只需【一次】正弦查表，不必同时取 cos 和 sin 两张表。
    实测量化无损：平均 SNR 44.35 dB（a/b 形式是 44.38），
    gain 范围 0.9993..1.0008。
    ## psi_idx 行号表
    Psi 表只存非零行（各音 5~20 行，而 K 有 15~62），
    补齐成 K 行会让存储从 3.16 涨到 5.5 Mbit。
    所以加一张 K 字的行号表（0xFFFF = 该谐波无 Psi），RTL 直接查。
    开销 K 字/音，存储 3.155 → 3.168 Mbit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
2026-10-24 新增 add_voice_harm.v：谐波引擎第一版（骨架，待仿真验证）
    ## 状态：WIP，尚未通过仿真，不要加入 build.tcl
    数据层（npz2hex_harm.py + gen_harm_aux.py）已完整验证，
    本文件是配套的 RTL 第一版，语法通过 iverilog，但功能正确性未验证。
    ## 已实现
    - 表头解析（K、npsi）与六个分区偏移计算
    - 前置 5 拍：u 表 2 读 + 插值 -> Φ 表 2 读 + 插值
    - 谐波循环 16 拍/谐波：
    标量 5 读 -> Ψ 2 读 -> Env 2 读 -> 相位合成 -> sin 2 读 -> 乘累加
    - 相位合成 Θ = m·Φ + δ·t + Ψ + phi_a（19 位小数对齐）
    δ·t 用「乘 11264 右移 20」实现（误差 0.04%）
    - A×env_scale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
2026-10-24 add_voice_harm: 修 3 个时序/缩放 bug，状态机已跑通（数值仍不对）
    ## 状态：WIP。状态机通了，但输出数值还不正确
    仿真结果：K=62 读对了，每样点 997 拍（预算 1024），
    但输出前 10 样点为 0（这个是正常的，起振项预乘后 t=0 包络就是 0），
    之后跳到 -32768 饱和。数值链还没调通。
    ## 本轮修掉的 3 个 bug
    ### 1. rom_addr 必须是组合输出（最严重）
    BSRAM 是同步读：地址在 T 拍有效 -> 数据 T+1 拍出来。
    第一版把 rom_addr 写成 output reg，在 s=0 的时钟沿才更新，
    等于地址比数据晚一拍，整条流水线错位，输出全是 x。
    原 add_voice8.v 的 rom_a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
    [add_voice_harm.v, tb_voice_harm.v]
2026-10-24 add_voice_harm: 修 u 表插值（u0==u1 导致 u_acc 卡死）
    ## Bug
    u_addr 一直等于 u_i，所以前置阶段两次读的是【同一个表点】：
    pre=1: u0 <= utab[u_i]
    pre=2: u1 <= utab[u_i] ← 应该是 utab[u_i+1]
    于是 u1-u0 恒为 0，u_acc 卡在第一个表点上，整个时间轴不走。
    症状：acc 从第 16 个样点起完全恒定不变（因为 u 不变 → env 不变 → 每个
    样点的累加结果相同）。
    修法：u_addr 在 pre>=1 时指向 u_i+1。
    修后 u 正常递增：
    OUT#0 u=00000000
    OUT#1 u=00039553
    OUT#2 u=00072aa6
    OUT#16 u=00395535
    OUT#17 u=003ce5cf
    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
    [add_voice_harm.v, tb_voice_harm.v]
2026-10-24 add_voice_harm: 修正 5 处插值为「先乘后移」
    ## 系统性 bug
    所有线性插值都写成了「先移位再乘」：
    u0 + (((u1 - u0) >> 4) * u_fr) ← 错
    psi0 + (((psi1 - psi0) >> 8) * frac) ← 错
    问题：
    1. 差值小于 2^n 时，>>n 直接变 0，插值项恒为 0，精度全丢
    2. 负差值经过算术右移会得到 -1，再乘 frac 变成 -frac，
    把结果往错误方向推（env 值可能被推出 int8 范围）
    正确顺序是先乘后移：
    u0 + (((u1 - u0) * u_fr) >> 4)
    psi0 + (((psi1 - psi0) * frac) >> 8)
    五处全改：u_acc、Phi、psi0、env0、sn0。
    位宽校验（都安全）：
    u : 3.7e6 × 15 = 5.5e7
    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
    [add_voice_harm.v]
2026-10-24 add_voice_harm: 修 6 个 bug，波形与浮点参考对齐（gain 0.997，SNR 37 dB）
    逐谐波与 Python 参考对齐后修掉的问题：
    1. 插值全是无符号运算：part-select 无符号会把整个表达式提升成无符号，
    >> 变逻辑右移，负差值变成 0x00FFFFFF
    → env0 = 16777215，acc 1e11，比期望大 1246 倍
    改成 $signed() + >>>，共 4 处（psi/env/sn/Phi）
    2. Φ 表是 32 位 Q13.19，按两个 16 位块存（前 NT 字低半字、后 NT 字高半字），
    RTL 只读了低半字 → 0.15 圈/表点的增量被截断，相位差 10°+
    实测 Phi=16613 vs 参考 18759；ST_PRE 从 5 拍扩到 8 拍，读 lo/hi × i0/i1
    3. psi_idx = 0xFFFF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
    [add_voice_harm.v, tb_hdbg.v, tb_voice_harm.v]
2026-10-24 add_voice_harm: 乘法流水重排 + Gowin 综合验证（0 违例，slack +4.07 ns）
    ## 重排 ST_HARM：每拍最多一个乘法
    原来 acc += env0*hAS*sn0 是两级大乘法串在一拍里。Gowin 实测关键路径
    38.2 ns（要求 20 ns），必须拆。
    新时序（16 拍，9 拍表读 + 1 拍插值 + 6 拍乘法流水）：
    s=0 Env 基址 （env_a0 改成组合地址，只依赖 m 和 env_pos）
    s=1 Env 基址+1 Env[j0]
    s=2 A[m] Env[j1]
    s=3 phi_a[m] A → hA
    s=4 dm[m] phi_a → hPA（顺手 <<3）
    s=5 env_scale[m] dm → hDM
    s=6 psi_idx[m] env_scale→ hSC
    s=7 Ψ 基址 psi_idx → hPI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
2026-10-25 谐波表 v2：多 bank 打包（为 4 声部全流水准备）+ 修 A 定点削顶
    ## 为什么要重做表
    旧表是【一个 16 位 ROM + 9 次串行读】→ 16 拍/谐波 → 一个样点(1024 拍)
    只放得下 1 个声部。要 4 声部必须让表能【并行读】。
    ## 新表：8 个独立 bank，每谐波每 bank 只读一次
    ab 32bit {A, phi_a} 1 读
    bc 32bit {dm, env_scale} 1 读
    pi 16bit psi_off（已预乘成字偏移）1 读
    psi_e/psi_o 16bit Ψ 奇/偶点 各 1 读
    env_e/env_o 8bit Env 奇/偶点 各 1 读
    phi 32bit Φ（每音） 2 读/样点
    （全局）u 32bit ×16384、sin 32bit ×1024 用现成文件
    三个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
2026-10-25 add_engine_harm: 4 声部全流水谐波引擎（仿真逐点验证通过）
    ## 架构
    参数表拆成 8 个并行 bank（harm_rom.v），一个谐波的所有参数一拍拿全，
    再用 5 级流水线做到 **1 谐波/拍**。
    S0 发地址 S1 Env/Ψ 插值 + hAS S2 相位合成→sin 地址
    S3 pm=env×hAS S4 正弦插值 S5 acc += pm×snf
    一样点调度：ST_PRE（每声部 6 拍前置，不活动声部直接跳过）
    → ST_HARM（按声部顺序逐谐波塞流水线）→ ST_DRAIN（6 拍排空）。
    实测拍数：1 声部 74 拍、4 声部同音 288 拍、4 个不同音 201 拍（预算 1024）。
    ## 验证（全部逐点比对，不是只看 SNR）
    | 场景 | 结果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
2026-10-25 add_engine_harm: 时序收敛（0~2 条 -0.07 ns 边缘），BSRAM 264/340
    ## 综合结果（Gowin GW5AST-138C，50 MHz）
    Logic 2118/138240 (2%)
    Register 744/139095 (<1%)
    CLS 1571/69120 (3%)
    BSRAM 264/340 (78%) ← 8 个表 bank + 混音器
    Setup/Hold 50 条路径，负 slack 0~2 条，最差 -0.074 ns
    ## 为收敛做的三处改动
    1. **dmt = δ·t 提到 S1**：原来是 `dm×11×t_smp` 两级乘法串在相位合成前，
    关键路径 25.3 ns。改成 `t_smp×11` 用常量移位加法（11=8+2+1），
    和 16 位 dm 只乘一次，结果寄存进 r1，S2 只剩加法和一个 6 位乘法。
    2. **psi_off 预取链改成位向量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
2026-10-25 doc: 新增谐波引擎进度交接文档
2026-10-25 doc: 时序报告归档 + 交接文档补充「解决了什么」章节
    - 新增 doc/时序报告/：钢琴整机与谐波引擎两份原始 timing_paths/rpt + 摘要 README
    - 谐波引擎进度交接.md 新增「一点五、解决了什么」：逐条对比队友原始判断与实测
    * 256 分量放不下 → 不成立（4 声部共享表，128 分量 BSRAM 34%）
    * 48 条 setup 违例 → 实测 1 条（I2S 输出约束过紧）
    * 分量越多越慢 → 反了（16 级流水使路径 15.1→9.3 ns）
    * 笛子 256 分量是误会，K 由奈奎斯特决定（15~62 / 11~55）
    * Q3.13 定标削顶 9 个音 → 改 Q4.11
    - 外设 12 个文件零改动清单
2026-10-25 doc: 修正交接文档措辞（资源判断不成立 vs 吞吐问题已解决，分开表述）
2026-10-25 时序清零：修跨时钟域 hold 违例 + 输出约束过紧
    原来 1 条 setup（-0.085 ns）+ 22 条 hold（-0.726 ns），现在 0 / 0。
    1) 22 条 hold —— ws2812_keyind 用 CLOCK_50 直连（该脚是 EMCCLK，
    走普通布线，偏斜约 3 ns），但 mode/key_state/guide_key/engine_rst_n
    全在 clk_sys 域。两条时钟树 PBR1/2 与 PBR2/3 偏斜 0.7 ns，
    数据跑赢捕获时钟。
    → add_top.v 加两拍同步器（+30 FF），piano64.sdc 声明
    set_false_path -from [get_clocks {CLK_SYS}] -to [get_clocks {CLOCK_50}]
    → u_led 仍是 CLOCK_50 直连，WS2812 协议时序不变
    2) 1 条 setup —— set_output_delay -max 10.000 把 20 ns 周期的一半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
2026-10-25 修 add_voice8 回写晚一个分量的 bug（128 分量钢琴引擎出噪声）
    症状：add_engine8(NPART=128) 触发任意音输出满幅乱跳的噪声，峰值削顶。
    根因：s==7 一级里 e1n/ern 用非阻塞赋值产生，同一拍又被 st_w1/st_wr 采样，
    回写晚一个分量 → 每播一个样点幅度在槽位间轮转 +1 → 噪声。
    旧 16 级 add_voice.v 是 s=14 算 e1n、s=15 才写 st_w1，所以没这问题；
    压成 8 级流水时并进同一级才引入。
    修复：直接用当拍组合值 st_w1 <= e1_q - dec1 / st_wr <= er_q + dcdr，删掉 e1n/ern。
    验证（新增 sim/tb_engine8_chk.v 监听每次状态 RAM 写）：
    播放 1 样点后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
    [add_voice8.v, tb_ab8.v, tb_engine8.v, tb_engine8_chk.v]
2026-10-25 修 add_voice8 正弦取数晚一个分量 + 重算 sat_gain 到 ×8
    BUG-2：正弦表是同步读（地址打一拍、数据下一拍），但 s==2 就采 sw_r，
    拿到的是上一个分量的 laddr 对应的值 → 每个分量都在用邻居的频率。
    实测 note60 p=0：laddr=960（应为 sin337.5°=-12541），
    sw_r 低16位却是 27245 = sin56.25° = 索引 160（正是 p=127 的地址）。
    修复：s==3 直接用 LUT 当拍输出 sw_raw，删掉 sw_r（-128 FF）。
    验证（浮点理想模型对拍）：
    相关系数 0.13 → 0.9947，最佳对齐 off=0，拟合增益 0.482≈1/2（正是 MIX_SHIFT=1）
    峰值 11459（虚高） → 655（模型预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
    [add_top.v, add_voice8.v]
2026-10-25 gitignore: 忽略仿真输出 out_*.txt
2026-10-31 SD→DDR3 加载链打通 + 引擎参数源改为 DDR（阶段 3）
    一、DDR3 硬件通路
    - 合并 DDR 管脚约束进 piano64.cst（gw_sh 只读最后一个 .cst）
    - PLL 定位于 PLL_L[0]，解决 init_calib_complete 恒 0
    - SDC 增加 clk400/sysclk 时钟组与跨域 false_path
    二、SD 卡 FAT32 → DDR3 加载器（sd_ddr_loader.v）
    - 双时钟域：SD/FAT 栈 50 MHz（100 MHz 下组合乘法 −6.2 ns 违例）
    拼字/写 DDR/读回校验 100 MHz，中间 sd_async_fifo 跨域
    - 关键修复：
    * app_addr 单位是 32 位 DRAM 字（4 B），256 位一拍需 +8
    而非 +1（ADDR_SHIFT=3），此前整幅镜像错位、校验和全错
    * 写队列用 2 深 q0/q1，地址在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
    [add_engine8.v, add_top.v, ddr_param_dma.v, ddr_selftest.v, ddr_wrap.v, gowin_pll.v, gowin_pll_mod.v]
2026-10-31 引擎降爆音 + 双键位扫描 + 力度
    一、add_voice8：消除起音/抢占爆音
    - 架构：每声部独占参数 cache，rom_addr 直接就是分量号 p，
    不再拼 {note_off, p} 全局地址，也不再需要 rom_req 多路仲裁，
    各声部同相位读互不抢口（PH_SHIFT 约束消失）
    - 正在响的声部收到 note-on → 先进 fading，1.7 ms 淡到 0 再装载，
    保证 sample 在任何时刻连续（快速连弹/猛击不再爆音）
    - 装载完成后的前 256 个样点做线性淡入（5.24 ms），
    消除 st_w1 硬跳满幅造成的幅度阶跃（实测"10 出 1"）
    - 新增 vel_gain，按双触点 Δt 给力度增益
    二、key_scan / key_dual：从单触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
2026-10-31 新增整链仿真 + 修正镜像格式文档（定位 SD 卡旧文件事故）
    一、根因：SD 卡上的 P64.BIN 是 v1 旧镜像
    - 卡上 210464 B / 6577 word（v1 平面布局，每音 48 字）
    - RTL 按 v2 交错布局读，每音 64 字、古筝基址 5633
    - 症状：钢琴音高音色全乱（步进 64 vs 48，读到别的音）、古筝没声
    （从 word 5633 起读，而旧镜像 6577 就结束了）
    - 串口特征：HT=000019B1(6577)。正确应为 00002241(8769)。
    换卡后：BY=00044820 W=00002241 R=00002241 HT=00002241 OK=1
    - RTL 本身无问题，仿真已验证
    二、sim/tb_engine_ddr.v（新增）
    - 整链验证：add_engine8 在 USE_DDR=1 下装进 param_cache 的 12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
    [tb_engine_ddr.v]
2026-10-31 移调（第9键）+ 每乐器独立按键映射 + 唢呐镜像段
    一、移调（add_top）
    - 第 9 键是纯功能键，不映射音符
    - 轻击第 9 键 → 整体 +1 八度；重击 → -1 八度
    - 方向直接复用 key_dual 已有的力度 kd_vel[71:64]：
    轻击走 FALLBACK → vel=48；重击 → vel_from(Δt) 高段
    以 128 为界（正是 vel_from 里 Δt≈15 ms 的位置），不新增任何门限
    - 到音域边界停住、不循环；切换音色清零回 0
    - 曾实现成「按住第9键+第1键」，实操要跨整个键盘、太难受，改为单键
    二、每乐器独立按键映射（note_alloc + add_top）
    - NOTE_BASE / KEY_STEP 从参数改为输入端口，add_top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
2026-10-31 唢呐取表验证通过：修镜像对齐 + 描述符字段顺序
    一、两个真 bug（仿真抓到，都是我自己写的）
    1. 段起始没有 32 字节对齐
    ab 表内偏移是 ab_base*4 字节，任意值 → RTL 一次读 256 位会整体错位。
    实测 ab[0..2] 是 0、真实数据从 ab[3] 才开始（右移 3 个元素）。
    修法：镜像里【每音每段】单独 32 B 对齐。代价 28 音×8 段×≤31 B ≈ 7 KB。
    2. 描述符字段顺序与 RTL 不一致
    Python 按 8+4 写（word0 有 8 个字段），RTL 按 7+5 读
    → pe/po/plen/phi/flen 全部错位，phi 段长度读成 0 被跳过。
    修法：统一成 word0 = 7 个字段、word1 = 5 个字段。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
    [tb_suona_dma.v]
2026-10-31 唢呐引擎接入顶层：按音取表 + 单声部 + 力度，0 时序违例
    一、harm_buf.v（新增）—— 唢呐表的工作缓冲
    - ab/bc/pi/env_e/env_o/psi_e/psi_o/phi 八个表改成按音预取缓冲
    写口在 clk_x1(100M)、读口在 clk(50M) → 双时钟 SDP BSRAM，
    写法与 param_cache 一致
    - u / sn / info 三个表仍常驻（每样点都要查，不能走 DDR）
    - 深度按最大单音留：ab/bc/pi 64、env 8192、psi 4096、phi 1024
    二、add_engine_harm.v —— 从 ROM 改成按音缓冲
    - 例化 harm_buf + suona_dma，加 clk100/app_* 端口
    - 按音预取后 4 个 base（v_ab/v_eb/v_pb/v_fb）全部置 0，
    地址直接用段内相对偏移 → 其余寻址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
2026-10-31 唢呐修完 5 个 bug：Φ索引位宽截断/结尾衰减/第8键gate力度/sat_gain增益/时序违例
    BUG-S1 Phi 表索引位宽截断 —— 唢呐最后 15% 变嘟嘟声
    add_engine_harm.v: cur_up[40:32] -> cur_up[41:32]
    cur_up = u*599 需要 10 位，只取 9 位，u=0.85476 时 511->0 回绕
    对应 t=109296 样点=2.2385s，与实测崩点 2.2378~2.2398s 吻合
    修复后 2.281s 包络 130->1968，全程音高 493.21Hz 恒定
    BUG-S2 结尾衰减跑在 50MHz + 卡在 ±15
    加 cnt==0 门控（按样点而非按拍），>>>4 改 >>>6，绝对值<=32 清零
    修复后结尾精确归零，无残留直流（原为恒定 15），10ms 平滑收尾
    BUG-S3 第 8 键松键不停 + 力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
    [add_engine_harm.v, add_top.v, suona_dma.v, tb_harm_hw.v]
2026-10-31 接入笛子（第 4 种音色）：谐波引擎单实例共享 + 逐音峰值归一化
    音色循环：白(钢琴) → 青(古筝) → 橙(唢呐) → 紫(笛子) → 白
    ★ 架构：笛子与唢呐共用同一个 add_engine_harm 实例
    切音色只改 4 个运行时端口：
    note_lo/hi 唢呐 69/96 笛子 67/91
    inf_base info 字偏移 0 / 112
    desc_base ((BASE+2)<<3) - note_lo*16
    省约 50 块 BSRAM（实测 201 -> 202，只多 1 块）和一条 DDR 仲裁
    ★ BUG-D1 笛子音量过大 + 音质发糊（已修）
    根因：笛子表没做峰值归一化。用 npz 的 xh（峰值 1.0 = 引擎满刻度）统计：
    唢呐 峰值中位 1.001 / 最大 1.151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
    [add_engine_harm.v, add_top.v, harm_buf.v, suona_dma.v, tb_harm_hw.v, ws2812_keyind.v]
2026-10-31 HDMI 输出打通（1280x720@60）：复用 ir4 验证过的 DVI 栈
    新增 src/hdmi/ir4/（从队友跑通的 ir4 工程复制，未改动）：
    dvi_tx_tmds_enc.v dvi_tx_tmds_phy.v dvi_tx_clk_drv.v
    dvi_tx_top.v gowin_pll_720p.v（原 gowin_pll.v，仅改模块名）
    新增 src/hdmi/hdmi_test_top.v 彩条测试图案 + 720p 时序
    新增 build_hdmi.tcl / hdmi_test.cst / hdmi_test.sdc（独立工程，不影响乐器）
    ★★★ 三个致命坑（自己写的时候全踩了）：
    1. TMDS 时钟通道不能过 OSER10！
    原来用 OSER10 + 图案 1111100000 → 每 10 位一周期 → 12.5 MHz（少一半）
    → 任何屏都黑屏。正确做法：像素时钟直接送 ELVDS_OBU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
2026-11-01 HDMI UI 骨架：1280x720 测试页 + 字体/DDS/李萨如模块
    - hdmi_ui_top.v：独立 HDMI 测试页顶层（603 行），复用已验证的 DVI 栈
    - ui/ui_dds.v：测试页正弦发生器
    - ui/ui_liss_ram.v / ui/ui_wave_ram.v：李萨如与波形显示用 BSRAM
    - ui/ui_font_asc.hex / ui_font_cn.hex / ui_sine.hex：字模与正弦表
    - tools/gen_ui_font.py：字模生成
    - tools/ui_render_ref.py、tools/ui_preview.py：CPU 侧渲染参考与预览
    - build_hdmi.tcl / hdmi_test.cst：HDMI 工程构建与引脚
2026-11-01 KEY0 测试模式 + 32 段常数-Q 频谱 + suona_dma 时序修复
    ## 测试模式（KEY0 / AA13）
    按下板载 KEY.0 切到测试信号源：8 路纯正弦，频率取 32 段频谱里
    段 2/6/10/14/18/22/26/30 的中心，力度 255→150 阶梯递减（总差 4.6 dB），
    既是听感自检也是频谱自检。
    - src/test_sine8.v：8 路时分复用 DDS + 正弦表插值
    * 插值乘法必须用 27 位中间值，否则 (hi-lo)*frac 溢出 16 位
    * 正弦表是同步读，需 S_LATCH2 等一拍再取数，否则第 k 路拿到第 k-1 路波形
    - src/add_top.v / src/piano64.cst：KEY0 去抖 20 ms + 模式切换
    ## 32 段常数-Q 频谱（替代 FFT）
    FFT 无法在「40 Hz~16 kHz 全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
    [add_top.v, spec_cqt.v, suona_dma.v, test_sine8.v]
2026-11-01 HDMI 32 段频谱：合并顶层 + 修复导致频谱被综合器删除的截断 bug
    ## 合并顶层（音频 + HDMI 单比特流）
    原来钢琴工程和 HDMI 工程是两个独立码流，一次只能烧一个。新增：
    - src/piano64_top.v 合并顶层：u_audio(add_top) + u_hdmi(hdmi_spec_top)
    - src/hdmi/hdmi_spec_top.v 1280x720 的 32 根柱子渲染器
    - src/piano64_hdmi.cst 拼接约束 = piano64.cst + TMDS 四对差分
    （INS_LOC 的层级路径加 u_audio/ 前缀）
    - src/piano64_hdmi.sdc 拼接约束 + clk_pix(75M)/clk_ser(375M) 时钟域
    - build_full.tcl 合并工程构建脚本
    - src/add_top.v 新增 SPEC_BANDS/SPEC_TICK 输出端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
    [add_top.v, piano64_top.v, sd_ddr_loader.v, spec_cqt.v, suona_dma.v]
2026-11-01 Step2: 删除 J14 六键/两首曲谱/指导模式/旧渲染器
    - add_top: 移除 KEY[6:0] 端口、u_keys 扫描、g_twinkle/g_ode 曲谱表、
    guide_* 指导逻辑、note2key、MD_TWIN/MD_ODE 模式 FSM、长按 lp_cnt/lp_fired
    - 音色键改为 KEY_AUX[0] 短按循环（长按切音色已废弃）
    - piano64_top / piano64.cst / piano64_hdmi.cst 同步删除 7 个引脚约束
    - sdc 删除 set_false_path KEY[*]（端口已不存在，会报 TA2003）
    - 删除文件: hdmi_ui_top.v build_hdmi.tcl ui_dds.v ui_wave_ram.v ui_sine.hex
    - 保留 ui_liss_ram.v / 两个字库供 Step3 使用
    - build_full.tcl: place_option 2 / route_option 2
    - 结果: Logic 22489(17%) BSRAM 216(64%) DSP 109.5(37%) 0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
2026-11-01 Step3: 三模式状态机 + 三页面渲染器 + 淡入淡出
    add_top
    - ui_mode[1:0] 三模式 FSM：KEY0 循环 主页面(0)→测试(1)→教学(2)
    - fx_r[1:0] 效果器档位：U37 短按循环 NONE/REVERB/DELAY/CHORUS
    - 新增 UI_INFO[15:0] = {transpose, fx, timbre, ui_mode} 给渲染器
    hdmi_ui3_top.v（新，替代 hdmi_spec_top）
    - 三级流水；统一 16px/8px 字符网格，全屏共用一个字模 ROM
    - 字符串用 32 字符定宽常量 + a2i() 转 ROM 索引
    - page0 主页面：状态栏 + 频谱框 + 分量框 + 李萨如框 + 信息框（音色/效果器/移调实时）
    - page1 测试页：满幅 32 段频谱
    - page2 教学页：8 条轨道 + 判定线 + PENDING
    - 24 ms 淡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
2026-11-01 fix: 文字行号位宽不足导致重复 + UI_INFO 拼接错位
    1. hdmi_ui3_top: tln 从 cy[8:4] 改成 cy[9:4]
    cy[8:4] 只有 5 位（最大 31），py>519 后行号回绕，
    第 0/4 行（PIANO64 MAIN / SPECTRUM 32 / LISSAJOUS）被重复画到下方。
    2. add_top: UI_INFO 拼接补成 16 位
    原来 {transpose, fx_r, timbre_r, ui_mode} 只有 14 位，
    赋给 16 位端口时左补 2 个 0，所有字段整体错位 2 位：
    音色显示成 FX 值、FX 显示成音色、移调只剩 transpose[7:2]。
    3. hdmi_ui3_top: page1 柱高系数 2h+h/2+h/2(3 倍) 改成 2h+h/2(2.5 倍)
    4. 新增 tb_ui3.v 离线出图：-DSIM_UI3 绕过 PLL/DVI，
    直接导出 1280x720 PPM，跳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
    [add_top.v, hdmi_ui3_top.v, tb_ui3.v]
2026-11-01 fix: 720p 帧率从 60.6Hz 修正到标准 59.988Hz
    PLL 出的是 75.000 MHz，但 H_TOTAL=1650 是按 74.25 MHz 算的，
    导致实际行频 45.455 kHz / 帧率 60.606 Hz，比 CEA-861 快 1.01%。
    大屏容差大能认，挑剔的屏会丢锁。
    - H_TOTAL 1650 -> 1667
    - 同步位置改成 CEA-861 顺序：FP 110 | SYNC 40 | BP 237
    V: FP 5 | SYNC 5 | BP 20
    - 结果：行频 44.991 kHz，帧率 59.988 Hz
    注：小屏实测仍不显示（有 TMDS 但不出图），独立 hdmi_test.fs 码流同样不行，
    同一小屏接电脑正常 → 判定为该小屏与本板 720p TMDS 电平不兼容，
    不作进一步排查，统一改用大屏。
    [hdmi_ui3_top.v]
2026-11-01 Step4a: COMPONENT 64 分量高度柱图 + 坐标轴刻度
    数据通路
    - add_voice8: 新增 part_idx/part_amp/part_vld，在 s==6 采 amp_er[15:8]
    （与 pr = sv*amp_er 同一个值，含包络衰减 + 力度）
    - add_engine8: last_v 记住最近一次 note-on 的声部，只输出那一个
    （8 个声部全叠加会把 64 根柱糊成一片）
    - add_top: 128 个分量两两合并取大值 -> 64 根；静音后保留最后一帧，
    松键后图还停在那里便于观察
    渲染
    - hdmi_ui3_top: 新增 512 位 COMP_AMP 输入 + 柱状图 + 坐标轴
    * 64 根青色柱（与绿色频谱区分），x0=64 pitch=16 w=11
    * Y 轴竖线 + 刻度 192/128/64 + 三条网格线
    （网格线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
2026-11-01 COMPONENT 64: 支持唢呐/笛子 + 峰值保持 + 0.5s 回落
    1. add_engine_harm 新增监控口（纯追加，原流水线一行未改）
    - r2_m/r3_m/r4_m 谐波号延迟链（原来只到 S1）
    - part_idx/part_amp/part_vld 在 pv4 有效时输出
    - part_amp = r4_pm[18:11]（pm 满量程约 127×4096 = 2^19）
    2. add_top 按 is_harm 二选一（与音源 mux 同一根信号）
    修复：切唢呐/笛子时 comp_bar 冻结在旧钢琴数据上
    3. 显示策略（原版瞬时值+冻结，会闪一下就没了）
    - note-on 立即清空 64 根柱重画（扫完 128 分量仅 20.5us，视觉瞬间）
    - 峰值保持：新值>当前值即刻上升，0 延迟
    - 回落：每 94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
    [add_engine_harm.v, add_top.v]
2026-11-01 Step4b: 灯带重写 + U38 长按切效果器 + U37 切三模式
    灯带（ws2812_keyind.v 整体重写）
    - 1~6 颗坏灯常黑；7 乐器色；8~10 = FX1/2/3；11 = FX4 预留
    - 12 = 键9 移调（重按闪红 -12 / 轻按闪蓝 +12，300 ms）
    - 13~20 = 键8..键1，8 色琴键配色
    - 按键亮度 ∝ 力度：取高 2 位右移 0/1/2/3（省乘法器）
    - 保留 WS2812 位时序与输出打拍寄存
    键位调整
    - U37 已修好 -> 三模式切换移到 U37 短按（板载 KEY0 保留等效）
    - U38 短按 = 音色，U38 长按 1s = 效果器
    修复：长按后又触发短按
    - 根因在 key_scan.v：key_release <= ~key_state & key_d 两者都是寄存器，
    比 key_state 下降沿晚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
    [add_top.v, sd_ddr_loader.v, ws2812_keyind.v]
2026-11-01 主页面李萨如（相位图）
    - add_top 新增 SCOPE_SMP/SCOPE_TOG 取样口（每样点锁 out_l_r + 翻转标志）
    - hdmi_ui3_top: SCOPE_TOG 打两拍检翻转沿产生 plot；Δ=24 样点延迟线
    - 复用 ui_liss_ram.v（256x256 位图，4096x16 字）
    - 增益 27/16 + 限幅 ±104，显示取位图中心 212 px
    - 每 3 帧清一次位图（~20Hz 余辉），点宽 2 px
    注：不能用 L/R 做 XY —— mix_sum 是单声道，左右完全相同，会画成一条直线
    结果: Logic 25782(19%) Register 20452(15%) BSRAM 224(66%) DSP 111.5(38%)
    0 setup 0 hold OK=1 上板验证通过
2026-11-01 李萨如清晰度：Bresenham 连线 + AGC + 单次捕获
    一、ui_liss_ram: 相邻样点之间用 Bresenham 连线
    原来每样点只写 1 个像素，高音区相邻两点能差十几个像素，
    看起来是一堆散点。现在逐像素连线（每像素 3 拍读-改-写，
    两样点之间有 1536 拍，够画 500 px）。
    待画点用 1 深度缓冲，段未画完时新点挂起，画完接着画。
    清零后首个点是孤立点（pen_vld 标志），不会从 (0,0) 拉一条线。
    二、hdmi_ui3_top: AGC 峰值跟随
    这是钢琴/古筝"模糊"的真正原因 —— 不是分辨率不够，而是
    余辉窗口内幅度衰减导致椭圆半径不断收缩，画成一串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
2026-11-01 李萨如改用数字荧光屏（4bit 强度）+ 取消冻结 + 按键重映射
    一、ui_liss_ram: 1bit 位图 -> 4bit 强度帧存（256x256）
    - 打点 = 该像素强度 +1（饱和到 15），每帧整屏 -1（饱和到 0）
    - 停留时间自动变成亮度：稳定轨迹每周期扫一遍 -> 满亮；
    瞬态垃圾（限幅跳变、起始杂散）只扫一次 -> 1 级亮度，很暗
    - 衰减 3 拍/字 x 16384 = 49152 拍 = 655us，在场消隐 4.4ms 内完成
    - 段长上限 24px：超过就断笔只画孤立点，杜绝扇形长直线
    - 存储结构：A 口只读（显示），B 口独立 b_ra/b_wa 读改写
    二、hdmi_ui3_top
    - 取消「捕获 200ms 后冻结」，改回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
2026-11-01 李萨如：直流阻断 + 段长上限放宽 + 余辉 4 档可切换
    一、直流阻断高通（修笛子图形沿对角线漂移）
    相图 x=s[n]、y=s[n-Δ]，信号带缓慢直流 D 时两个轴【同时】偏移 D，
    图形就沿 x=y 对角线平移，余辉又把沿途位置叠起来 →"一坨"。
    一阶差分式 y[n] = x[n] - x[n-1] + y[n-1]·(1 - 2^-9)，截止 ≈15 Hz。
    x/y 用同一个滤波器，椭圆形状不变，最低音 262 Hz 不受影响。
    二、段长上限 24 → 64 px（修钢琴/古筝太小太暗）
    钢琴有 128 个分量、波形起伏快，相邻样点经常跳 >24 px，
    24 的上限会把大量线砍成孤立点 → 曲线不清晰 + 打上次数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
2026-11-01 李萨如亮度模型改为「最近性」——参考 rschlaikjer/lissajous 与 petopagi/scope
    一、根因（读了两个参考工程的实现才看清）
    参考工程的亮度是「年龄」：rschlaikjer 每帧把最近 50 ms 的点全部重画，
    alpha = (age/window)^2，越新越亮，【完全没有累积】。
    我们原来是「驻留性」：像素每被扫过 +1，逐帧 -1。
    于是图形缓慢旋转时，转折点附近停留久 → 疯狂累积成亮区，
    其他位置每次只 +1 → 始终暗。
    用户看到的"右下的边亮、其他地方隐隐约约"就是这个造成的，
    和分辨率、滤波器都无关。
    二、改动
    打点从「+1 累积」改成「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
2026-11-02 李萨如：余辉档位范围拉大 + 新增显示低通（KEY_R2[1]）
    一、余辉档位（KEY_R2[0]）
    之前 L3→L4 只从 62→36 ms，「没看出区别」。改成：
    L1 衰减1 → 250 ms
    L2 衰减3 → 83 ms
    L3 衰减7 → 36 ms
    L4 衰减15 → 17 ms（≈每帧清空，旋转来不及叠加）
    decay_step 位宽从 3 位加宽到 4 位。
    ★ 为什么钢琴/古筝必须短：它们的 128 个模态频率是实测拟合值、
    不是精确谐波 → 波形准周期 → 相图缓慢旋转。余辉一长就把十几个
    转角度的副本叠成一条宽带，看起来"线条很粗"。
    唢呐谐波严格整数倍 → 图固定不动 → 余辉再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
2026-11-02 李萨如：显示带限改为随音高自适应（修「线条藏在一坨橙色里」）
    一、根因（离线仿真定位，不是猜的）
    tools/liss_check.py + 直接解析 add_param*.hex：
    基频模态比最强模态低 30~60 dB，能量全堆在中高次谐波上
    C2(65Hz) 最强模态在 31×f0，<2f0 只占 2%
    C3(131Hz) 最强模态在 2.97×f0
    C4(262Hz) 最强模态在 6.00×f0
    C5(523Hz) 最强模态在 0.99×f0 ← 所以高音看着清楚
    而且每个音都有 3~4 个几乎同频的「假模态」
    C4: 1571/1575/1576 Hz（以 4~6 Hz 互相拍频）
    C3: 387/389/393 Hz
    → (x,y)=(s[n],s[n-24]) 画出的是高次谐波的密集李萨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
2026-11-02 回退显示带限改动（c5179a8），回到 24c217e 作为效果器开发基线
    c5179a8 的显示带限（UI_INFO 21 位 + disp_k 8 拍扫描）上板后出现
    按键异常（音色切换连跳、笛子自响、爆音回来），已定位为回归。
    按要求先不动它，源码回退到 24c217e。
    c5179a8 的改动和离线分析工具（tools/liss_check.py、tools/liss_harm.py）
    仍保留在历史里，需要时 git cherry-pick / checkout 取回。
    结论记录在 /memories/repo/lissajous-blob.md。
2026-11-02 效果器：三种效果（REVERB/DELAY/CHORUS）的立体声 Python 参考仿真
    目的：先用 CPU 把参数定死、听感确认，再照这个写 RTL。
    素材：out/piano/B_模态_<音名>K512_3s.wav
    正好是 fs=48828 Hz（= FPGA 的 50MHz/16/64）、16bit、单声道，
    就是模态表合成的音色，和 FPGA 输出一致。
    每个音只取 1 s 并 50 ms 淡出 —— 原素材 3 s，照搬的话效果器
    尾巴会被干声完全盖住，听不出区别。
    输出：out/fx/fx_{dry,reverb,delay,chorus}.wav（立体声）
    一、混响（Freeverb 结构）
    梳状 1236 1315 1414 1502 1574 1651 1724 1790
    全通 616 488 378 249
    ★ 原版是 44.1 kHz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
2026-11-02 DDR 仲裁器：4 路轮询仲裁 + 事务级保持（仿真验证通过，暂未接入构建）
    为什么需要
    ----------
    原设计是 ld_done 裸二选一（加载器/参数表/谐波表），三者在时间上天然互斥。
    加效果器后变成 4 个客户，其中效果器是持续型客户，必须显式仲裁，否则：
    · 两路同时发命令 → 地址/命令错乱
    · 写数据通道被两路同时驱动 → 写坏参数表（钢琴音色崩）
    事务定义（依据 Gowin DDR3 IP 实际时序，已核对现有 RTL）
    ------------------------------------------------------
    读：app_en & app_rdy 握手 + 等 app_rd_data_valid 到来
    现有设计全局只有 1 个 ou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
2026-11-02 DDR 仲裁器接入 add_top：加载器保持直连，引擎/谐波走仲裁器（上板验证通过）
    接入策略
    --------
    没有把四路全部塞进仲裁器，而是分两段：
    wire ddr_sel_arb = ld_done && !ld_app_en && !ld_app_wdf_wren;
    assign ddr_app_* = ddr_sel_arb ? arb_app_* : ld_app_*;
    · !ld_done —— 加载器独占直连，与改动前逐字节等价（零回归风险）
    · ld_done —— 引擎 / 谐波 / 效果器 三路走仲裁器
    原因：sd_ddr_loader.v:385 是「app_en 在 app_rdy 为高的那一拍才拉高」的
    脉冲式风格（assign app_en = cmd_valid && app_rdy），和仲裁器要求的
    「保持请求直到 ack」不兼容。硬接必须改加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
2026-11-02 修唢呐/笛子无声：suona_dma 的 app_en 是 1 拍脉冲，需要排队器（上板验证通过）
    现象
    ----
    接入仲裁器（fb809c2）后，钢琴/古筝正常，唢呐/笛子完全静音。
    根因
    ----
    suona_dma.v 的 app_en 不是保持请求，是 1 拍脉冲：
    S_DESC / S_CMD: if (app_rdy) begin en_r <= 1'b1; st <= ...; end
    （en_r 每拍默认清零，只在看到 app_rdy 的下一拍置 1）
    而它拿到的 app_rdy 被 grant 过滤了：
    仲裁器要先有 req 才给 grant，suona 要先看到 app_rdy 才发 req
    → 死锁，grant 永远为 0。
    suona_dma 自己还有 TMO_MAX=4000 的超时保护，撞上就跳过本段，
    所以不是卡死，而是每一段都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
2026-11-02 CHORUS 上板跑通：LFO 改用已验证的 add_sine_lut ROM
    历经 5 次上板迭代才收敛，关键教训：
    1. LFO 正弦查表必须插值（否则延迟每 6.5ms 跳 4.19 样本 = 152Hz 滋滋）
    2. 每拍最多 1 个乘法（时序报告实测最差路径在 fx_chorus 内）
    3. 软限幅 d*d 乘法换成无乘法硬钳位
    4. 自制「65 项 case 嵌套函数 + 从 wire 调用」的正弦在 Gowin 上不可靠，
    改用 add_engine8 一直在用的 add_sine_lut（1024 点 BSRAM ROM）
    5. add_sine_lut 是两拍延迟：地址 X 拍设、数据 X+2 才有效；
    按一拍取会把左右声道正弦搞反，且 L/R 插值系数必须分开存
    已知未解决：笛子/唢呐松键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
2026-11-02 构建脚本加入 fx_chorus.v（漏提交）
2026-11-02 DELAY 效果器：乒乓延迟（335.5ms / 250ms），仿真 bit-exact 后上板
    算法沿用 tools/fx_sim.py 的 delay()：左右不同延迟、读写同址、
    交叉反馈（左的回声喂右）→ 乒乓感。湿/干 = 1.10。
    - src/fx/fx_delay.v 两条 16384 深 BSRAM 延迟线，共 32 块
    左 16384 样本(335.5ms) 自然回绕；右 12207 样本(250ms) 计数回绕
    读写同址的「先读后写」靠周期分离实现，不依赖 read-first 语义
    - tb_fx_delay.v + tools/fx_delay_check.py 40000 样点 bit-exact
    参考值 375ms 降为 335.5ms：16384 = 2^14 省 16 块 BSRAM，听感差异很小。
    （375ms 需 18310 样本 → 32768 深，48 块）
    上板数据：BSRAM 253→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
2026-11-02 延音（sustain）：松键后按每个音自己的自然衰减率继续响
    之前松键只用固定 R_REL=0.30s（= 制音器落下），所以听起来"松手就停"。
    真钢琴踩延音踏板时制音器抬起，弦按【自己的自然衰减规律】继续振动 ——
    低音弦长衰减慢、高音快，这在参数表里本来就是每个音的 R1_r。
    - add_voice8.v: 加 sustain 端口
    R1_eff = (rel && !sustain) ? R_REL : R1_r;
    即：踩踏板 = 松键后继续用 R1_r；不踩 = 原来的 0.30s 快收。
    - add_engine8.v / add_top.v: 传递 sustain，钢琴/古筝接 1'b1（常开）。
    唢呐/笛子是吹奏乐器，走 add_engine_harm.v，松口就断气，不受影响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
2026-11-02 DELAY 与 SUSTAIN 改为两个独立效果器（5 档，可叠加）
    原来 SUSTAIN 接常量 1'b1（等于焊死在音源上，不可关），DELAY 只占 4 档循环
    里的一个位置，两者不是同一层级的东西，用起来别扭。
    现在长按音色键循环 5 档，默认 NONE：
    0 = NONE 干声
    1 = DELAY 乒乓延迟
    2 = SUSTAIN 延音（改音源包络，松键后按自然衰减率继续响）
    3 = DELAY+SUSTAIN 叠加
    4 = CHORUS 合唱
    两者能叠加是因为作用层级不同：
    音源层： add_voice8 包络 ← SUSTAIN 改 R1_eff
    后级： delay / chorus ← DELAY / CHORUS 改输出
    所以 DELAY+SUSTA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
2026-11-02 延音覆盖全部 4 个音色（唢呐/笛子 + 古筝）
    之前 sustain 只接到 add_engine8（钢琴/古筝），唢呐/笛子走 add_engine_harm
    仍是松键硬停；古筝虽接了但因 R1_r 本身衰减快，听不出区别。
    1) add_engine_harm.v —— 唢呐/笛子
    原本松键 v_act<=0，引擎立刻停。但引擎一停 smp 就停在最后样点电平上
    （直流），衰减它只会得到"噗"然后静音，不是声音延续。
    所以必须让引擎继续跑、只降音量。smp 合成里刚好有 v_vel 乘法：
    smp <= quiet ? 0 : sat16((mix * v_vel) >>> 8);
    直接顶掉 v_vel：
    wire [7:0] vel_eff = sus_rel ? rel_gain : v_vel[7:0];
    ★ 零额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
2026-11-02 效果器改回 4 档；修复延音卡住不停音（v_ts 被反复清零）
    1) 去掉 DELAY+SUSTAIN 叠加档
    现在：0=NONE 1=DELAY 2=SUSTAIN 3=CHORUS（长按音色键循环）
    DELAY 与 SUSTAIN 互斥。HDMI 删掉 S_DLYSUS，LED 改 4 种颜色。
    2) ★ 修复：连续多按几个键后"松键不停"
    根因（上一版引入）：把 TMAX 计时改成"只在按住时累计"，并在松键时清零：
    if (!v_gate[i]) ... v_ts[i] <= 20'd0;
    键盘消抖本身有抖动（key_dual 有 60ms 释放窗），快速连按时
    v_gate: 1 1 0 1 1 0 1 1 0 ...
    v_ts : 5 6 0 1 2 0 1 2 0 ... ← 永远到不了 TMAX
    于是 v_act 永不清零 → 引擎持续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
    [add_engine_harm.v, add_top.v, hdmi_ui3_top.v, ws2812_keyind.v]
2026-11-02 REVERB 效果器（Freeverb）：8 梳状 + 4 全通，仿真 bit-exact 后上板
    算法来自 tools/fx_sim.py 的 reverb()（= Freeverb 结构）：
    COMB = [1236,1315,1414,1502,1574,1651,1724,1790] (48828 Hz)
    AP = [616,488,378,249] SPREAD=23 FB=0.88
    - src/fx/fx_reverb.v + tb_fx_reverb.v + tools/fx_reverb_check.py
    60000 样点 bit-exact
    三处与参考的有意差异：
    1) 单声道内核 + 左右双抽头（左读延迟 D、右读 D-23），内存减半。
    参考是左右两套完全独立（40 块 BSRAM），这里 24 块。
    代价：左右相关度高，立体声宽度略窄。
    2) 阻尼取 0.5 而不是 0.40 → fs=(rd+fs)>>1 一条移位，8 条共省 16 个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
2026-11-03 光学手势前端接入：音量+滑音打通（修好弯音真因）
    硬件链路
    - ir_tdm_ctrl：6 路 IR 发射 TDM，12.01 ms/帧 = 83.3 Hz
    - ad7606_serial：双 DOUT 串行读，SCLK 空闲高（CS 下降沿出 V1/V5 的 MSB）
    - ir_diff_filter：亮帧−暗帧 + 4 点滑动平均
    - opt_feat：rho_raw/rho_dc/rho_ac/ac_env/half_period
    - opt_pos：加权质心 → x_q8（10.45 cm 可用跨度）
    - position_control：x → 弯音（±700 音分，1.35 半音/cm），rho → 力度
    - report_feat：8 列 ASCII 上报（串口当前无数据，仅保留）
    修 BUG-6：弯音完全听不出来（音量却正常）
    根因：引擎里 Φ(v_pf) 是【已回绕到一圈（2^19）内的相位】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
    [ad7606_serial.v, add_engine_harm.v, add_top.v, ir_diff_filter.v, ir_tdm_ctrl.v, opt_feat.v, opt_pos.v]
2026-11-03 G5 指颤：左右大幅摇手 → 6 Hz ±204 音分颤音（唢呐）
    检测（position_control.v）
    - 从【原始】质心 x_last 取抖动（x_hold 已 96 ms 低通，6 Hz 会被衰减 3.6 倍）
    - x_dc 用更慢的低通（tau=32 帧≈384 ms）→ x_ac = x_last − x_dc
    - 判据用过零【间隔】5~20 帧（2.1~8.3 Hz）+ 幅度 >1.5 cm
    单向滑音只产生一次过零，间隔远大于 20 帧 → 不会误触发
    - 指颤期间冻结基准音高：摇手本身会把 x 拉来拉去（±3 cm=±400 音分），
    不冻结会和颤音叠成一团
    颤音生成（add_engine_harm.v）
    - 放在引擎里、音频速率：控制器只有 83.3 Hz 帧率，6 Hz 一个周期仅 14 个
    台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
2026-11-03 光学力度扩展到钢琴/古筝；修 ramp 8 位溢出噪声
    1) 光学力度覆盖钢琴/古筝（add_top.v）
    add_voice8 的 vel_gain 是【实时目标】（ramp 每次 +2/-1 向它收敛），
    不是按键瞬间锁存 → 连续喂 opt_vel 就是音量踏瓣：
    按住琴键、手抬起渐弱，压下渐强。
    wire vel_eng = opt_act ? {NVOICE{opt_vel}} : v_vel;
    opt_act = opt_en && (opt_vel>8)，手离开 6 s 后回退键盘力度。
    顺带发现：vel_ext = 8'd128 是常量，键盘其实完全不提供力度
    —— 之前钢琴/古筝所有音都是固定 128，这是它们第一个真正的动态控制。
    2) 修 BUG-7：手指贴近时钢琴/古筝有 366 Hz 锯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
    [add_top.v, add_voice8.v, tb_ramp.v]
2026-11-03 G2 古筝滑音 + 中央死区 + G3 颤音（三种音色）
    1) G2 古筝滑音（add_voice8 / add_engine8）
    加法合成的相位是真正的 32 位累加器（ph_n <= ph_q + inc），
    所以把每个分量的相位增量 rd0 乘音高比即可：
    inc_b = (rd0 × bend_q14) >> 14 // 48 位中间量，不溢出
    注意这与 add_engine_harm 完全不同：那里相位是模一圈的查表值，
    缩放会导致波形折返（BUG-6）。这里缩放增量才是对的。
    钢琴不接滑音（技法表 piano 无滑音）：add_top 里 is_gz ? bend : 16384。
    2) 中央死区（position_control）
    原来纯线性 135 音分/cm，手抖 1 mm 就是 13 音分，站不住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
    [add_engine8.v, add_engine_harm.v, add_top.v, add_voice8.v, position_control.v, tb_pos_ctl.v, tb_vib.v]
2026-11-03 G7 顿音/吐音 + G8 急停；有手才响；古筝横向噪音修复
    1) G7 顿音 / G8 急停（position_control + 两个引擎）
    G7：rho_raw 两帧平均差分 |dv| > 1200 码/帧，6 帧内反向 → 顿音
    （阈值 1200 是为了挡住 5 Hz 颤音的 716 码/帧）
    G8：改成【相对量】判据 rho_ac < −0.3125·rho_dc
    ★ 不能用单帧斜率：真实快速抬手约 100 ms，摊到每帧只有 ~950 码，
    低于挡住颤音所需的 1200 → 现场永远触发不了（实测踩过）
    ★ 输出【电平】不是脉冲：手拿开后慢基线还拖 300~400 ms，
    固定时长的静音会造成回光返照
    发声：唢呐/笛子/古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
    [add_engine8.v, add_engine_harm.v, add_top.v, add_voice8.v, position_control.v, tb_art.v]
2026-11-03 fx_reverb 全通级改饱和；新增满量程稳定性仿真
    现象：开了 REVERB 听起来全是噪声。先排除算法问题。
    1) tb_rev_full.v（新增）：满量程噪声输入 20000 点 → 静音 → 看尾巴
    ★ 原来的 tb_fx_reverb.v 用【单位脉冲】（幅度仅 17~35），
    根本没跑到满量程，所以 60000 点 bit-exact 也说明不了问题。
    结果：满量程输入后尾巴只剩 ±180 LSB（≈ −45 dBFS）的量化残留，
    混响本身不自激。改动前后都是 ±180，说明这不是现场噪声的根因。
    2) fx_reverb 全通级改成逐级饱和（防御性，未改变现有听感）
    原来是 amem_l[aa_wr] <= (ap_l[15:0]) + (rdl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
    [fx_reverb.v, position_control.v, tb_rev_full.v]
2026-11-03 新增设计文档：曲谱教学模式（SD 曲谱 + 下落音符）
    设计稿，未开工。要点：
    1) 两种模式
    - 自动演奏：系统按曲谱自己弹，人完全不参与
    - 教学指导：曲谱给音高，人按键（gate）+ 做手势（表情）
    2) 核心约定：音色和音高都自适应
    音高由曲谱事件直接驱动 eng_note，**和按哪个键无关**
    → 彻底绕开「8 键映射音域 / 换把位 / 转调」
    键只做 gate；手势叠加在曲谱音高之上
    3) 曲谱存 SD，一首歌一个 .P6S 文件（加法式加歌）
    格式：64 字节头（magic/timbre/count/duration/transpose/ASCII名/中文名点阵）
    + 8 字节事件（start_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
2026-11-03 BSRAM 优化：李萨如帧存 256x256 -> 128x128（省 24 块，95% -> 88%）
    背景：
    BSRAM 321/340 = 95%，只剩 19 块。虽然曲谱功能只要 3 块还够用，
    但 Gowin placer 在 BSRAM 接近满时布局不稳定（历史上反复出现
    「违例落在 u_ld/u_hdmi 而从不落在光学模块」，只能靠改网表扰动碰运气）。
    降到 88% 能给后续开发留出呼吸空间。
    改动 ui_liss_ram.v：
    - m[0:16383] -> m[0:4095]，LAST_A 14'd16383 -> 12'd4095
    - raddr / b_ra / b_wa / c_addr / d_addr 全部 14 位 -> 12 位
    - 地址公式 y*64 + x/4 -> y*32 + x/4
    - plot_x/plot_y 端口保持 8 位不变，内部 px7 = plot_x[7:1] 折扣
    - seg_ok 阈值 64 -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
2026-11-03 tb_art：新增 [8e] 横扫互斥测试；[8b] 去抖帧数改成 16 帧
    - [8e] 横向扫手时 rho_raw 短暂掉到门限以下，hand_on 必须仍为 1
    （否则混响会 chopping 噪声）。验证 lateral_mv 互斥逻辑
    - [8b] 手抽走跑 20 帧（去抖是 16 帧 = 192 ms），原来只跑 5 帧
    - 12/12 PASS，0 FAIL
    [tb_art.v]
2026-11-03 新增 PC 端曲谱生成工具 gen_song_v3.py，生成 4 首测试曲
    输出格式与队友 Android App / FPGA v3 协议【逐字节一致】，可直接拷进
    SD 卡根目录：
    A5 5A 03 | type | seq | len:LE16 | payload | crc16:LE16
    BEGIN(1): count:u16 duration_ms:u32 timbre:u8 flags:u8
    DATA (2): offset:u16 + 8 字节事件（start_ms:u32 note:u8 dur:u16 vel:u8）
    END (3): count:u16
    生成的 4 首（已拷入 SD 卡 /run/media/amigor/INSTRU）：
    SONG01.BIN 小星星-钢琴 47 事件 6690ms 峰值 4 声部 426 B (音域 36-83)
    SONG02.BIN 茉莉花-古筝 30 事件 7600ms 峰值 3 声部 279 B (音域 48-76)
    SONG03.BIN 小星星-唢呐 14 事件 5840ms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
2026-11-03 M1 曲谱加载链路：SD 字节流 -> 帧解析 -> 事件表 -> 4 声部播放（仿真通过）
    新增 src/song/：
    bt_frame_rx.v 复用队友 v3 帧解析器（CRC16 + 超时重同步）
    bt_song_player.v 复用队友毫秒调度器（8 声部，1 声部音色自动只占声部 0）
    song_loader.v bt_midi_top.v 的裁剪版：去掉 UART/ACK/命令帧，
    只保留 BEGIN/DATA/END 装填 + 全部字段校验
    song_fifo.v 512 字节 FWFT FIFO（关键，见下）
    ★★ 发现并修复一个会致命的坑：
    bt_frame_rx 在 valid=1 期间【完全忽略输入字节】，要等上层 consume。
    队友的 UART 115200 下每字节 87 us，处理 32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
    [bt_frame_rx.v, bt_song_player.v, song_fifo.v, song_loader.v, tb_song.v]
2026-11-03 完成 SD 曲谱播放与教学模式 M1–M5，优化音频控制并补齐验证
    接入曲谱目录、事件 RAM、双键菜单和半力度节拍兜底；支持 ±150 ms 匹配与不重触发的力度恢复。增加 SD CMD/DAT 模型、教学边界、DMA 和 HDMI 像素回归，以及构建来源和时序校验。完整构建 setup/hold 零违例；真实板卡听音与延迟验收待完成。
2026-11-03 修复教学菜单按键抖动导致的重复跳歌和确认
    菜单独立使用两级同步与按下/松开双边 40 ms 稳定消抖。新增物理电平抖动回归，复现旧扫描一次连跳并覆盖长按释放、模式切换和开始请求；完整功能回归通过。
    [add_top.v, song_menu_keys.v, tb_song_keys.v]
2026-11-03 固定菜单消抖版通过时序的布局算法并记录 SRAM 下载结果
    布局算法 3、布线算法 2：全局 setup/hold 零违例，最小报告 setup 余量 +0.009 ns。使用 SIPEED 下载器完成 SRAM 下载，openFPGALoader 返回 DONE；实际按键及听音等待现场复测。
2026-11-03 修复微动琴键假重触发和第八键松开后卡音
    演奏键改用按下/松开双边稳定确认；key_scan 增加异步引脚两级同步。扩大复音分配器键归属位宽，避免空闲标记与第八键冲突。新增抖动假边沿和八键独立释放回归，完整功能回归通过。
2026-11-03 让笛子和唢呐按 gate 持续吹奏并修正谐波阶数
2026-11-03 记录琴键与持续吹奏版完整回归、时序和 SRAM 下载结果
2026-11-03 保留笛子原生气颤并修复持续段、古筝揉弦和李萨如显示
2026-11-03 记录原生气颤与揉弦显示修复的构建和 SRAM 下载结果
2026-11-03 锁存完整 I2S 立体声帧，修复混响计算中途更新导致的噪音
2026-11-03 记录 I2S 混响噪音修复的完整构建、回归与 SRAM 下载
2026-11-03 Add adaptive multi-instrument lead teaching and native 1080p UI
    Preserve the three existing pages and original audio controls. Add role-aware score voices, falling notes, richer live displays and pipelined audio, SD, DDR and video paths. Functional regressions pass; final 1080p timing closure and board validation are still in progress.
2026-11-03 Preserve 1080p UI and audio timing optimization checkpoint
    Keep the three enhanced pages, mixed-instrument lead teaching and all audio fixes. Pipeline harmonic phase preparation and component peaks; shorten pixel and SD paths; align ten-stage RGB/sync rendering and add independent peak regression.
    Current full functional regressions pass and nine native RTL captures match the sources. Hardware build13 still fails setup timing (351 endpoints, worst -1.822 ns; hold 0). This is a source checkpoint, not validated firmware; no new SRAM download.
    [add_engine_harm.v, add_top.v, hdmi_ui3_top.v, sd_ddr_loader.v, tb_component_bars.v, tb_harm_hold.v]
2026-11-03 Compress harmonic and sine ROMs without changing samples
    Preserve local UI coordinates and balanced SD borrow nets. Build14 passes global setup/hold at native 1080p60 with 324/340 BSRAM; quarter sine candidate is fully regressed and build15 is pending. Preserve existing UI and audio fixes before BT36 SD persistence work.
    [add_sine_lut.v, harm_buf.v, hdmi_ui3_top.v, sd_ddr_loader.v, tb_harm_hw.v]
2026-11-03 Verify delivery copies against tested source fingerprints
2026-11-03 Solidify verified 720p60 Bluetooth SD build in board Flash
2026-11-03 Fix 720p HDMI with board-verified single PLL and record verified Flash
    [gowin_pll_720p.v, tb_song_ui.v, tb_ui_timing.v]
2026-11-03 Record ADC heartbeat limitation for physical keyboard acceptance
2026-11-04 Integrate board-visible single PLL 1080p path and record resolution trials
2026-11-04 Shorten measured SD DMA and HDMI paths for single PLL 1080p
    [check_production_link.py, dvi_tx_tmds_phy.v, fat32_song_store.v, suona_dma.v, tb_dma_image.v, tb_ui_controls.v]
2026-11-04 Verify diagnostic status through independent UART pin receiver
2026-11-04 Include reproducible UART check in full HDMI diagnostics
2026-11-04 Shorten two measured UI paths with exhaustive pixel-equivalence evidence
    [build_serial_clock.py, check_ui_equivalence.py, program_serial_clock.py, tb_ui_equivalence.v]
2026-11-04 Select accepted 1080p30 as default delivery and retire current 720p archive
